sim82/6502_sbc/kicad/hdctl_01/hdctl_01.kicad_pcb

## KiCad design kicad/hdctl_01/hdctl_01.kicad_pcb (2025-10-18)

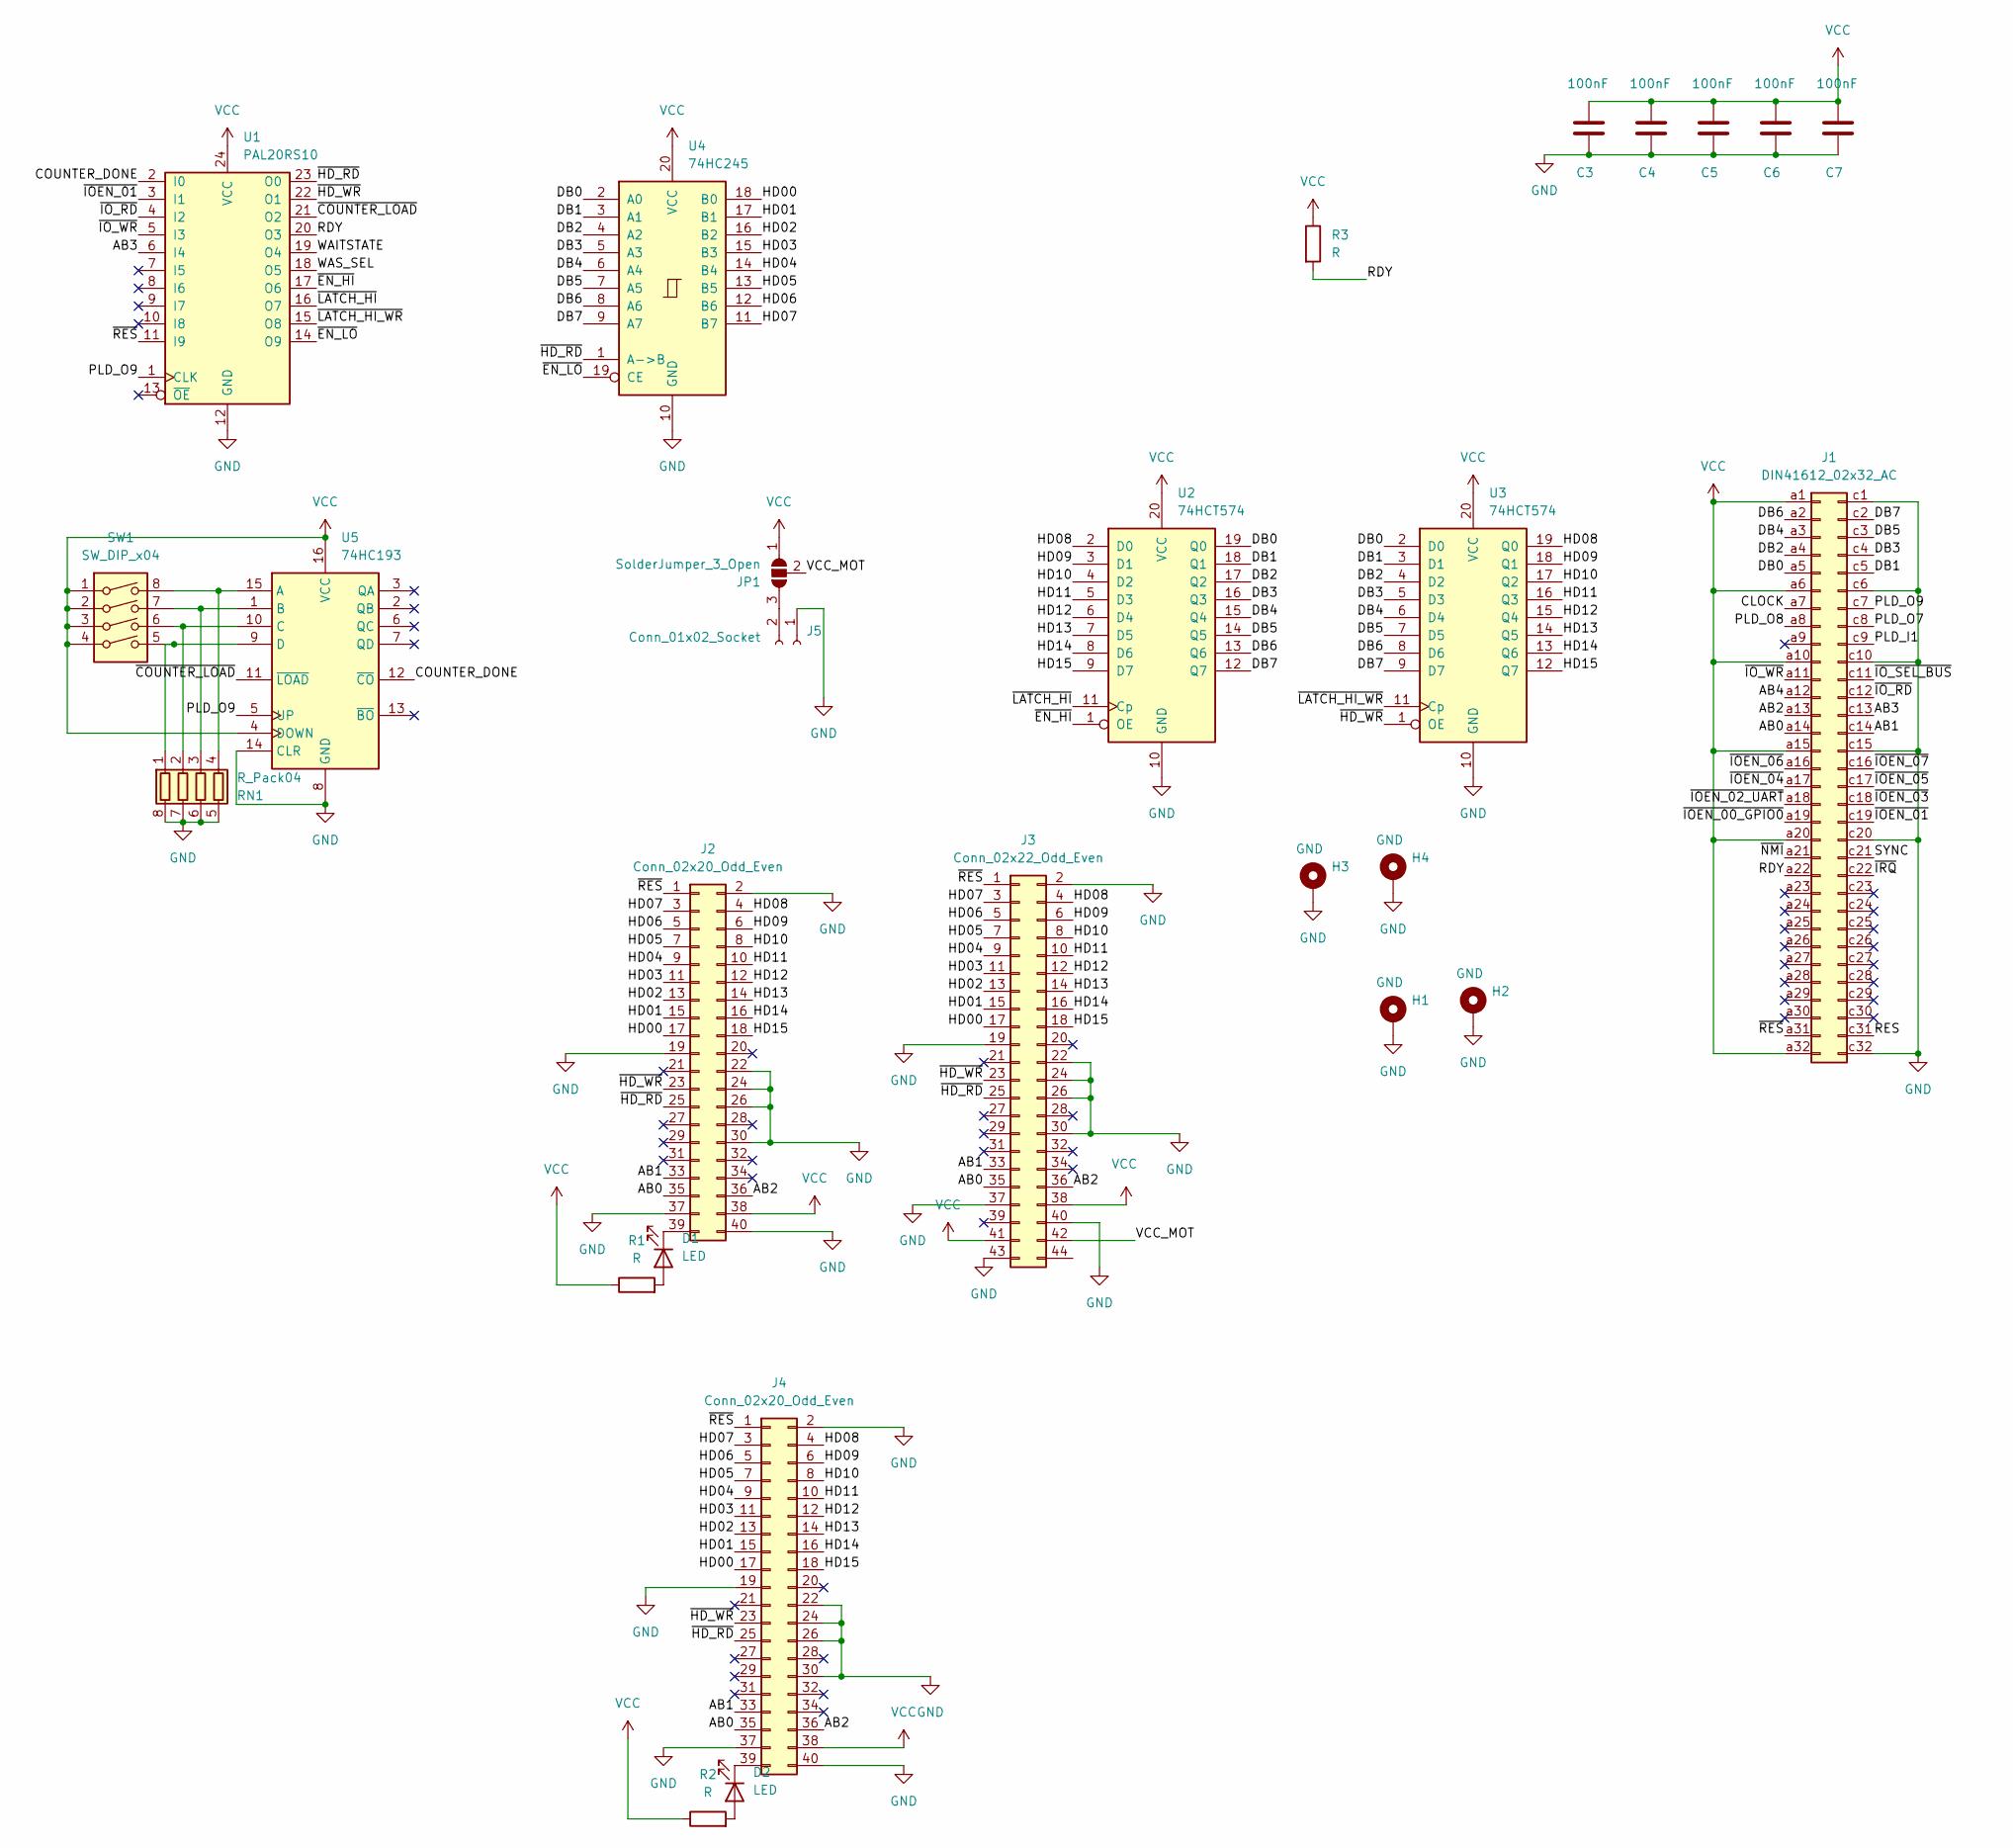
[picture p1: schematic hdctl_01.kicad_sch]

Parts:
C3, C4, C5, C6, C7: 100nF; C_0805_2012Metric_Pad1.18x1.45mm_HandSolder
D1, D2: LED; LED_0805_2012Metric_Pad1.15x1.40mm_HandSolder
H1, H2, H3, H4: GND; MountingHole_3.2mm_M3_DIN965_Pad
J1: DIN41612_02x32_AC; DIN41612_C_2x32_Male_Horizontal_THT
J2, J4: Conn_02x20_Odd_Even; IDC-Header_2x20_P2.54mm_Vertical
J3: Conn_02x22_Odd_Even; PinSocket_2x22_P2.00mm_Horizontal
J5: Conn_01x02_Socket; PinSocket_1x02_P2.54mm_Vertical
JP1: SolderJumper_3_Open; SolderJumper-3_P1.3mm_Open_RoundedPad1.0x1.5mm
R1, R2: R; R_0805_2012Metric_Pad1.20x1.40mm_HandSolder
R3: R; R_Axial_DIN0207_L6.3mm_D2.5mm_P7.62mm_Horizontal
RN1: R_Pack04; R_Array_Convex_4x0612
SW1: SW_DIP_x04; SW_DIP_SPSTx04_Slide_9.78x12.34mm_W8.61mm_P2.54mm
U1: PAL20RS10; DIP-24_W7.62mm_Socket
U2, U3: 74HCT574; SO-20_12.8x7.5mm_P1.27mm
U4: 74HC245; SO-20_12.8x7.5mm_P1.27mm
U5: 74HC193; SO-16_3.9x9.9mm_P1.27mm

Connections:
/AB0: J1.a14, J2.35, J3.35, J4.35
/AB1: J1.c14, J2.33, J3.33, J4.33
/AB2: J1.a13, J2.36, J3.36, J4.36
/AB3: J1.c13, U1.6 (I4)
/AB4: J1.a12
/CLOCK: J1.a7
/COUNTER_DONE: U1.2 (I0), U5.12 (~CO)
/DB0: J1.a5, U2.19 (Q0), U3.2 (D0), U4.2 (A0)
/DB1: J1.c5, U2.18 (Q1), U3.3 (D1), U4.3 (A1)
/DB2: J1.a4, U2.17 (Q2), U3.4 (D2), U4.4 (A2)
/DB3: J1.c4, U2.16 (Q3), U3.5 (D3), U4.5 (A3)
/DB4: J1.a3, U2.15 (Q4), U3.6 (D4), U4.6 (A4)
/DB5: J1.c3, U2.14 (Q5), U3.7 (D5), U4.7 (A5)
/DB6: J1.a2, U2.13 (Q6), U3.8 (D6), U4.8 (A6)
/DB7: J1.c2, U2.12 (Q7), U3.9 (D7), U4.9 (A7)
/HD00: J2.17, J3.17, J4.17, U4.18 (B0)
/HD01: J2.15, J3.15, J4.15, U4.17 (B1)
/HD02: J2.13, J3.13, J4.13, U4.16 (B2)
/HD03: J2.11, J3.11, J4.11, U4.15 (B3)
/HD04: J2.9, J3.9, J4.9, U4.14 (B4)
/HD05: J2.7, J3.7, J4.7, U4.13 (B5)
/HD06: J2.5, J3.5, J4.5, U4.12 (B6)
/HD07: J2.3, J3.3, J4.3, U4.11 (B7)
/HD08: J2.4, J3.4, J4.4, U2.2 (D0), U3.19 (Q0)
/HD09: J2.6, J3.6, J4.6, U2.3 (D1), U3.18 (Q1)
/HD10: J2.8, J3.8, J4.8, U2.4 (D2), U3.17 (Q2)
/HD11: J2.10, J3.10, J4.10, U2.5 (D3), U3.16 (Q3)
/HD12: J2.12, J3.12, J4.12, U2.6 (D4), U3.15 (Q4)
/HD13: J2.14, J3.14, J4.14, U2.7 (D5), U3.14 (Q5)
/HD14: J2.16, J3.16, J4.16, U2.8 (D6), U3.13 (Q6)
/HD15: J2.18, J3.18, J4.18, U2.9 (D7), U3.12 (Q7)
/PLD_I1: J1.c9
/PLD_O7: J1.c8
/PLD_O8: J1.a8
/PLD_O9: J1.c7, U1.1 (CLK), U5.5 (UP)
/RDY: J1.a22, R3.2, U1.20 (O3)
/RES: J1.c31
/SYNC: J1.c21
/VCC_MOT: J3.42, JP1.2 (C)
/WAITSTATE: U1.19 (O4)
/WAS_SEL: U1.18 (O5)
/~COUNTER_LOAD: U1.21 (O2), U5.11 (~LOAD)
/~EN_HI: U1.17 (O6), U2.1 (OE)
/~EN_LO: U1.14 (O9), U4.19 (CE)
/~HD_RD: J2.25, J3.25, J4.25, U1.23 (O0), U4.1 (A->B)
/~HD_WR: J2.23, J3.23, J4.23, U1.22 (O1), U3.1 (OE)
/~IOEN_00_GPIO0: J1.a19
/~IOEN_01: J1.c19, U1.3 (I1)
/~IOEN_02_UART: J1.a18
/~IOEN_03: J1.c18
/~IOEN_04: J1.a17
/~IOEN_05: J1.c17
/~IOEN_06: J1.a16
/~IOEN_07: J1.c16
/~IO_RD: J1.c12, U1.4 (I2)
/~IO_SEL_BUS: J1.c11
/~IO_WR: J1.a11, U1.5 (I3)
/~IRQ: J1.c22
/~LATCH_HI_WR: U1.15 (O8), U3.11 (Cp)
/~LATCH_HI: U1.16 (O7), U2.11 (Cp)
/~NMI: J1.a21
/~RES: J1.a31, J2.1, J3.1, J4.1, U1.11 (I9)
GND: C3.2, C4.2, C5.2, C6.2, C7.2, H1.1, H2.1, H3.1, H4.1, J1.c1, J1.c6, J1.c10, J1.c15, J1.c20, J1.c32, J2.2, J2.19, J2.22, J2.24, J2.26, J2.30, J2.37, J2.40, J3.2, J3.19, J3.22, J3.24, J3.26, J3.30, J3.37, J3.40, J3.43, J4.2, J4.19, J4.22, J4.24, J4.26, J4.30, J4.37, J4.40, J5.1, RN1.5 (R4.2), RN1.6 (R3.2), RN1.7 (R2.2), RN1.8 (R1.2), U1.12 (GND), U2.10 (GND), U3.10 (GND), U4.10 (GND), U5.8 (GND), U5.14 (CLR)
unnamed: D1.2 (A), R1.2
unnamed: D1.1 (K), J2.39
unnamed: D2.2 (A), R2.2
unnamed: D2.1 (K), J4.39
unnamed: J5.2, JP1.3 (B)
unnamed: RN1.1 (R1.1), SW1.5, U5.9 (D)
unnamed: RN1.2 (R2.1), SW1.6, U5.10 (C)
unnamed: RN1.3 (R3.1), SW1.7, U5.1 (B)
unnamed: RN1.4 (R4.1), SW1.8, U5.15 (A)
VCC: C3.1, C4.1, C5.1, C6.1, C7.1, J1.a1, J1.a6, J1.a10, J1.a15, J1.a20, J1.a32, J2.38, J3.38, J3.41, J4.38, JP1.1 (A), R1.1, R2.1, R3.1, SW1.1, SW1.2, SW1.3, SW1.4, U1.24 (VCC), U2.20 (VCC), U3.20 (VCC), U4.20 (VCC), U5.4 (DOWN), U5.16 (VCC)

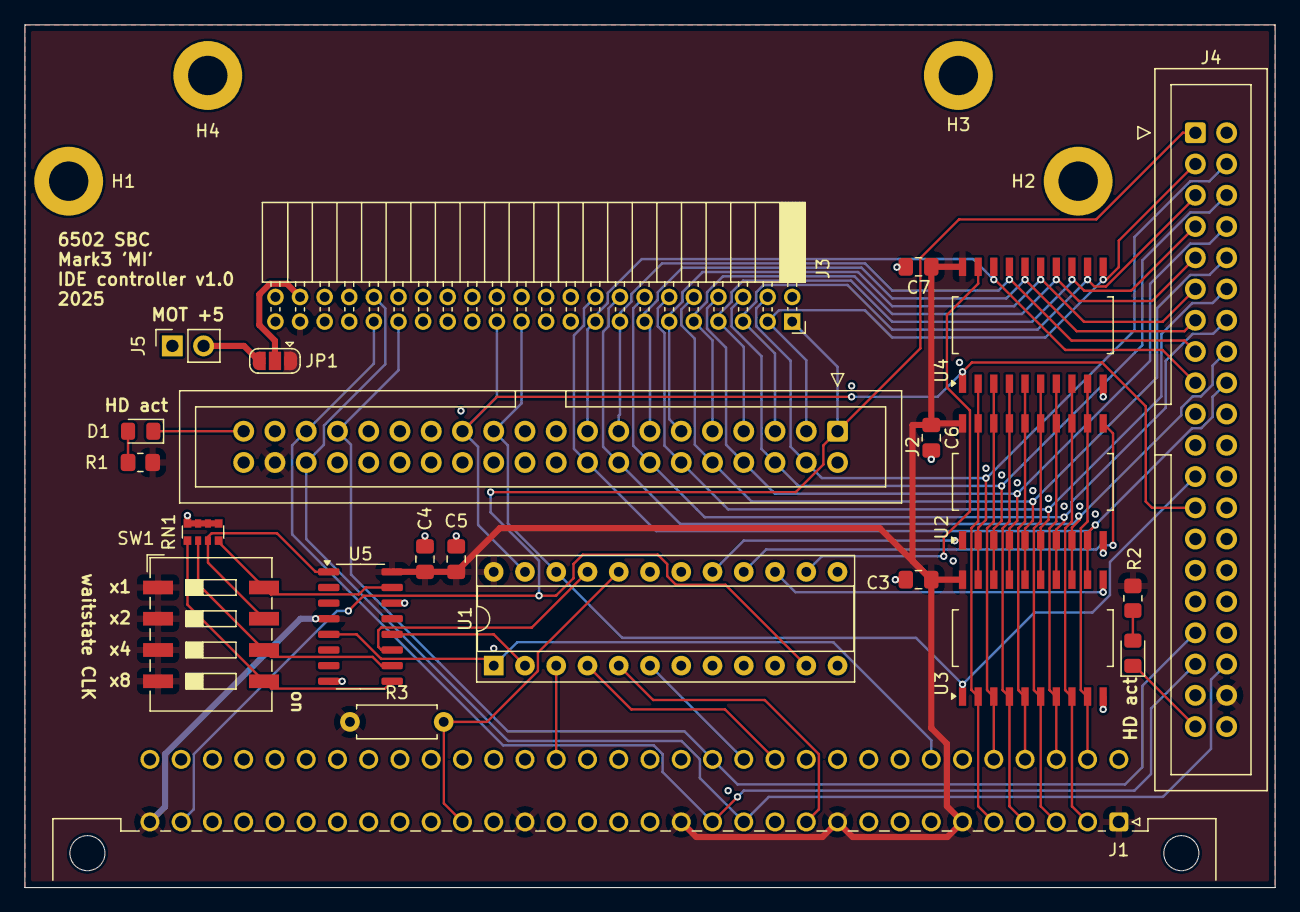
[picture p2: board hdctl_01.kicad_pcb from above]

Board: 4 copper layers, 101.6 x 70.1 mm, 27 parts (0 on the bottom side), 54 nets.
