sim82/6502_sbc/kicad/cpu_board_03_4l/cpu_board_03_4l.kicad_pcb

## KiCad design kicad/cpu_board_03_4l/cpu_board_03_4l.kicad_pcb (2025-10-05)

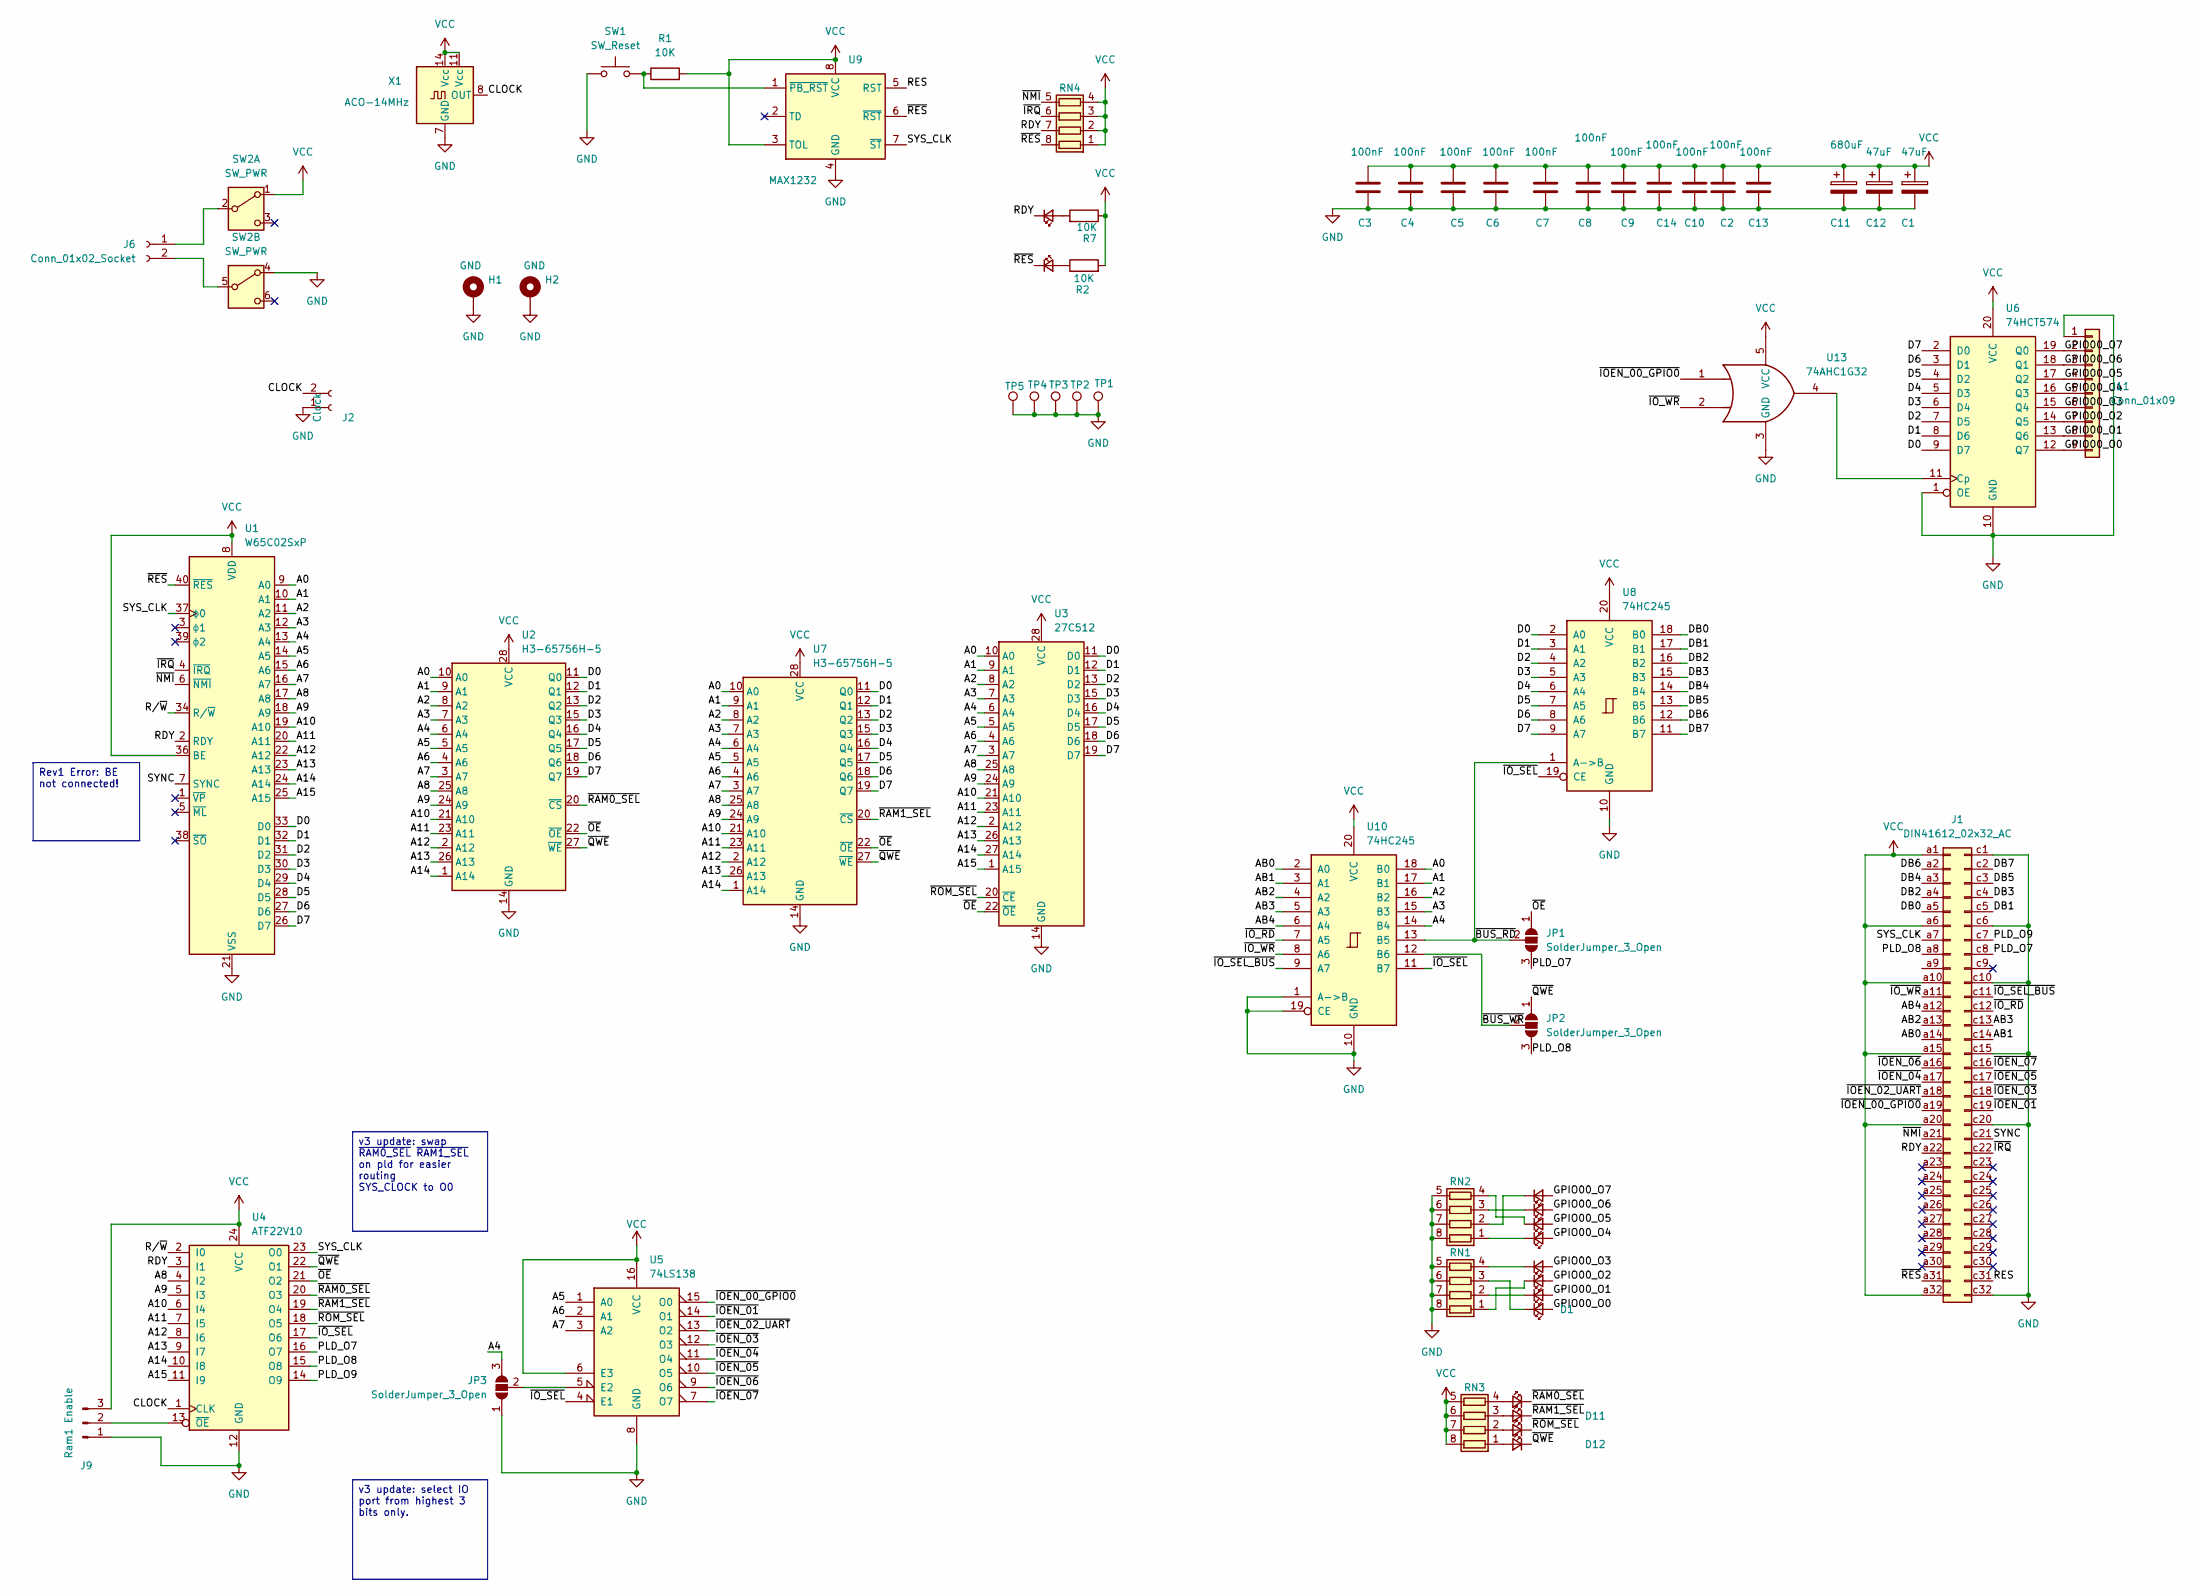
[picture p3: schematic cpu_board_03_4l.kicad_sch]

Parts:
C1, C12: 47uF; CP_Radial_D4.0mm_P2.00mm
C2, C3, C4, C5, C6, C7, C8, C9, C10, C13, C14: 100nF; C_0805_2012Metric_Pad1.18x1.45mm_HandSolder
C11: 680uF; CP_Radial_D8.0mm_P5.00mm
D1, D2, D3, D4, D5, D6, D7, D8, D9, D10, D11, D12, D13, D14: LED_Small; LED_0805_2012Metric_Pad1.15x1.40mm_HandSolder
H1, H2: GND; MountingHole_3.2mm_M3_DIN965_Pad
J1: DIN41612_02x32_AC; DIN41612_C_2x32_Male_Horizontal_THT
J2: Clock; PinSocket_1x02_P2.54mm_Vertical
J6: Conn_01x02_Socket; PinSocket_1x02_P2.54mm_Vertical
J9: Ram1 Enable; PinHeader_1x03_P2.54mm_Vertical
J11: Conn_01x09; PinSocket_1x09_P2.54mm_Vertical
JP1, JP2, JP3: SolderJumper_3_Open; SolderJumper-3_P1.3mm_Open_RoundedPad1.0x1.5mm
R1, R2, R7: 10K; R_0805_2012Metric_Pad1.20x1.40mm_HandSolder
RN1, RN2, RN3, RN4: R_Pack04; R_Array_Convex_4x0612
SW1: SW_Reset; SW_TH_Tactile_Omron_B3F-10xx
SW2: SW_PWR; 7x7DPDT
TP1, TP2, TP3, TP4, TP5: TestPoint; TestPoint_Loop_D1.80mm_Drill1.0mm_Beaded
U1: W65C02SxP; DIP-40_W15.24mm_Socket
U2, U7: H3-65756H-5; DIP-28_W7.62mm_Socket
U3: 27C512; DIP-28_W15.24mm_Socket
U4: ATF22V10; DIP-24_W7.62mm_Socket
U5: 74LS138; SO-16_3.9x9.9mm_P1.27mm
U6: 74HCT574; SO-20_12.8x7.5mm_P1.27mm
U8, U10: 74HC245; SO-20_12.8x7.5mm_P1.27mm
U9: MAX1232; SO-8_3.9x4.9mm_P1.27mm
U13: 74AHC1G32; SOT-23-5_HandSoldering
X1: ACO-14MHz; DIP-14_W7.62mm_Socket

Connections:
/A0: U1.9 (A0), U2.10 (A0), U3.10 (A0), U7.10 (A0), U10.18 (B0)
/A1: U1.10 (A1), U2.9 (A1), U3.9 (A1), U7.9 (A1), U10.17 (B1)
/A2: U1.11 (A2), U2.8 (A2), U3.8 (A2), U7.8 (A2), U10.16 (B2)
/A3: U1.12 (A3), U2.7 (A3), U3.7 (A3), U7.7 (A3), U10.15 (B3)
/A4: JP3.3 (B), U1.13 (A4), U2.6 (A4), U3.6 (A4), U7.6 (A4), U10.14 (B4)
/A5: U1.14 (A5), U2.5 (A5), U3.5 (A5), U5.1 (A0), U7.5 (A5)
/A6: U1.15 (A6), U2.4 (A6), U3.4 (A6), U5.2 (A1), U7.4 (A6)
/A7: U1.16 (A7), U2.3 (A7), U3.3 (A7), U5.3 (A2), U7.3 (A7)
/A8: U1.17 (A8), U2.25 (A8), U3.25 (A8), U4.4 (I2), U7.25 (A8)
/A9: U1.18 (A9), U2.24 (A9), U3.24 (A9), U4.5 (I3), U7.24 (A9)
/A10: U1.19 (A10), U2.21 (A10), U3.21 (A10), U4.6 (I4), U7.21 (A10)
/A11: U1.20 (A11), U2.23 (A11), U3.23 (A11), U4.7 (I5), U7.23 (A11)
/A12: U1.22 (A12), U2.2 (A12), U3.2 (A12), U4.8 (I6), U7.2 (A12)
/A13: U1.23 (A13), U2.26 (A13), U3.26 (A13), U4.9 (I7), U7.26 (A13)
/A14: U1.24 (A14), U2.1 (A14), U3.27 (A14), U4.10 (I8), U7.1 (A14)
/A15: U1.25 (A15), U3.1 (A15), U4.11 (I9)
/AB0: J1.a14, U10.2 (A0)
/AB1: J1.c14, U10.3 (A1)
/AB2: J1.a13, U10.4 (A2)
/AB3: J1.c13, U10.5 (A3)
/AB4: J1.a12, U10.6 (A4)
/CLOCK: J2.2, U4.1 (CLK), X1.8 (OUT)
/D0: U1.33 (D0), U2.11 (Q0), U3.11 (D0), U6.9 (D7), U7.11 (Q0), U8.2 (A0)
/D1: U1.32 (D1), U2.12 (Q1), U3.12 (D1), U6.8 (D6), U7.12 (Q1), U8.3 (A1)
/D2: U1.31 (D2), U2.13 (Q2), U3.13 (D2), U6.7 (D5), U7.13 (Q2), U8.4 (A2)
/D3: U1.30 (D3), U2.15 (Q3), U3.15 (D3), U6.6 (D4), U7.15 (Q3), U8.5 (A3)
/D4: U1.29 (D4), U2.16 (Q4), U3.16 (D4), U6.5 (D3), U7.16 (Q4), U8.6 (A4)
/D5: U1.28 (D5), U2.17 (Q5), U3.17 (D5), U6.4 (D2), U7.17 (Q5), U8.7 (A5)
/D6: U1.27 (D6), U2.18 (Q6), U3.18 (D6), U6.3 (D1), U7.18 (Q6), U8.8 (A6)
/D7: U1.26 (D7), U2.19 (Q7), U3.19 (D7), U6.2 (D0), U7.19 (Q7), U8.9 (A7)
/DB0: J1.a5, U8.18 (B0)
/DB1: J1.c5, U8.17 (B1)
/DB2: J1.a4, U8.16 (B2)
/DB3: J1.c4, U8.15 (B3)
/DB4: J1.a3, U8.14 (B4)
/DB5: J1.c3, U8.13 (B5)
/DB6: J1.a2, U8.12 (B6)
/DB7: J1.c2, U8.11 (B7)
/GPIO00_O0: D1.2 (A), J11.9, U6.12 (Q7)
/GPIO00_O1: D2.2 (A), J11.8, U6.13 (Q6)
/GPIO00_O2: D3.2 (A), J11.7, U6.14 (Q5)
/GPIO00_O3: D4.2 (A), J11.6, U6.15 (Q4)
/GPIO00_O4: D5.2 (A), J11.5, U6.16 (Q3)
/GPIO00_O5: D6.2 (A), J11.4, U6.17 (Q2)
/GPIO00_O6: D7.2 (A), J11.3, U6.18 (Q1)
/GPIO00_O7: D8.2 (A), J11.2, U6.19 (Q0)
/PLD_O7: J1.c8, JP1.3 (B), U4.16 (O7)
/PLD_O8: J1.a8, JP2.3 (B), U4.15 (O8)
/PLD_O9: J1.c7, U4.14 (O9)
/RDY: D14.1 (K), J1.a22, RN4.7 (R2.2), U1.2 (RDY), U4.3 (I1)
/RES: J1.c31, U9.5 (RST)
/R/~W: U1.34 (R/~W), U4.2 (I0)
/SYNC: J1.c21, U1.7 (SYNC)
/SYS_CLK: J1.a7, U1.37 (ϕ0), U4.23 (O0), U9.7 (~ST)
/~BUS_RD: JP1.2 (C), U8.1 (A->B), U10.13 (B5)
/~BUS_WR: JP2.2 (C), U10.12 (B6)
/~IOEN_00_GPIO0: J1.a19, U5.15 (O0), U13.1
/~IOEN_01: J1.c19, U5.14 (O1)
/~IOEN_02_UART: J1.a18, U5.13 (O2)
/~IOEN_03: J1.c18, U5.12 (O3)
/~IOEN_04: J1.a17, U5.11 (O4)
/~IOEN_05: J1.c17, U5.10 (O5)
/~IOEN_06: J1.a16, U5.9 (O6)
/~IOEN_07: J1.c16, U5.7 (O7)
/~IO_RD: J1.c12, U10.7 (A5)
/~IO_SEL_BUS: J1.c11, U10.9 (A7)
/~IO_SEL: U4.17 (O6), U5.4 (E1), U8.19 (CE), U10.11 (B7)
/~IO_WR: J1.a11, U10.8 (A6), U13.2
/~IRQ: J1.c22, RN4.6 (R3.2), U1.4 (~IRQ)
/~NMI: J1.a21, RN4.5 (R4.2), U1.6 (~NMI)
/~OE: JP1.1 (A), U2.22 (~OE), U3.22 (~OE), U4.21 (O2), U7.22 (~OE)
/~QWE: D12.1 (K), JP2.1 (A), U2.27 (~WE), U4.22 (O1), U7.27 (~WE)
/~RAM0_SEL: D10.1 (K), U2.20 (~CS), U4.20 (O3)
/~RAM1_SEL: D11.1 (K), U4.19 (O4), U7.20 (~CS)
/~RES: D13.1 (K), J1.a31, RN4.8 (R1.2), U1.40 (~RES), U9.6 (~RST)
/~ROM_SEL: D9.1 (K), U3.20 (~CE), U4.18 (O5)
GND: C1.2, C2.2, C3.2, C4.2, C5.2, C6.2, C7.2, C8.2, C9.2, C10.2, C11.2, C12.2, C13.2, C14.2, H1.1, H2.1, J1.c1, J1.c6, J1.c10, J1.c15, J1.c20, J1.c32, J2.1, J9.1, J11.1, JP3.1 (A), RN1.5 (R4.2), RN1.6 (R3.2), RN1.7 (R2.2), RN1.8 (R1.2), RN2.5 (R4.2), RN2.6 (R3.2), RN2.7 (R2.2), RN2.8 (R1.2), SW1.2, SW2.4 (A), TP1.1, TP2.1, TP3.1, TP4.1, TP5.1, U1.21 (VSS), U2.14 (GND), U3.14 (GND), U4.12 (GND), U5.8 (GND), U6.1 (OE), U6.10 (GND), U7.14 (GND), U8.10 (GND), U9.4 (GND), U10.1 (A->B), U10.10 (GND), U10.19 (CE), U13.3 (GND), X1.7 (GND)
unnamed: D1.1 (K), RN1.3 (R3.1)
unnamed: D2.1 (K), RN1.2 (R2.1)
unnamed: D3.1 (K), RN1.1 (R1.1)
unnamed: D4.1 (K), RN1.4 (R4.1)
unnamed: D5.1 (K), RN2.1 (R1.1)
unnamed: D6.1 (K), RN2.4 (R4.1)
unnamed: D7.1 (K), RN2.3 (R3.1)
unnamed: D8.1 (K), RN2.2 (R2.1)
unnamed: D9.2 (A), RN3.2 (R2.1)
unnamed: D10.2 (A), RN3.4 (R4.1)
unnamed: D11.2 (A), RN3.3 (R3.1)
unnamed: D12.2 (A), RN3.1 (R1.1)
unnamed: D13.2 (A), R2.1
unnamed: D14.2 (A), R7.2
unnamed: J6.1, SW2.2 (B)
unnamed: J6.2, SW2.5 (B)
unnamed: J9.2, U4.13 (~OE)
unnamed: JP3.2 (C), U5.5 (E2)
unnamed: U6.11 (Cp), U13.4
unnamed: R1.1, SW1.1, U9.1 (~PB_RST)
VCC: C1.1, C2.1, C3.1, C4.1, C5.1, C6.1, C7.1, C8.1, C9.1, C10.1, C11.1, C12.1, C13.1, C14.1, J1.a1, J1.a6, J1.a10, J1.a15, J1.a20, J1.a32, J9.3, R1.2, R2.2, R7.1, RN3.5 (R4.2), RN3.6 (R3.2), RN3.7 (R2.2), RN3.8 (R1.2), RN4.1 (R1.1), RN4.2 (R2.1), RN4.3 (R3.1), RN4.4 (R4.1), SW2.1 (A), U1.8 (VDD), U1.36 (BE), U2.28 (VCC), U3.28 (VCC), U4.24 (VCC), U5.6 (E3), U5.16 (VCC), U6.20 (VCC), U7.28 (VCC), U8.20 (VCC), U9.3 (TOL), U9.8 (VCC), U10.20 (VCC), U13.5 (VCC), X1.11 (Vcc), X1.14 (Vcc)

Notes on the sheet:
Rev1 Error: BE not connected!
v3 update: select IO port from highest 3 bits only.
v3 update: swap ~{RAM0_SEL} ~{RAM1_SEL} on pld for easier routing SYS_CLOCK to O0

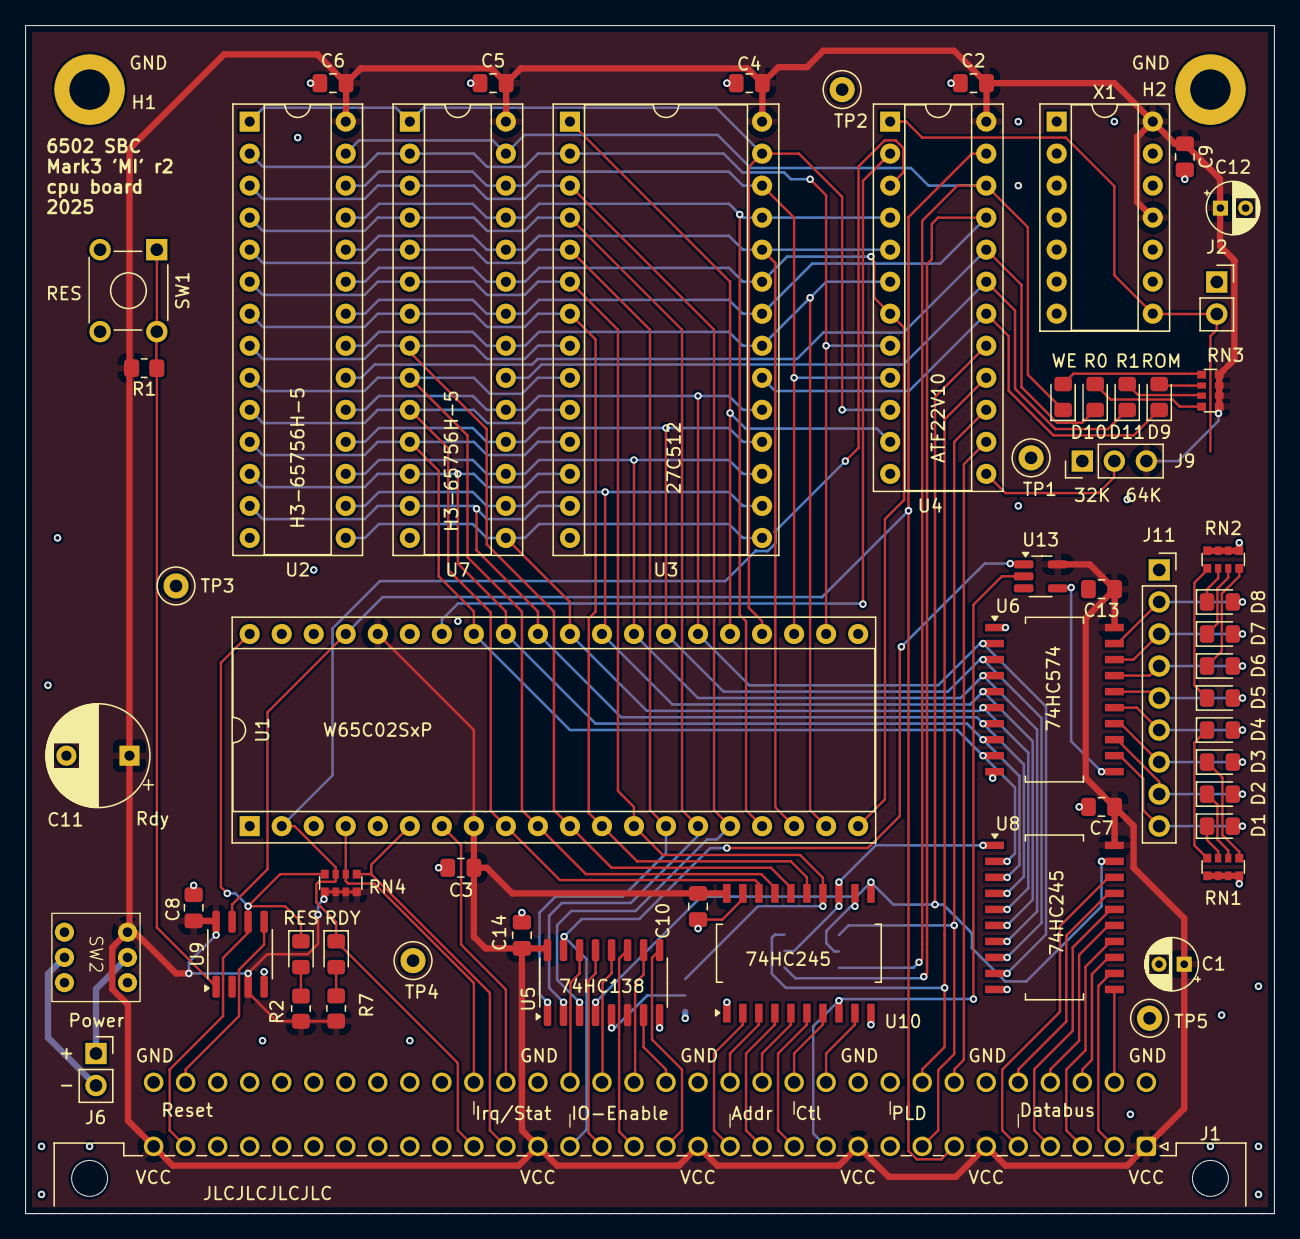
[picture p4: board cpu_board_03_4l.kicad_pcb from above]

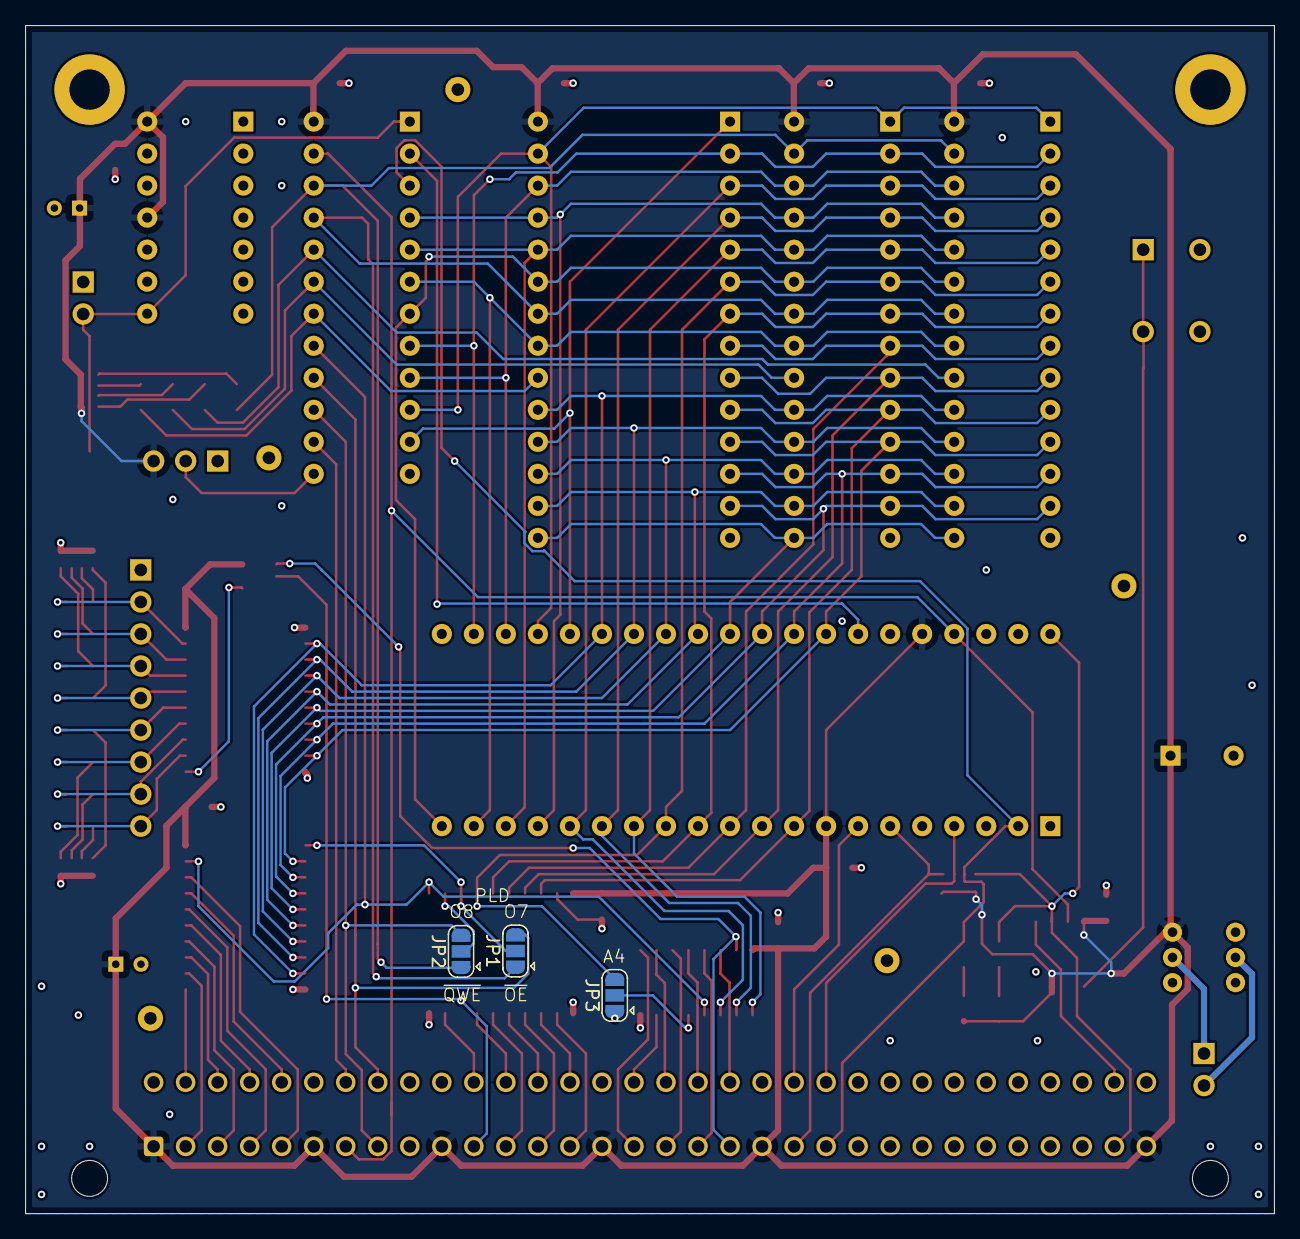
[picture p5: board cpu_board_03_4l.kicad_pcb from below]

Board: 4 copper layers, 99.1 x 94.2 mm, 64 parts (3 on the bottom side), 98 nets.
