sim82/6502_sbc/kicad/vga_mem_output_01_4l/vga_mem_output_01_4l.kicad_pcb

## KiCad design kicad/vga_mem_output_01_4l/vga_mem_output_01_4l.kicad_pcb (2025-09-13)

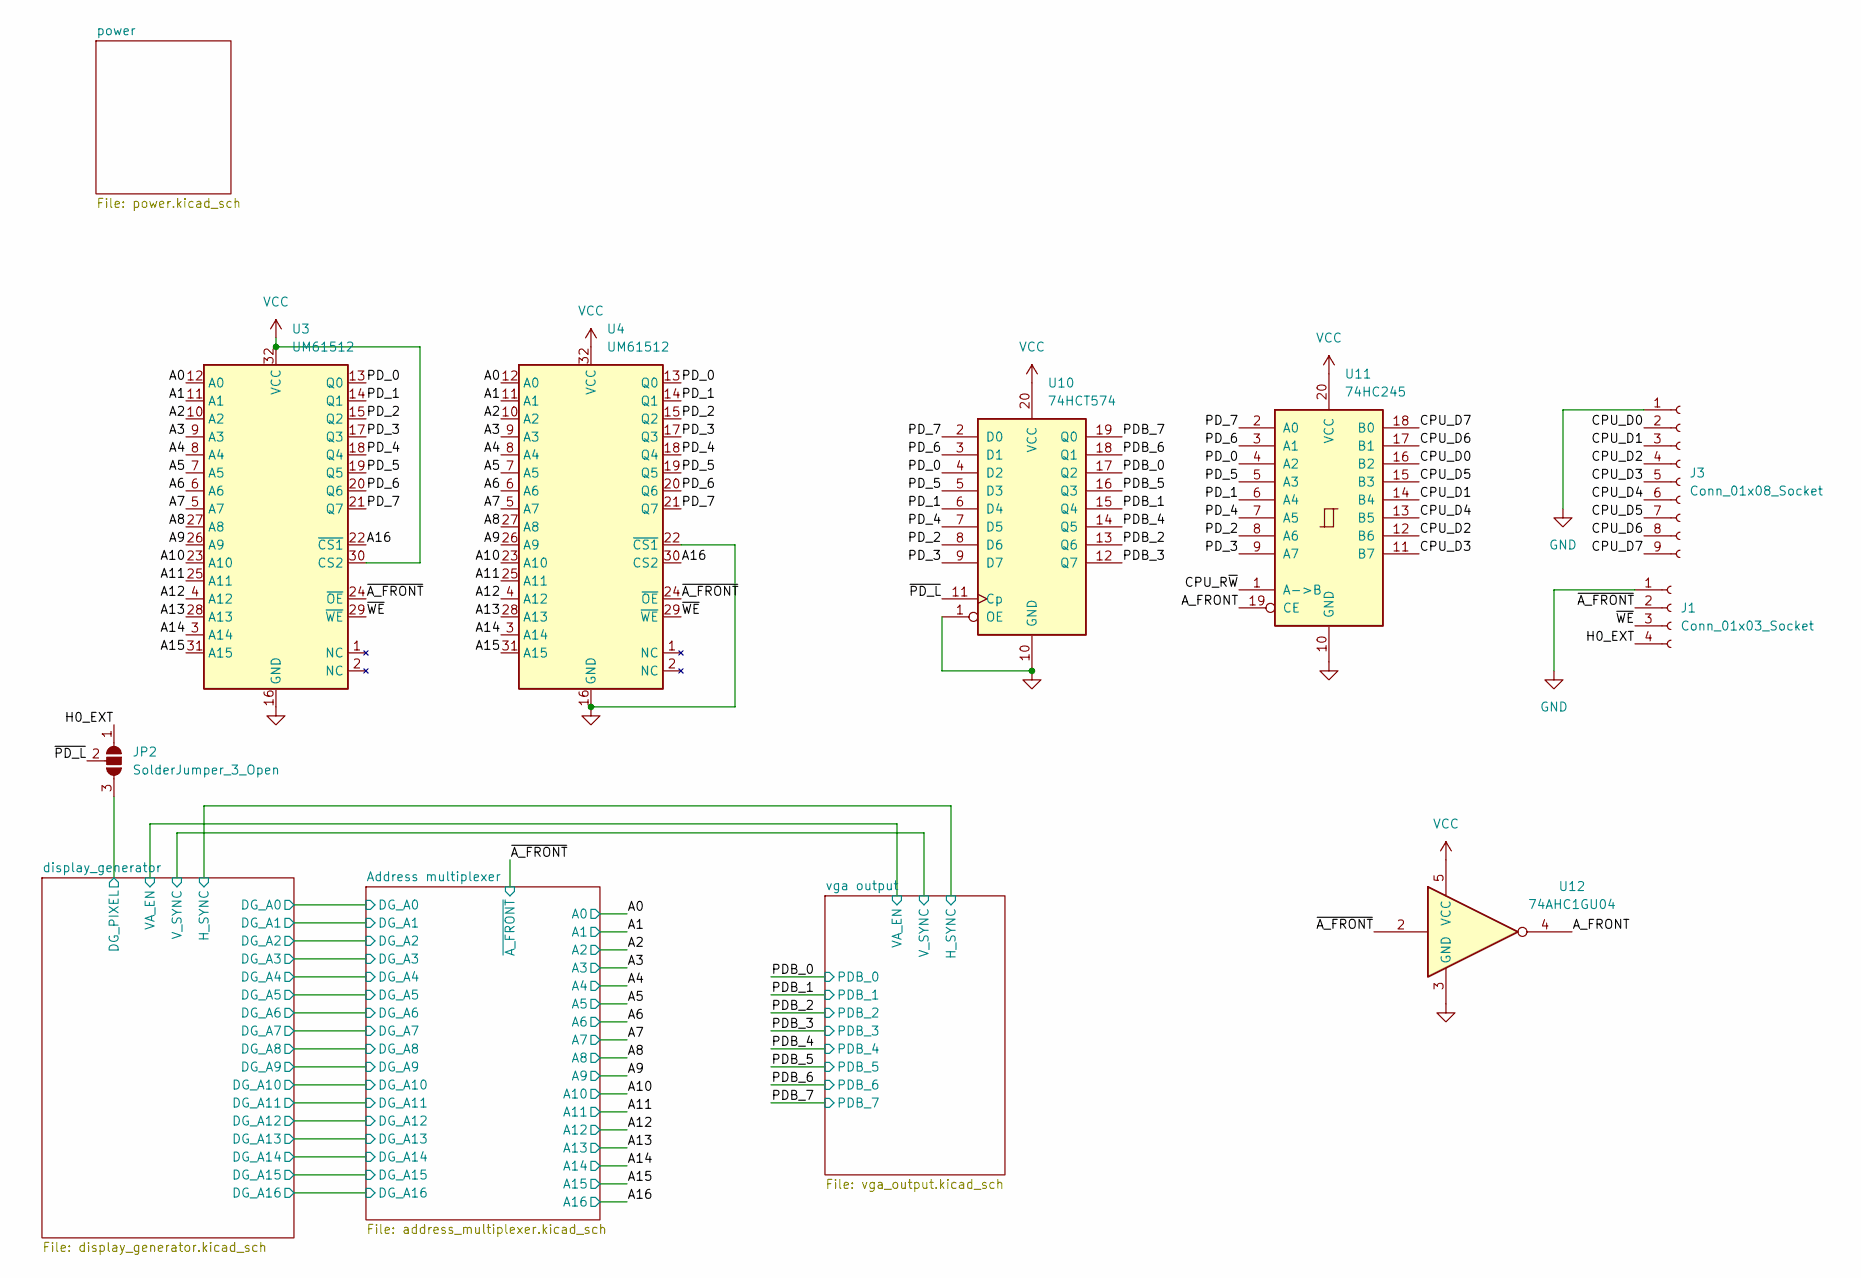
[picture p6: schematic vga_mem_output_01_4l.kicad_sch]

Parts:
J1: Conn_01x03_Socket; PinSocket_1x04_P2.54mm_Vertical
J3: Conn_01x08_Socket; PinSocket_1x09_P2.54mm_Vertical
JP2: SolderJumper_3_Open; SolderJumper-3_P1.3mm_Open_RoundedPad1.0x1.5mm
U3, U4: UM61512; DIP-32_W7.62mm
U10: 74HCT574; SO-20_12.8x7.5mm_P1.27mm
U11: 74HC245; SO-20_12.8x7.5mm_P1.27mm
U12: 74AHC1GU04; SOT-23-5_HandSoldering

Connections:
/A0: U3.12 (A0), U4.12 (A0); also elsewhere on the board
/A1: U3.11 (A1), U4.11 (A1); also elsewhere on the board
/A2: U3.10 (A2), U4.10 (A2); also elsewhere on the board
/A3: U3.9 (A3), U4.9 (A3); also elsewhere on the board
/A4: U3.8 (A4), U4.8 (A4); also elsewhere on the board
/A5: U3.7 (A5), U4.7 (A5); also elsewhere on the board
/A6: U3.6 (A6), U4.6 (A6); also elsewhere on the board
/A7: U3.5 (A7), U4.5 (A7); also elsewhere on the board
/A8: U3.27 (A8), U4.27 (A8); also elsewhere on the board
/A9: U3.26 (A9), U4.26 (A9); also elsewhere on the board
/A10: U3.23 (A10), U4.23 (A10); also elsewhere on the board
/A11: U3.25 (A11), U4.25 (A11); also elsewhere on the board
/A12: U3.4 (A12), U4.4 (A12); also elsewhere on the board
/A13: U3.28 (A13), U4.28 (A13); also elsewhere on the board
/A14: U3.3 (A14), U4.3 (A14); also elsewhere on the board
/A15: U3.31 (A15), U4.31 (A15); also elsewhere on the board
/A16: U3.22 (~CS1), U4.30 (CS2); also elsewhere on the board
/A_FRONT: U11.19 (CE), U12.4
/CPU_D0: J3.2, U11.16 (B2)
/CPU_D1: J3.3, U11.14 (B4)
/CPU_D2: J3.4, U11.12 (B6)
/CPU_D3: J3.5, U11.11 (B7)
/CPU_D4: J3.6, U11.13 (B5)
/CPU_D5: J3.7, U11.15 (B3)
/CPU_D6: J3.8, U11.17 (B1)
/CPU_D7: J3.9, U11.18 (B0)
/CPU_R~W: U11.1 (A->B)
/H0_EXT: J1.4, JP2.1 (A)
/PDB_0: U10.17 (Q2); also elsewhere on the board
/PDB_1: U10.15 (Q4); also elsewhere on the board
/PDB_2: U10.13 (Q6); also elsewhere on the board
/PDB_3: U10.12 (Q7); also elsewhere on the board
/PDB_4: U10.14 (Q5); also elsewhere on the board
/PDB_5: U10.16 (Q3); also elsewhere on the board
/PDB_6: U10.18 (Q1); also elsewhere on the board
/PDB_7: U10.19 (Q0); also elsewhere on the board
/PD_0: U3.13 (Q0), U4.13 (Q0), U10.4 (D2), U11.4 (A2)
/PD_1: U3.14 (Q1), U4.14 (Q1), U10.6 (D4), U11.6 (A4)
/PD_2: U3.15 (Q2), U4.15 (Q2), U10.8 (D6), U11.8 (A6)
/PD_3: U3.17 (Q3), U4.17 (Q3), U10.9 (D7), U11.9 (A7)
/PD_4: U3.18 (Q4), U4.18 (Q4), U10.7 (D5), U11.7 (A5)
/PD_5: U3.19 (Q5), U4.19 (Q5), U10.5 (D3), U11.5 (A3)
/PD_6: U3.20 (Q6), U4.20 (Q6), U10.3 (D1), U11.3 (A1)
/PD_7: U3.21 (Q7), U4.21 (Q7), U10.2 (D0), U11.2 (A0)
/display_generator/H0: JP2.3 (B); also elsewhere on the board
/~A_FRONT: J1.2, U3.24 (~OE), U4.24 (~OE), U12.2; also elsewhere on the board
/~PD_L: JP2.2 (C), U10.11 (Cp)
/~WE: J1.3, U3.29 (~WE), U4.29 (~WE)
GND: J1.1, J3.1, U3.16 (GND), U4.16 (GND), U4.22 (~CS1), U10.1 (OE), U10.10 (GND), U11.10 (GND), U12.3 (GND); also elsewhere on the board
VCC: U3.30 (CS2), U3.32 (VCC), U4.32 (VCC), U10.20 (VCC), U11.20 (VCC), U12.5 (VCC); also elsewhere on the board
