sim82/6502_sbc/kicad/vga_mem_output_01_4l/vga_mem_output_01_4l.kicad_pcb

## KiCad design kicad/vga_mem_output_01_4l/vga_mem_output_01_4l.kicad_pcb (continued)

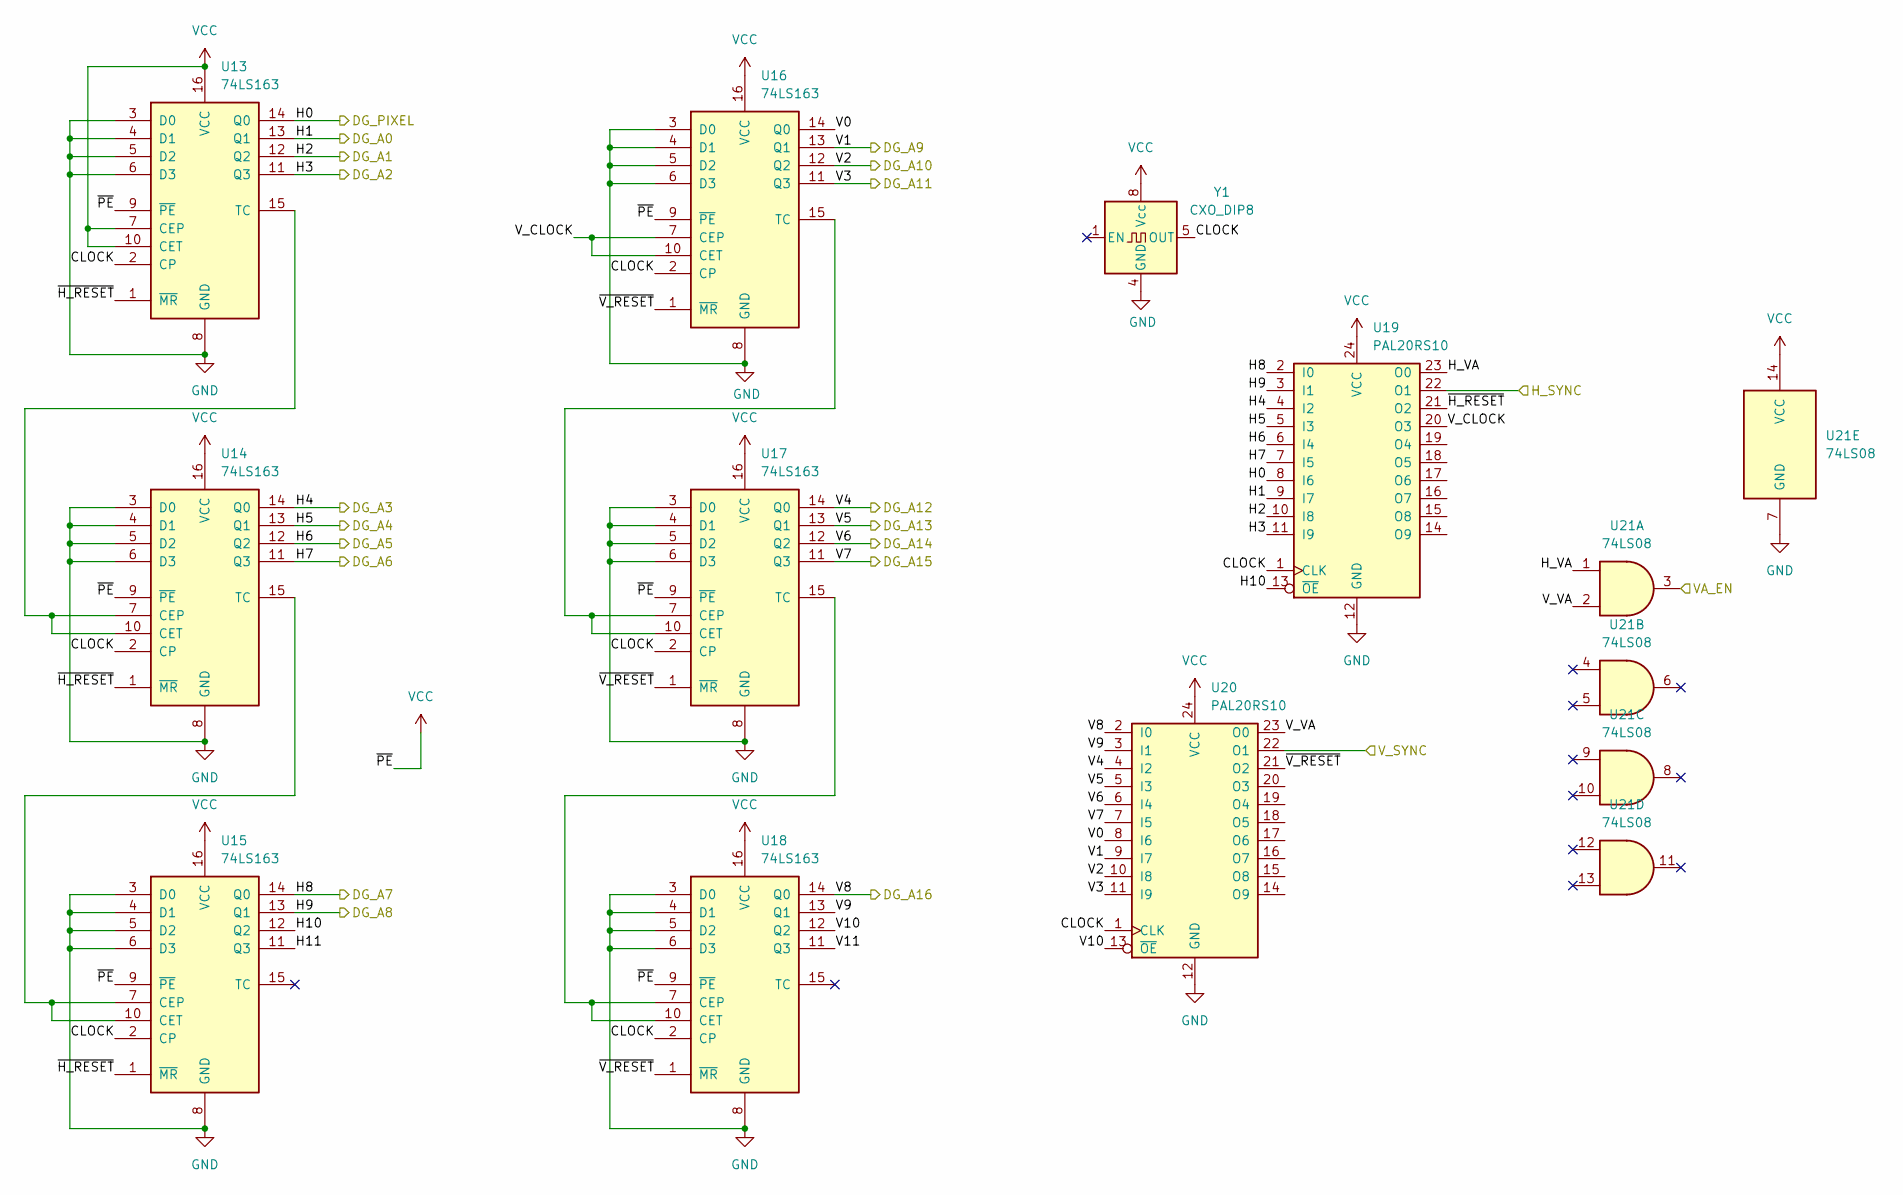
[picture p7: schematic display_generator.kicad_sch]

Parts:
U13, U14, U15, U16, U17, U18: 74LS163; SO-16_3.9x9.9mm_P1.27mm
U19, U20: PAL20RS10; DIP-24_W7.62mm_Socket
U21: 74LS08; SO-14_3.9x8.65mm_P1.27mm
Y1: CXO_DIP8; Oscillator_DIP-8

Connections:
/display_generator/CLOCK: U13.2 (CP), U14.2 (CP), U15.2 (CP), U16.2 (CP), U17.2 (CP), U18.2 (CP), U19.1 (CLK), U20.1 (CLK), Y1.5 (OUT)
/display_generator/H0: U13.14 (Q0), U19.8 (I6); also elsewhere on the board
/display_generator/H1: U13.13 (Q1), U19.9 (I7); also elsewhere on the board
/display_generator/H2: U13.12 (Q2), U19.10 (I8); also elsewhere on the board
/display_generator/H3: U13.11 (Q3), U19.11 (I9); also elsewhere on the board
/display_generator/H4: U14.14 (Q0), U19.4 (I2); also elsewhere on the board
/display_generator/H5: U14.13 (Q1), U19.5 (I3); also elsewhere on the board
/display_generator/H6: U14.12 (Q2), U19.6 (I4); also elsewhere on the board
/display_generator/H7: U14.11 (Q3), U19.7 (I5); also elsewhere on the board
/display_generator/H8: U15.14 (Q0), U19.2 (I0); also elsewhere on the board
/display_generator/H9: U15.13 (Q1), U19.3 (I1); also elsewhere on the board
/display_generator/H10: U15.12 (Q2), U19.13 (~OE)
/display_generator/H11: U15.11 (Q3)
/display_generator/H_SYNC: U19.22 (O1); also elsewhere on the board
/display_generator/H_VA: U19.23 (O0), U21.1
/display_generator/V0: U16.14 (Q0), U20.8 (I6)
/display_generator/V1: U16.13 (Q1), U20.9 (I7); also elsewhere on the board
/display_generator/V2: U16.12 (Q2), U20.10 (I8); also elsewhere on the board
/display_generator/V3: U16.11 (Q3), U20.11 (I9); also elsewhere on the board
/display_generator/V4: U17.14 (Q0), U20.4 (I2); also elsewhere on the board
/display_generator/V5: U17.13 (Q1), U20.5 (I3); also elsewhere on the board
/display_generator/V6: U17.12 (Q2), U20.6 (I4); also elsewhere on the board
/display_generator/V7: U17.11 (Q3), U20.7 (I5); also elsewhere on the board
/display_generator/V8: U18.14 (Q0), U20.2 (I0); also elsewhere on the board
/display_generator/V9: U18.13 (Q1), U20.3 (I1)
/display_generator/V10: U18.12 (Q2), U20.13 (~OE)
/display_generator/V11: U18.11 (Q3)
/display_generator/VA_EN: U21.3; also elsewhere on the board
/display_generator/V_CLOCK: U16.7 (CEP), U16.10 (CET), U19.20 (O3)
/display_generator/V_SYNC: U20.22 (O1); also elsewhere on the board
/display_generator/V_VA: U20.23 (O0), U21.2
/display_generator/~H_RESET: U13.1 (~MR), U14.1 (~MR), U15.1 (~MR), U19.21 (O2)
/display_generator/~V_RESET: U16.1 (~MR), U17.1 (~MR), U18.1 (~MR), U20.21 (O2)
GND: U13.3 (D0), U13.4 (D1), U13.5 (D2), U13.6 (D3), U13.8 (GND), U14.3 (D0), U14.4 (D1), U14.5 (D2), U14.6 (D3), U14.8 (GND), U15.3 (D0), U15.4 (D1), U15.5 (D2), U15.6 (D3), U15.8 (GND), U16.3 (D0), U16.4 (D1), U16.5 (D2), U16.6 (D3), U16.8 (GND), U17.3 (D0), U17.4 (D1), U17.5 (D2), U17.6 (D3), U17.8 (GND), U18.3 (D0), U18.4 (D1), U18.5 (D2), U18.6 (D3), U18.8 (GND), U19.12 (GND), U20.12 (GND), U21.7 (GND), Y1.4 (GND); also elsewhere on the board
unnamed: U13.15 (TC), U14.7 (CEP), U14.10 (CET)
unnamed: U14.15 (TC), U15.7 (CEP), U15.10 (CET)
unnamed: U16.15 (TC), U17.7 (CEP), U17.10 (CET)
unnamed: U17.15 (TC), U18.7 (CEP), U18.10 (CET)
VCC: U13.7 (CEP), U13.9 (~PE), U13.10 (CET), U13.16 (VCC), U14.9 (~PE), U14.16 (VCC), U15.9 (~PE), U15.16 (VCC), U16.9 (~PE), U16.16 (VCC), U17.9 (~PE), U17.16 (VCC), U18.9 (~PE), U18.16 (VCC), U19.24 (VCC), U20.24 (VCC), U21.14 (VCC), Y1.8 (Vcc); also elsewhere on the board

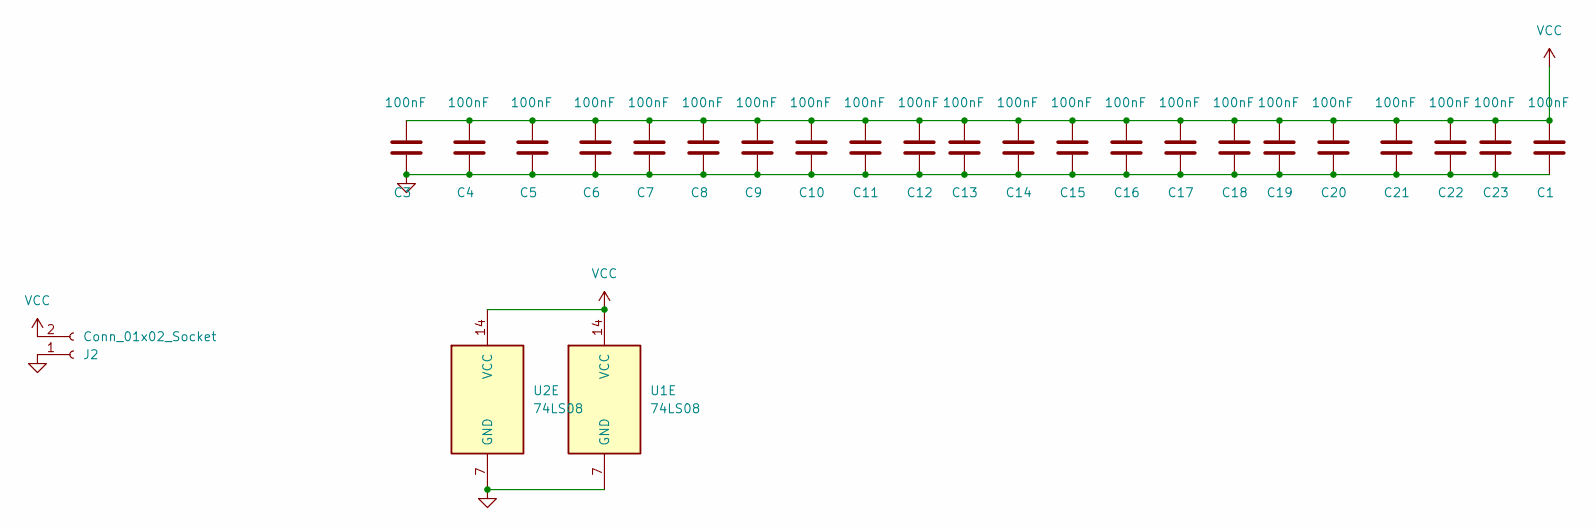
[picture p8: schematic power.kicad_sch]

Parts:
C1, C3, C4, C5, C6, C7, C8, C9, C10, C11, C12, C13, C14, C15, C16, C17, C18, C19, C20, C21, C22, C23: 100nF; C_0805_2012Metric_Pad1.18x1.45mm_HandSolder
J2: Conn_01x02_Socket; PinSocket_1x02_P2.54mm_Vertical
U1, U2: 74LS08; SO-14_3.9x8.65mm_P1.27mm

Connections:
GND: C1.2, C3.2, C4.2, C5.2, C6.2, C7.2, C8.2, C9.2, C10.2, C11.2, C12.2, C13.2, C14.2, C15.2, C16.2, C17.2, C18.2, C19.2, C20.2, C21.2, C22.2, C23.2, J2.1, U1.7 (GND), U2.7 (GND); also elsewhere on the board
VCC: C1.1, C3.1, C4.1, C5.1, C6.1, C7.1, C8.1, C9.1, C10.1, C11.1, C12.1, C13.1, C14.1, C15.1, C16.1, C17.1, C18.1, C19.1, C20.1, C21.1, C22.1, C23.1, J2.2, U1.14 (VCC), U2.14 (VCC); also elsewhere on the board

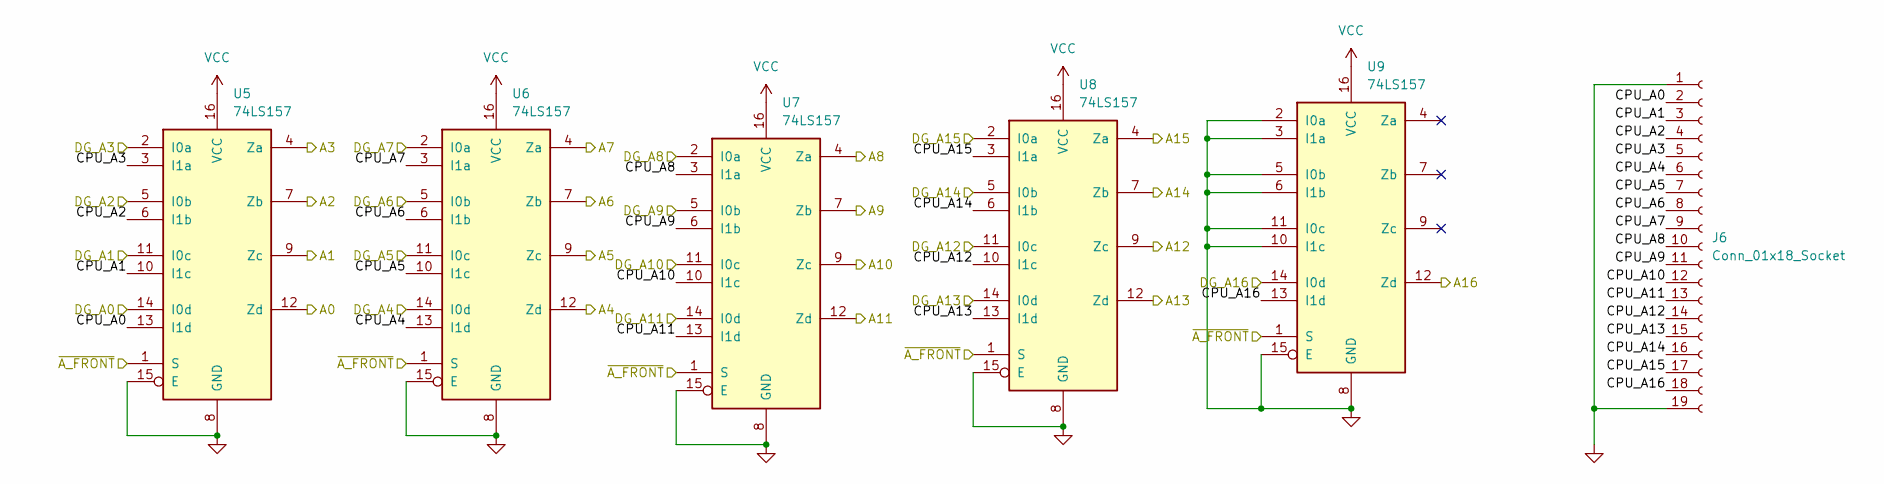
[picture p9: schematic address_multiplexer.kicad_sch]

Parts:
J6: Conn_01x18_Socket; PinHeader_1x19_P2.54mm_Vertical
U5, U6, U7, U8, U9: 74LS157; SO-16_3.9x9.9mm_P1.27mm

Connections:
/A0: U5.12 (Zd); also elsewhere on the board
/A1: U5.9 (Zc); also elsewhere on the board
/A2: U5.7 (Zb); also elsewhere on the board
/A3: U5.4 (Za); also elsewhere on the board
/A4: U6.12 (Zd); also elsewhere on the board
/A5: U6.9 (Zc); also elsewhere on the board
/A6: U6.7 (Zb); also elsewhere on the board
/A7: U6.4 (Za); also elsewhere on the board
/A8: U7.4 (Za); also elsewhere on the board
/A9: U7.7 (Zb); also elsewhere on the board
/A10: U7.9 (Zc); also elsewhere on the board
/A11: U7.12 (Zd); also elsewhere on the board
/A12: U8.9 (Zc); also elsewhere on the board
/A13: U8.12 (Zd); also elsewhere on the board
/A14: U8.7 (Zb); also elsewhere on the board
/A15: U8.4 (Za); also elsewhere on the board
/A16: U9.12 (Zd); also elsewhere on the board
/Address multiplexer/CPU_A0: J6.2, U5.13 (I1d)
/Address multiplexer/CPU_A1: J6.3, U5.10 (I1c)
/Address multiplexer/CPU_A2: J6.4, U5.6 (I1b)
/Address multiplexer/CPU_A3: J6.5, U5.3 (I1a)
/Address multiplexer/CPU_A4: J6.6, U6.13 (I1d)
/Address multiplexer/CPU_A5: J6.7, U6.10 (I1c)
/Address multiplexer/CPU_A6: J6.8, U6.6 (I1b)
/Address multiplexer/CPU_A7: J6.9, U6.3 (I1a)
/Address multiplexer/CPU_A8: J6.10, U7.3 (I1a)
/Address multiplexer/CPU_A9: J6.11, U7.6 (I1b)
/Address multiplexer/CPU_A10: J6.12, U7.10 (I1c)
/Address multiplexer/CPU_A11: J6.13, U7.13 (I1d)
/Address multiplexer/CPU_A12: J6.14, U8.10 (I1c)
/Address multiplexer/CPU_A13: J6.15, U8.13 (I1d)
/Address multiplexer/CPU_A14: J6.16, U8.6 (I1b)
/Address multiplexer/CPU_A15: J6.17, U8.3 (I1a)
/Address multiplexer/CPU_A16: J6.18, U9.13 (I1d)
/display_generator/H1: U5.14 (I0d); also elsewhere on the board
/display_generator/H2: U5.11 (I0c); also elsewhere on the board
/display_generator/H3: U5.5 (I0b); also elsewhere on the board
/display_generator/H4: U5.2 (I0a); also elsewhere on the board
/display_generator/H5: U6.14 (I0d); also elsewhere on the board
/display_generator/H6: U6.11 (I0c); also elsewhere on the board
/display_generator/H7: U6.5 (I0b); also elsewhere on the board
/display_generator/H8: U6.2 (I0a); also elsewhere on the board
/display_generator/H9: U7.2 (I0a); also elsewhere on the board
/display_generator/V1: U7.5 (I0b); also elsewhere on the board
/display_generator/V2: U7.11 (I0c); also elsewhere on the board
/display_generator/V3: U7.14 (I0d); also elsewhere on the board
/display_generator/V4: U8.11 (I0c); also elsewhere on the board
/display_generator/V5: U8.14 (I0d); also elsewhere on the board
/display_generator/V6: U8.5 (I0b); also elsewhere on the board
/display_generator/V7: U8.2 (I0a); also elsewhere on the board
/display_generator/V8: U9.14 (I0d); also elsewhere on the board
/~A_FRONT: U5.1 (S), U6.1 (S), U7.1 (S), U8.1 (S), U9.1 (S); also elsewhere on the board
GND: J6.1, J6.19, U5.8 (GND), U5.15 (E), U6.8 (GND), U6.15 (E), U7.8 (GND), U7.15 (E), U8.8 (GND), U8.15 (E), U9.2 (I0a), U9.3 (I1a), U9.5 (I0b), U9.6 (I1b), U9.8 (GND), U9.10 (I1c), U9.11 (I0c), U9.15 (E); also elsewhere on the board
VCC: U5.16 (VCC), U6.16 (VCC), U7.16 (VCC), U8.16 (VCC), U9.16 (VCC); also elsewhere on the board

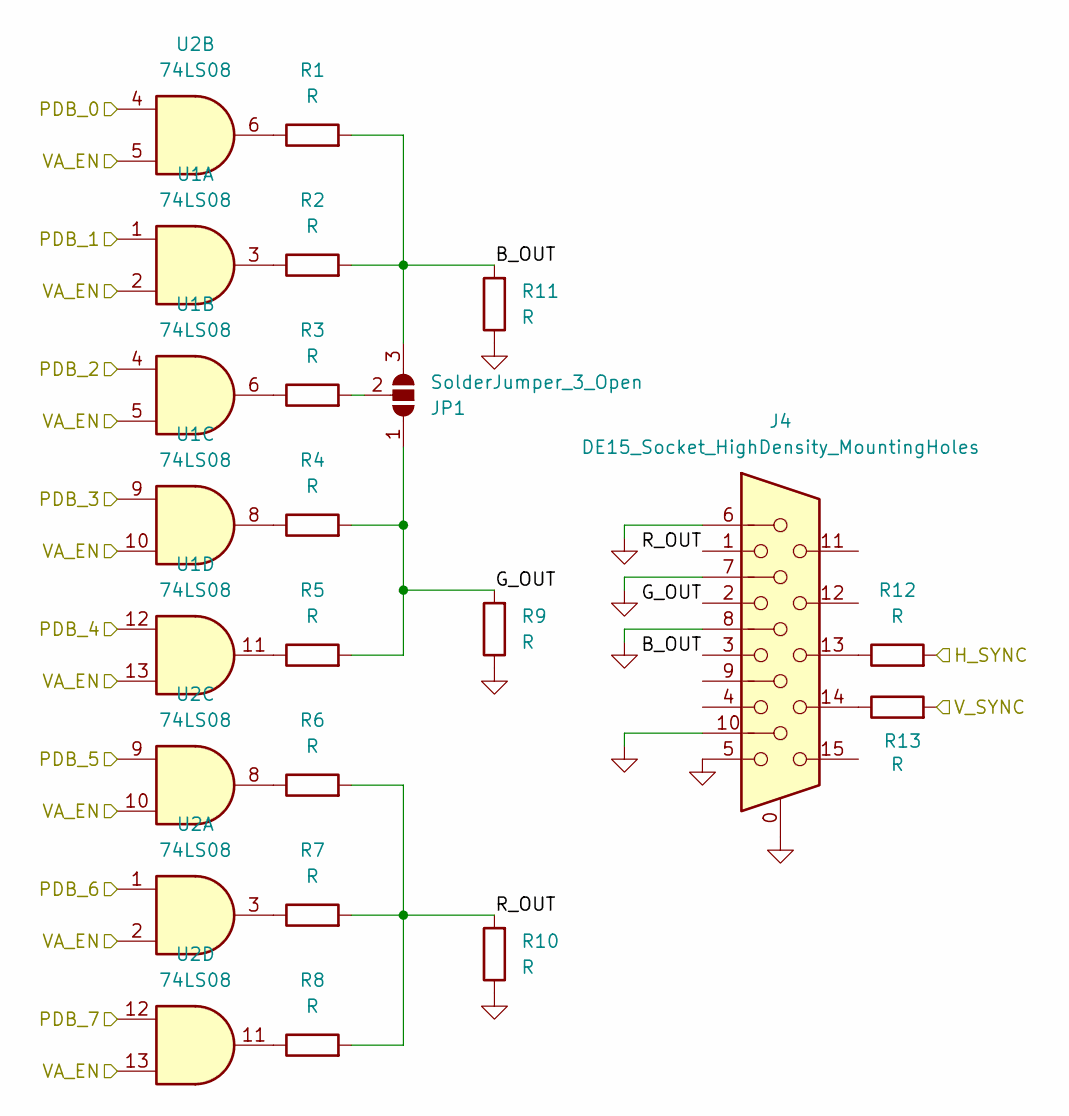
[picture p10: schematic vga_output.kicad_sch]

Parts:
J4: DE15_Socket_HighDensity_MountingHoles; DSUB-15-HD_Socket_Horizontal_P2.29x2.54mm_EdgePinOffset8.35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
JP1: SolderJumper_3_Open; SolderJumper-3_P1.3mm_Open_RoundedPad1.0x1.5mm
R1, R2, R3, R4, R5, R6, R7, R8, R9, R10, R11, R12, R13: R; R_Axial_DIN0204_L3.6mm_D1.6mm_P7.62mm_Horizontal
U1, U2: 74LS08; SO-14_3.9x8.65mm_P1.27mm

Connections:
/PDB_0: U2.4; also elsewhere on the board
/PDB_1: U1.1; also elsewhere on the board
/PDB_2: U1.4; also elsewhere on the board
/PDB_3: U1.9; also elsewhere on the board
/PDB_4: U1.12; also elsewhere on the board
/PDB_5: U2.9; also elsewhere on the board
/PDB_6: U2.1; also elsewhere on the board
/PDB_7: U2.12; also elsewhere on the board
/display_generator/H_SYNC: R12.2; also elsewhere on the board
/display_generator/VA_EN: U1.2, U1.5, U1.10, U1.13, U2.2, U2.5, U2.10, U2.13; also elsewhere on the board
/display_generator/V_SYNC: R13.2; also elsewhere on the board
/vga output/B_OUT: J4.3, JP1.3 (B), R1.2, R2.2, R11.2
/vga output/G_OUT: J4.2, JP1.1 (A), R4.2, R5.2, R9.2
/vga output/R_OUT: J4.1, R6.2, R7.2, R8.2, R10.2
GND: J4.0, J4.5, J4.6, J4.7, J4.8, J4.10, R9.1, R10.1, R11.1; also elsewhere on the board
unnamed: J4.13, R12.1
unnamed: J4.14, R13.1
unnamed: JP1.2 (C), R3.2
unnamed: R1.1, U2.6
unnamed: R2.1, U1.3
unnamed: R3.1, U1.6
unnamed: R4.1, U1.8
unnamed: R5.1, U1.11
unnamed: R6.1, U2.8
unnamed: R7.1, U2.3
unnamed: R8.1, U2.11

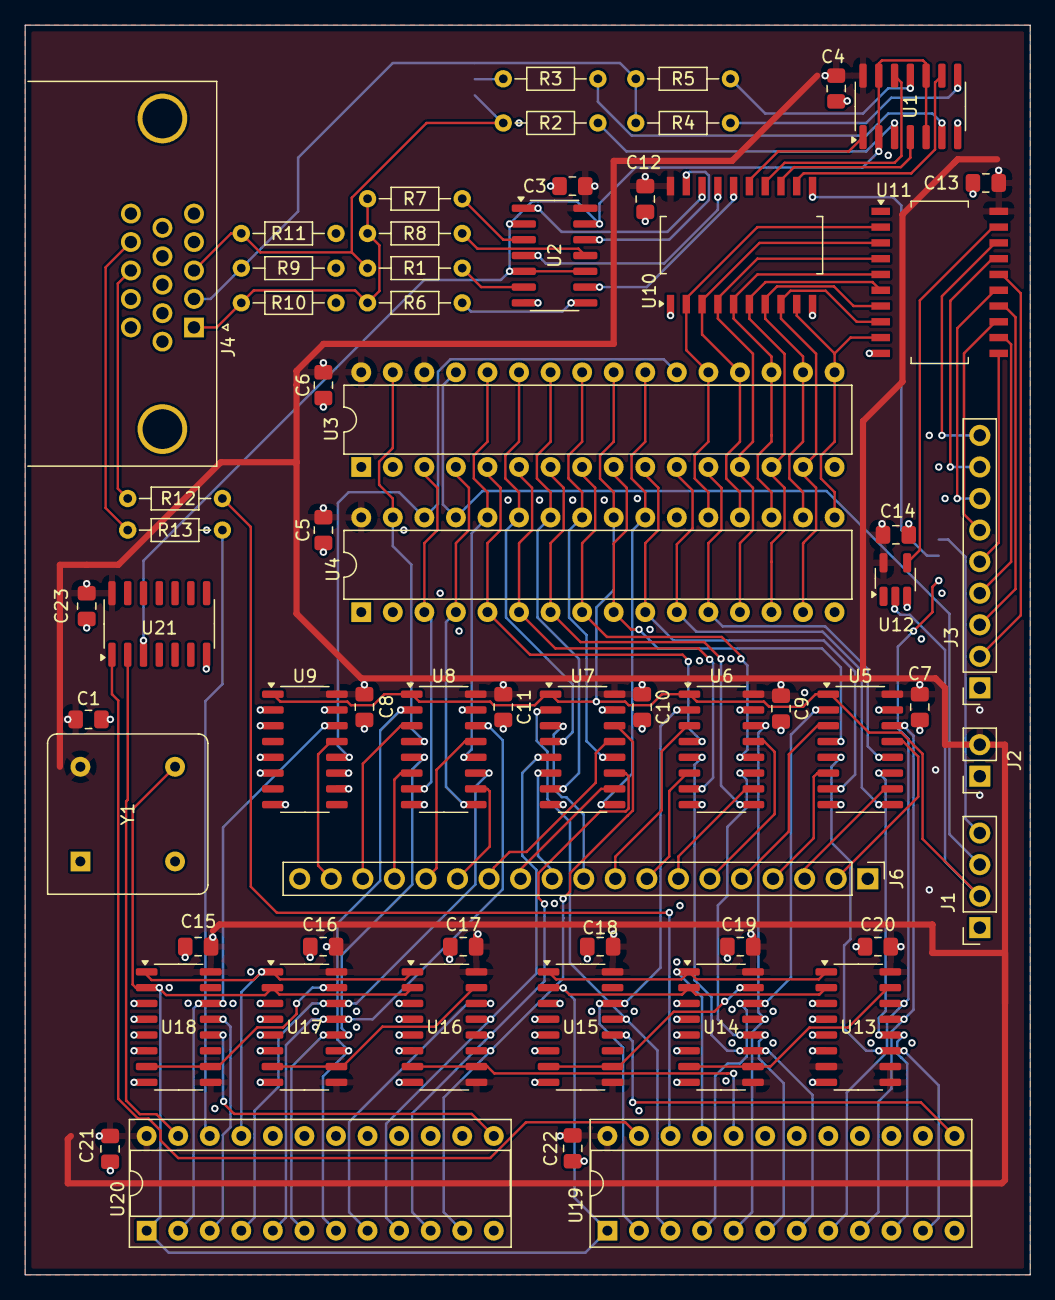
[picture p11: board vga_mem_output_01_4l.kicad_pcb from above]

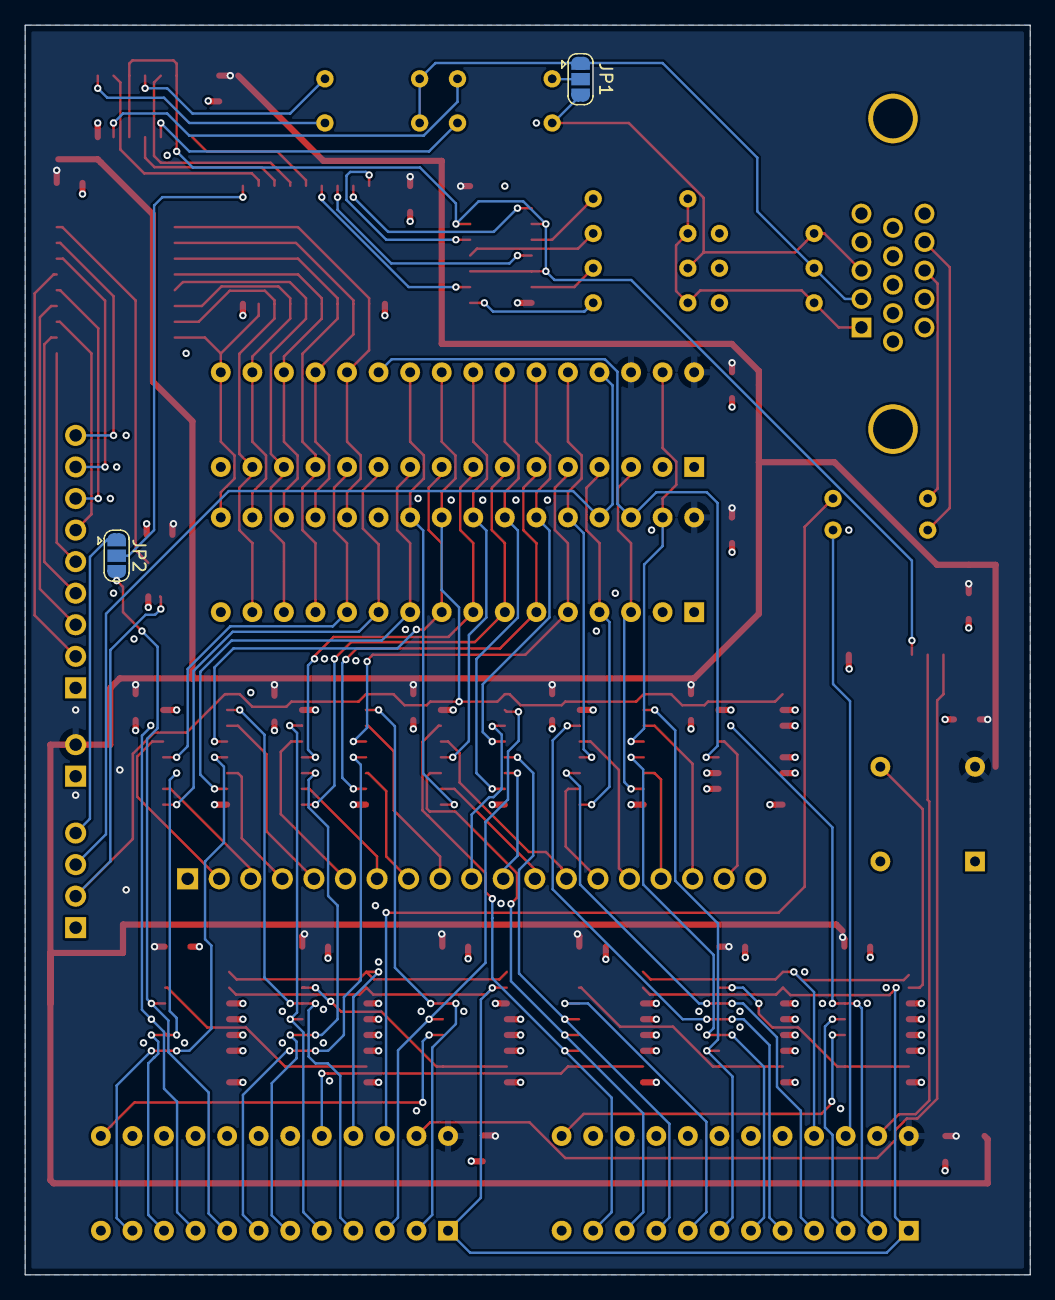
[picture p12: board vga_mem_output_01_4l.kicad_pcb from below]

Board: 4 copper layers, 80.9 x 100.6 mm, 64 parts (2 on the bottom side), 114 nets.
