sim82/6502_sbc/kicad/vga_mem_output_01/vga_mem_output_01.kicad_pcb

## KiCad design kicad/vga_mem_output_01/vga_mem_output_01.kicad_pcb (2025-09-02)

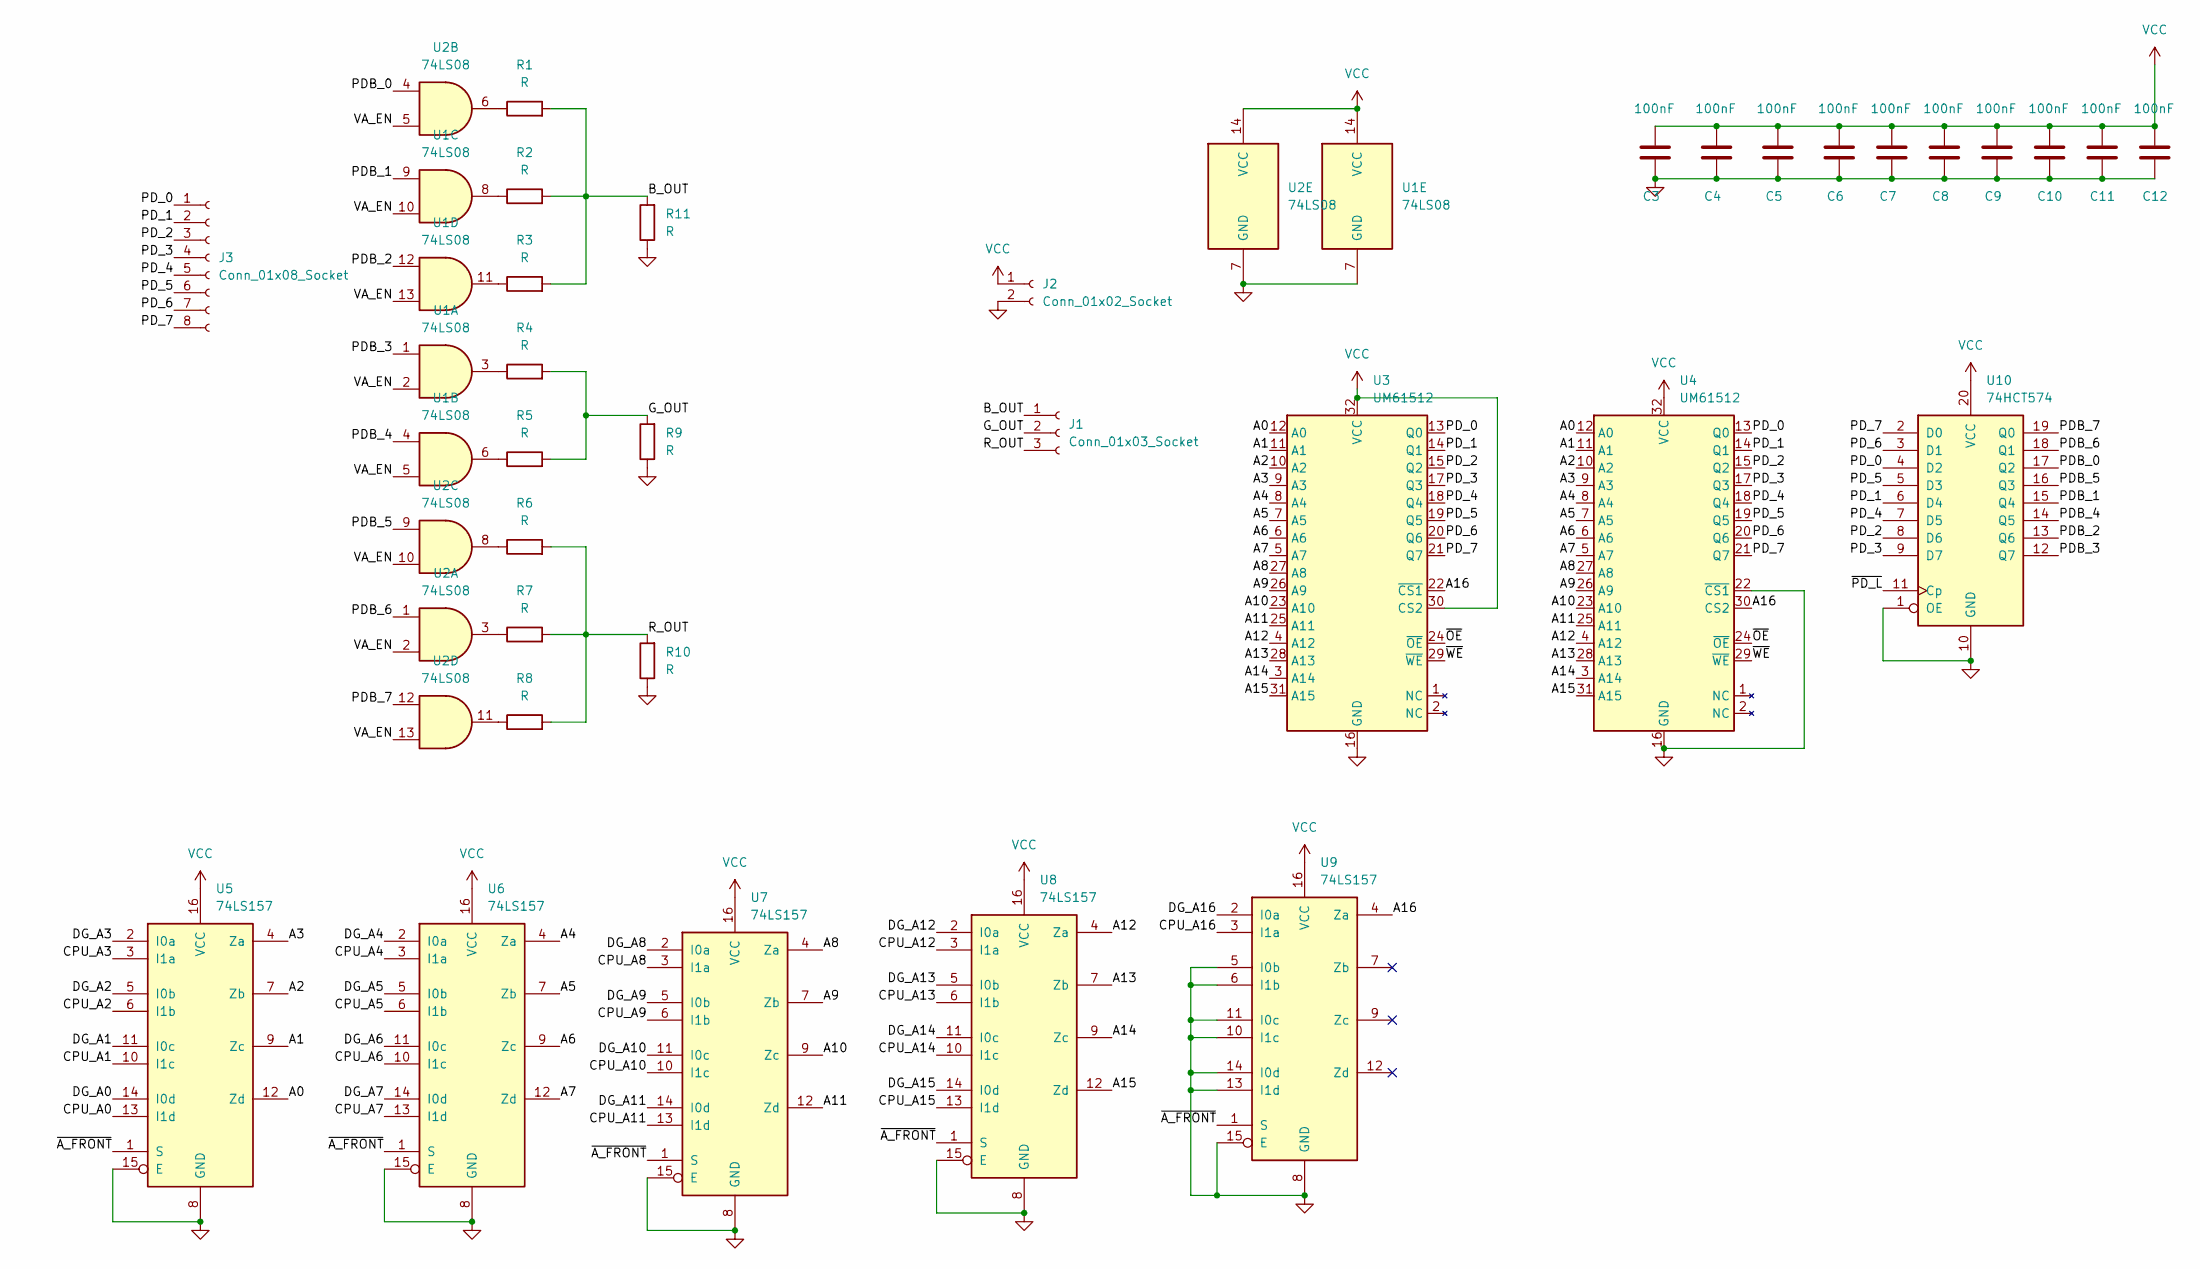
[picture p13: schematic vga_mem_output_01.kicad_sch]

Parts:
C3, C4, C5, C6, C7, C8, C9, C10, C11, C12: 100nF; C_0805_2012Metric_Pad1.18x1.45mm_HandSolder
J1: Conn_01x03_Socket; PinSocket_1x03_P2.54mm_Vertical
J2: Conn_01x02_Socket; PinSocket_1x02_P2.54mm_Vertical
J3: Conn_01x08_Socket; PinSocket_1x08_P2.54mm_Vertical
R1, R2, R3, R4, R5, R6, R7, R8, R9, R10, R11: R; R_Axial_DIN0204_L3.6mm_D1.6mm_P7.62mm_Horizontal
U1, U2: 74LS08; SO-14_3.9x8.65mm_P1.27mm
U3, U4: UM61512; DIP-32_W7.62mm
U5, U6, U7, U8, U9: 74LS157; SO-16_3.9x9.9mm_P1.27mm
U10: 74HCT574; SO-20_5.3x12.6mm_P1.27mm

Connections:
/A0: U3.12 (A0), U4.12 (A0), U5.12 (Zd)
/A1: U3.11 (A1), U4.11 (A1), U5.9 (Zc)
/A2: U3.10 (A2), U4.10 (A2), U5.7 (Zb)
/A3: U3.9 (A3), U4.9 (A3), U5.4 (Za)
/A4: U3.8 (A4), U4.8 (A4), U6.4 (Za)
/A5: U3.7 (A5), U4.7 (A5), U6.7 (Zb)
/A6: U3.6 (A6), U4.6 (A6), U6.9 (Zc)
/A7: U3.5 (A7), U4.5 (A7), U6.12 (Zd)
/A8: U3.27 (A8), U4.27 (A8), U7.4 (Za)
/A9: U3.26 (A9), U4.26 (A9), U7.7 (Zb)
/A10: U3.23 (A10), U4.23 (A10), U7.9 (Zc)
/A11: U3.25 (A11), U4.25 (A11), U7.12 (Zd)
/A12: U3.4 (A12), U4.4 (A12), U8.4 (Za)
/A13: U3.28 (A13), U4.28 (A13), U8.7 (Zb)
/A14: U3.3 (A14), U4.3 (A14), U8.9 (Zc)
/A15: U3.31 (A15), U4.31 (A15), U8.12 (Zd)
/A16: U3.22 (~CS1), U4.30 (CS2), U9.4 (Za)
/B_OUT: J1.1, R1.2, R2.2, R3.2, R11.2
/CPU_A0: U5.13 (I1d)
/CPU_A1: U5.10 (I1c)
/CPU_A2: U5.6 (I1b)
/CPU_A3: U5.3 (I1a)
/CPU_A4: U6.3 (I1a)
/CPU_A5: U6.6 (I1b)
/CPU_A6: U6.10 (I1c)
/CPU_A7: U6.13 (I1d)
/CPU_A8: U7.3 (I1a)
/CPU_A9: U7.6 (I1b)
/CPU_A10: U7.10 (I1c)
/CPU_A11: U7.13 (I1d)
/CPU_A12: U8.3 (I1a)
/CPU_A13: U8.6 (I1b)
/CPU_A14: U8.10 (I1c)
/CPU_A15: U8.13 (I1d)
/CPU_A16: U9.3 (I1a)
/DG_A0: U5.14 (I0d)
/DG_A1: U5.11 (I0c)
/DG_A2: U5.5 (I0b)
/DG_A3: U5.2 (I0a)
/DG_A4: U6.2 (I0a)
/DG_A5: U6.5 (I0b)
/DG_A6: U6.11 (I0c)
/DG_A7: U6.14 (I0d)
/DG_A8: U7.2 (I0a)
/DG_A9: U7.5 (I0b)
/DG_A10: U7.11 (I0c)
/DG_A11: U7.14 (I0d)
/DG_A12: U8.2 (I0a)
/DG_A13: U8.5 (I0b)
/DG_A14: U8.11 (I0c)
/DG_A15: U8.14 (I0d)
/DG_A16: U9.2 (I0a)
/G_OUT: J1.2, R4.2, R5.2, R9.2
/PDB_0: U2.4, U10.17 (Q2)
/PDB_1: U1.9, U10.15 (Q4)
/PDB_2: U1.12, U10.13 (Q6)
/PDB_3: U1.1, U10.12 (Q7)
/PDB_4: U1.4, U10.14 (Q5)
/PDB_5: U2.9, U10.16 (Q3)
/PDB_6: U2.1, U10.18 (Q1)
/PDB_7: U2.12, U10.19 (Q0)
/PD_0: J3.1, U3.13 (Q0), U4.13 (Q0), U10.4 (D2)
/PD_1: J3.2, U3.14 (Q1), U4.14 (Q1), U10.6 (D4)
/PD_2: J3.3, U3.15 (Q2), U4.15 (Q2), U10.8 (D6)
/PD_3: J3.4, U3.17 (Q3), U4.17 (Q3), U10.9 (D7)
/PD_4: J3.5, U3.18 (Q4), U4.18 (Q4), U10.7 (D5)
/PD_5: J3.6, U3.19 (Q5), U4.19 (Q5), U10.5 (D3)
/PD_6: J3.7, U3.20 (Q6), U4.20 (Q6), U10.3 (D1)
/PD_7: J3.8, U3.21 (Q7), U4.21 (Q7), U10.2 (D0)
/R_OUT: J1.3, R6.2, R7.2, R8.2, R10.2
/VA_EN: U1.2, U1.5, U1.10, U1.13, U2.2, U2.5, U2.10, U2.13
/~A_FRONT: U5.1 (S), U6.1 (S), U7.1 (S), U8.1 (S), U9.1 (S)
/~OE: U3.24 (~OE), U4.24 (~OE)
/~PD_L: U10.11 (Cp)
/~WE: U3.29 (~WE), U4.29 (~WE)
GND: C3.2, C4.2, C5.2, C6.2, C7.2, C8.2, C9.2, C10.2, C11.2, C12.2, J2.2, R9.1, R10.1, R11.1, U1.7 (GND), U2.7 (GND), U3.16 (GND), U4.16 (GND), U4.22 (~CS1), U5.8 (GND), U5.15 (E), U6.8 (GND), U6.15 (E), U7.8 (GND), U7.15 (E), U8.8 (GND), U8.15 (E), U9.5 (I0b), U9.6 (I1b), U9.8 (GND), U9.10 (I1c), U9.11 (I0c), U9.13 (I1d), U9.14 (I0d), U9.15 (E), U10.1 (OE), U10.10 (GND)
unnamed: R1.1, U2.6
unnamed: R2.1, U1.8
unnamed: R3.1, U1.11
unnamed: R4.1, U1.3
unnamed: R5.1, U1.6
unnamed: R6.1, U2.8
unnamed: R7.1, U2.3
unnamed: R8.1, U2.11
VCC: C3.1, C4.1, C5.1, C6.1, C7.1, C8.1, C9.1, C10.1, C11.1, C12.1, J2.1, U1.14 (VCC), U2.14 (VCC), U3.30 (CS2), U3.32 (VCC), U4.32 (VCC), U5.16 (VCC), U6.16 (VCC), U7.16 (VCC), U8.16 (VCC), U9.16 (VCC), U10.20 (VCC)

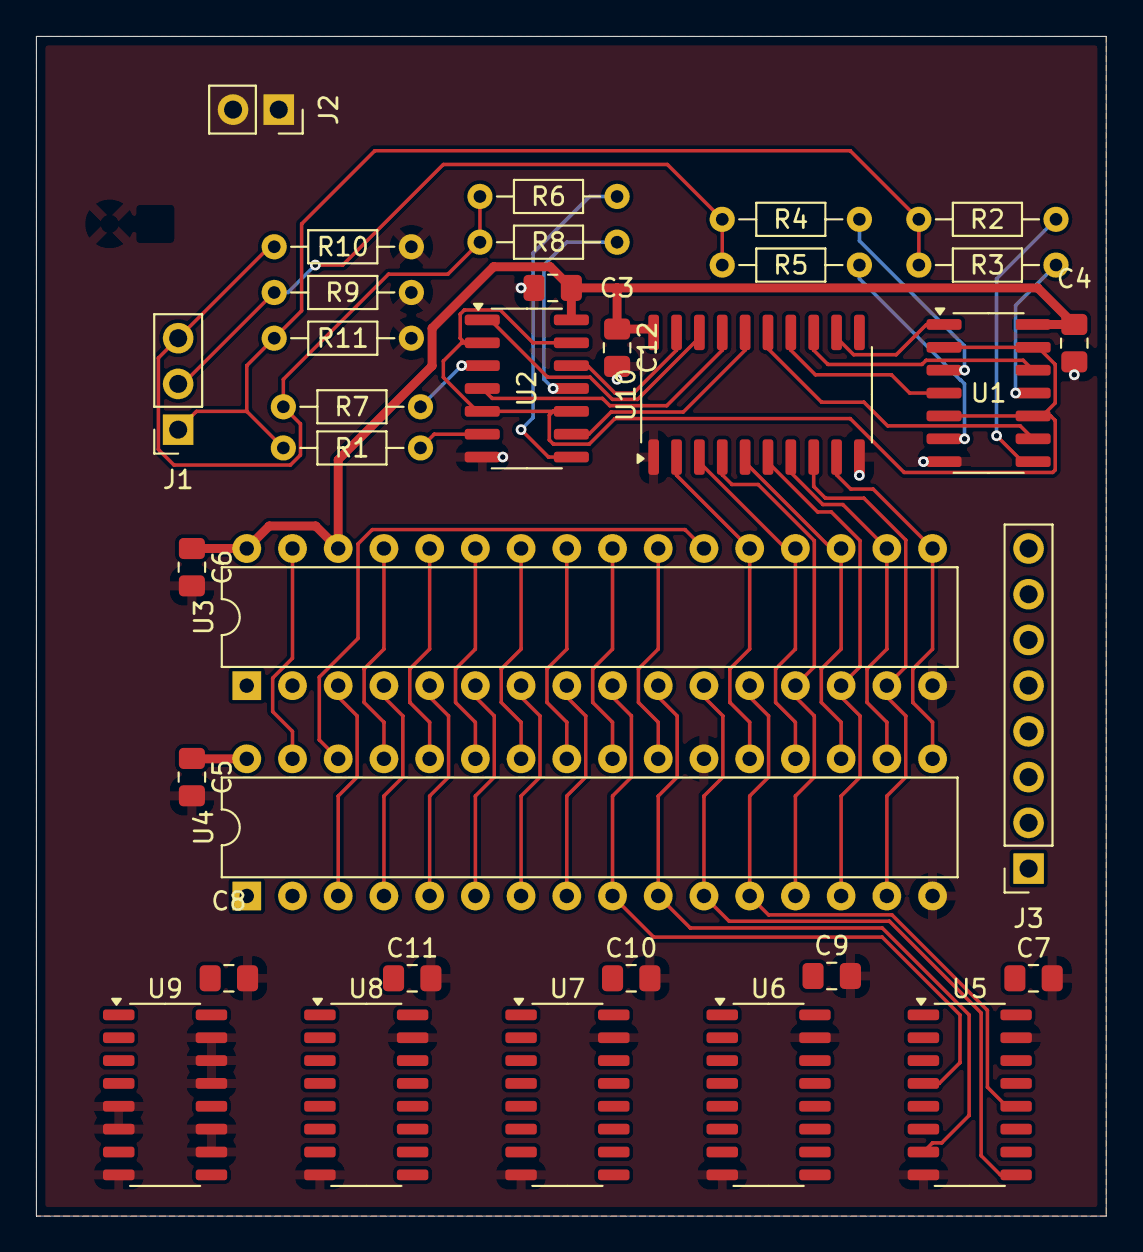
[picture p14: board vga_mem_output_01.kicad_pcb from above]

Board: 2 copper layers, 59.4 x 65.5 mm, 34 parts (0 on the bottom side), 50 nets.
