sim82/6502_sbc/kicad/vga_timing_01/vga_timing_01.kicad_pcb

## KiCad design kicad/vga_timing_01/vga_timing_01.kicad_pcb (2025-08-31)

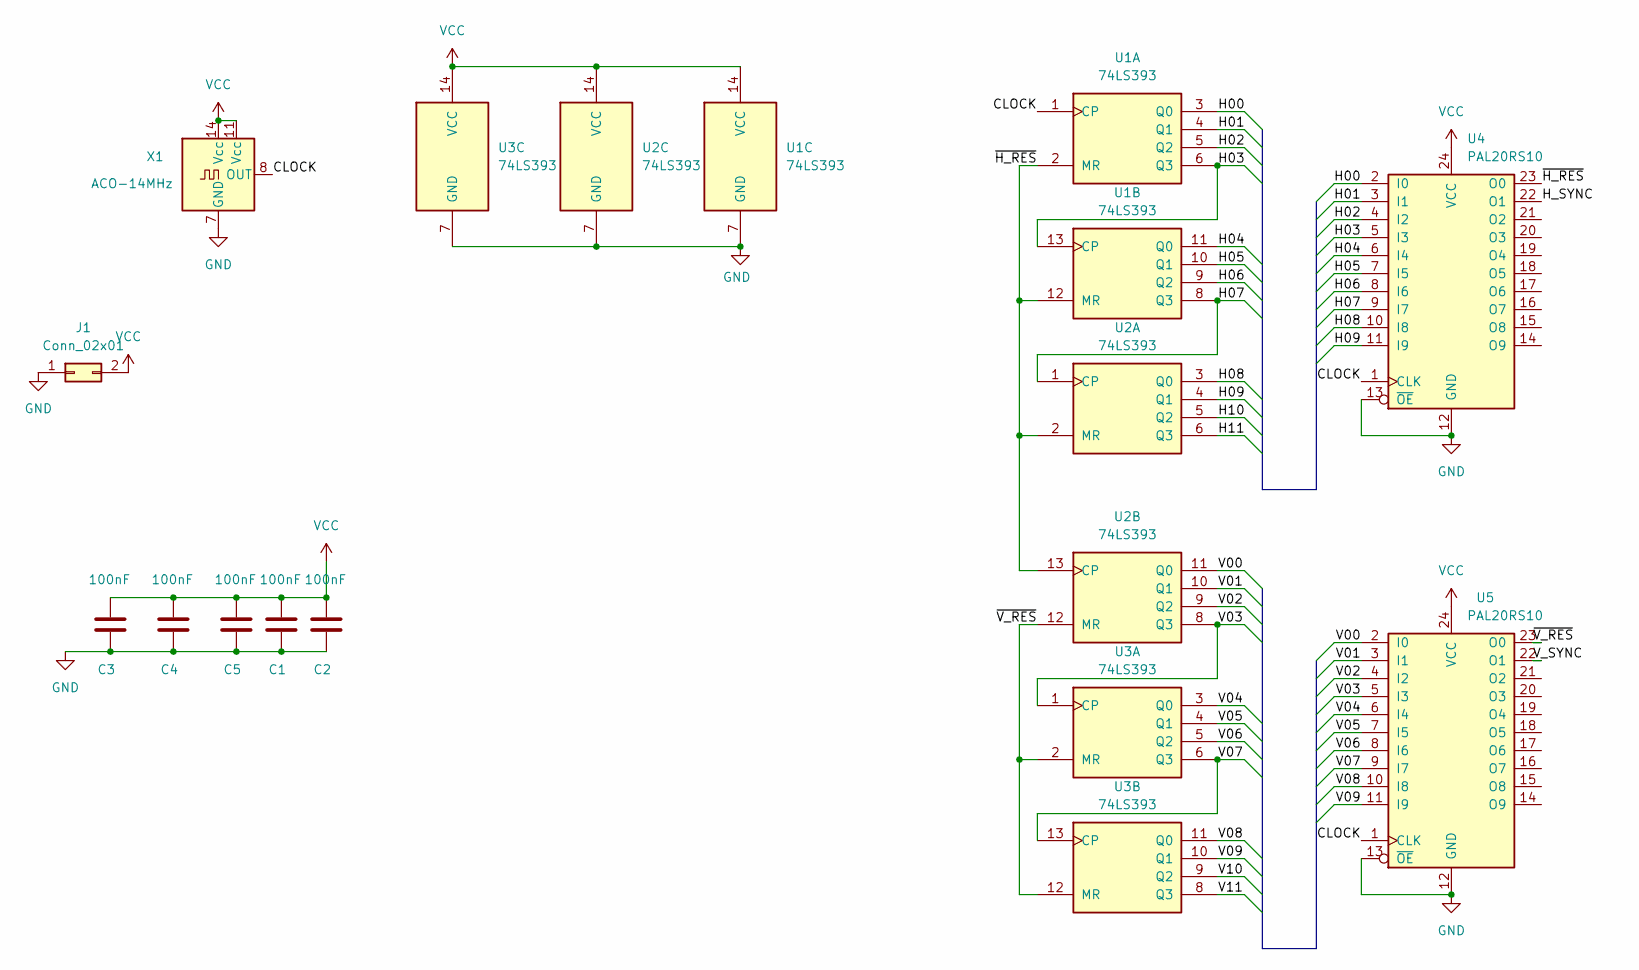
[picture p15: schematic vga_timing_01.kicad_sch]

Parts:
C1, C2, C3, C4, C5: 100nF; C_0805_2012Metric_Pad1.18x1.45mm_HandSolder
J1: Conn_02x01; PinSocket_2x01_P1.27mm_Vertical
U1, U2, U3: 74LS393; SO-14_3.9x8.65mm_P1.27mm
U4, U5: PAL20RS10; DIP-24_W7.62mm_Socket
X1: ACO-14MHz; DIP-14_W7.62mm_Socket

Connections:
/CLOCK: U1.1 (CP), U4.1 (CLK), U5.1 (CLK), X1.8 (OUT)
/H00: U1.3 (Q0), U4.2 (I0)
/H01: U1.4 (Q1), U4.3 (I1)
/H02: U1.5 (Q2), U4.4 (I2)
/H03: U1.6 (Q3), U1.13 (CP), U4.5 (I3)
/H04: U1.11 (Q0), U4.6 (I4)
/H05: U1.10 (Q1), U4.7 (I5)
/H06: U1.9 (Q2), U4.8 (I6)
/H07: U1.8 (Q3), U2.1 (CP), U4.9 (I7)
/H08: U2.3 (Q0), U4.10 (I8)
/H09: U2.4 (Q1), U4.11 (I9)
/H10: U2.5 (Q2)
/H11: U2.6 (Q3)
/H_SYNC: U4.22 (O1)
/V00: U2.11 (Q0), U5.2 (I0)
/V01: U2.10 (Q1), U5.3 (I1)
/V02: U2.9 (Q2), U5.4 (I2)
/V03: U2.8 (Q3), U3.1 (CP), U5.5 (I3)
/V04: U3.3 (Q0), U5.6 (I4)
/V05: U3.4 (Q1), U5.7 (I5)
/V06: U3.5 (Q2), U5.8 (I6)
/V07: U3.6 (Q3), U3.13 (CP), U5.9 (I7)
/V08: U3.11 (Q0), U5.10 (I8)
/V09: U3.10 (Q1), U5.11 (I9)
/V10: U3.9 (Q2)
/V11: U3.8 (Q3)
/V_SYNC: U5.22 (O1)
/~H_RES: U1.2 (MR), U1.12 (MR), U2.2 (MR), U2.13 (CP), U4.23 (O0)
/~V_RES: U2.12 (MR), U3.2 (MR), U3.12 (MR), U5.23 (O0)
GND: C1.2, C2.2, C3.2, C4.2, C5.2, J1.1, U1.7 (GND), U2.7 (GND), U3.7 (GND), U4.12 (GND), U4.13 (~OE), U5.12 (GND), U5.13 (~OE), X1.7 (GND)
VCC: C1.1, C2.1, C3.1, C4.1, C5.1, J1.2, U1.14 (VCC), U2.14 (VCC), U3.14 (VCC), U4.24 (VCC), U5.24 (VCC), X1.11 (Vcc), X1.14 (Vcc)
