sim82/6502_sbc/kicad/vga_timing_01/vga_timing_01.kicad_pcb

## KiCad design kicad/vga_timing_01/vga_timing_01.kicad_pcb (continued)

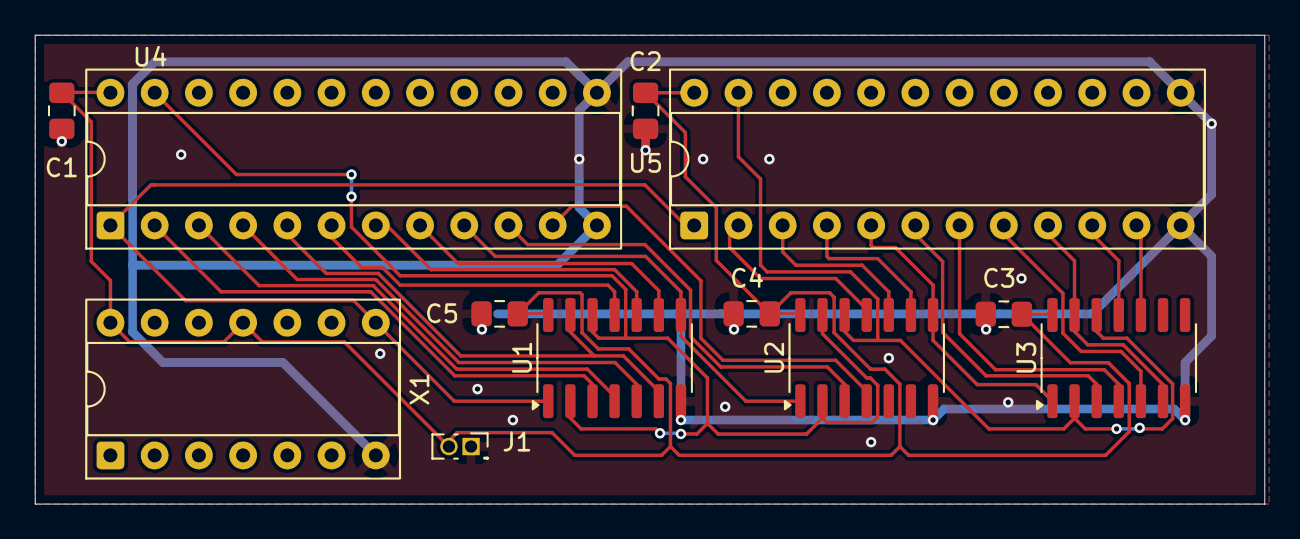
[picture p16: board vga_timing_01.kicad_pcb from above]

Board: 2 copper layers, 70.6 x 26.9 mm, 12 parts (0 on the bottom side), 25 nets.
