sim82/6502_sbc/kicad/min_uart_board_01/min_uart_board_01.kicad_pcb

## KiCad design kicad/min_uart_board_01/min_uart_board_01.kicad_pcb (2025-08-29)

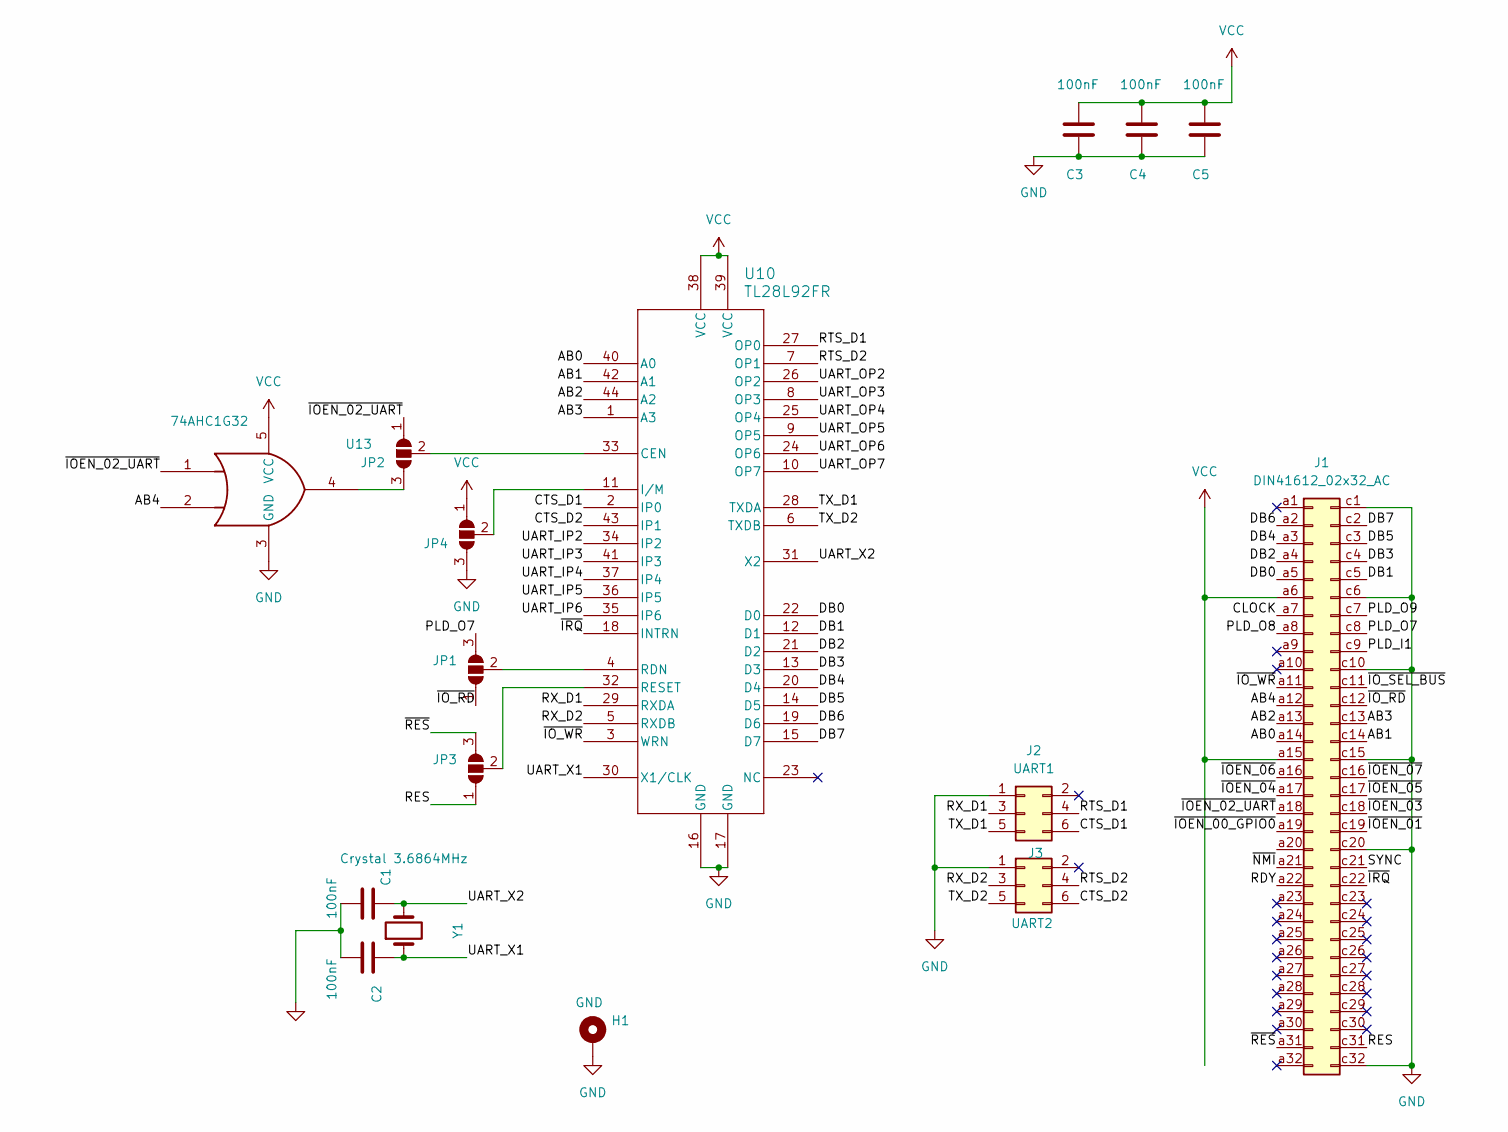
[picture p17: schematic min_uart_board_01.kicad_sch]

Parts:
C1, C2: 100nF; C_Disc_D4.7mm_W2.5mm_P5.00mm
C3, C4, C5: 100nF; C_0805_2012Metric_Pad1.18x1.45mm_HandSolder
H1: GND; MountingHole_3.2mm_M3_DIN965_Pad
J1: DIN41612_02x32_AC; DIN41612_C_2x32_Male_Horizontal_THT
J2: UART1; PinHeader_2x03_P2.54mm_Horizontal
J3: UART2; PinHeader_2x03_P2.54mm_Horizontal
JP1, JP2, JP3, JP4: SolderJumper_3_Open; SolderJumper-3_P1.3mm_Open_RoundedPad1.0x1.5mm
U10: TL28L92FR; MQFP-44_10x10mm_P0.8mm
U13: 74AHC1G32; SOT-23-5_HandSoldering
Y1: Crystal 3.6864MHz; Crystal_HC49-4H_Vertical

Connections:
/AB0: J1.a14, U10.40 (A0)
/AB1: J1.c14, U10.42 (A1)
/AB2: J1.a13, U10.44 (A2)
/AB3: J1.c13, U10.1 (A3)
/AB4: J1.a12, U13.2
/CLOCK: J1.a7
/CTS_D1: J2.6, U10.2 (IP0)
/CTS_D2: J3.6, U10.43 (IP1)
/DB0: J1.a5, U10.22 (D0)
/DB1: J1.c5, U10.12 (D1)
/DB2: J1.a4, U10.21 (D2)
/DB3: J1.c4, U10.13 (D3)
/DB4: J1.a3, U10.20 (D4)
/DB5: J1.c3, U10.14 (D5)
/DB6: J1.a2, U10.19 (D6)
/DB7: J1.c2, U10.15 (D7)
/PLD_I1: J1.c9
/PLD_O7: J1.c8, JP1.3 (B)
/PLD_O8: J1.a8
/PLD_O9: J1.c7
/RDY: J1.a22
/RES: J1.c31, JP3.1 (A)
/RTS_D1: J2.4, U10.27 (OP0)
/RTS_D2: J3.4, U10.7 (OP1)
/RX_D1: J2.3, U10.29 (RXDA)
/RX_D2: J3.3, U10.5 (RXDB)
/SYNC: J1.c21
/TX_D1: J2.5, U10.28 (TXDA)
/TX_D2: J3.5, U10.6 (TXDB)
/UART_IP2: U10.34 (IP2)
/UART_IP3: U10.41 (IP3)
/UART_IP4: U10.37 (IP4)
/UART_IP5: U10.36 (IP5)
/UART_IP6: U10.35 (IP6)
/UART_OP2: U10.26 (OP2)
/UART_OP3: U10.8 (OP3)
/UART_OP4: U10.25 (OP4)
/UART_OP5: U10.9 (OP5)
/UART_OP6: U10.24 (OP6)
/UART_OP7: U10.10 (OP7)
/UART_X1: C2.1, U10.30 (X1/CLK), Y1.1
/UART_X2: C1.1, U10.31 (X2), Y1.2
/~IOEN_00_GPIO0: J1.a19
/~IOEN_01: J1.c19
/~IOEN_02_UART: J1.a18, JP2.1 (A), U13.1
/~IOEN_03: J1.c18
/~IOEN_04: J1.a17
/~IOEN_05: J1.c17
/~IOEN_06: J1.a16
/~IOEN_07: J1.c16
/~IO_RD: J1.c12, JP1.1 (A)
/~IO_SEL_BUS: J1.c11
/~IO_WR: J1.a11, U10.3 (WRN)
/~IRQ: J1.c22, U10.18 (INTRN)
/~NMI: J1.a21
/~RES: J1.a31, JP3.3 (B)
GND: C1.2, C2.2, C3.2, C4.2, C5.2, H1.1, J1.c1, J1.c6, J1.c10, J1.c15, J1.c20, J1.c32, J2.1, J3.1, JP4.3 (B), U10.16 (GND), U10.17 (GND), U13.3 (GND)
unnamed: JP1.2 (C), U10.4 (RDN)
unnamed: JP2.3 (B), U13.4
unnamed: JP2.2 (C), U10.33 (CEN)
unnamed: JP3.2 (C), U10.32 (RESET)
unnamed: JP4.2 (C), U10.11 (I/M)
VCC: C3.1, C4.1, C5.1, J1.a6, J1.a15, JP4.1 (A), U10.38 (VCC), U10.39 (VCC), U13.5 (VCC)

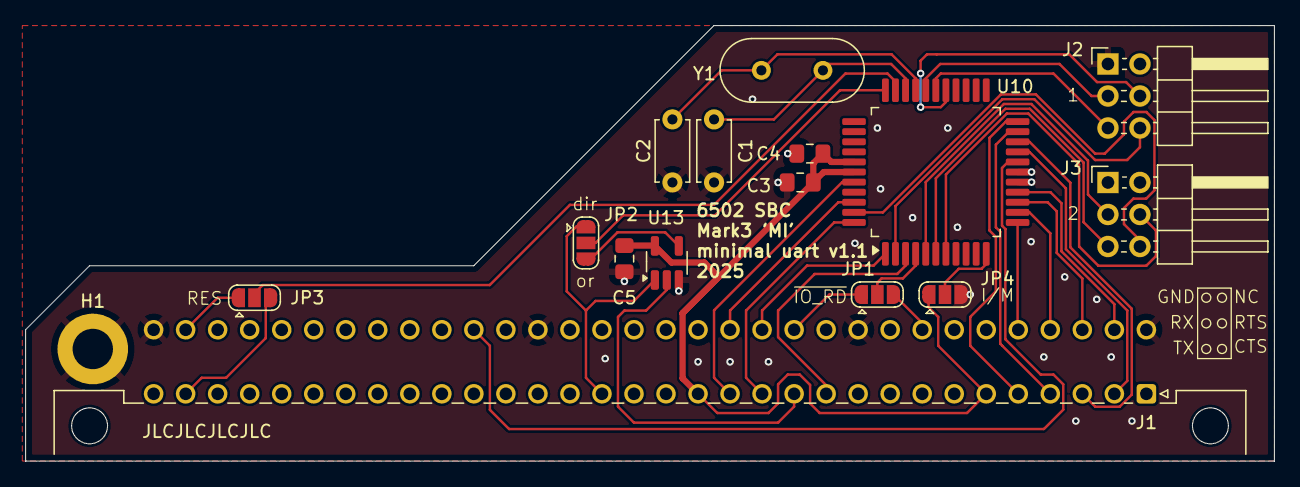
[picture p18: board min_uart_board_01.kicad_pcb from above]

Board: 2 copper layers, 99.1 x 34.5 mm, 16 parts (0 on the bottom side), 37 nets.
