sim82/6502_sbc/kicad/com_board_01/com_board_01.kicad_pcb

## KiCad design kicad/com_board_01/com_board_01.kicad_pcb (2025-08-28)

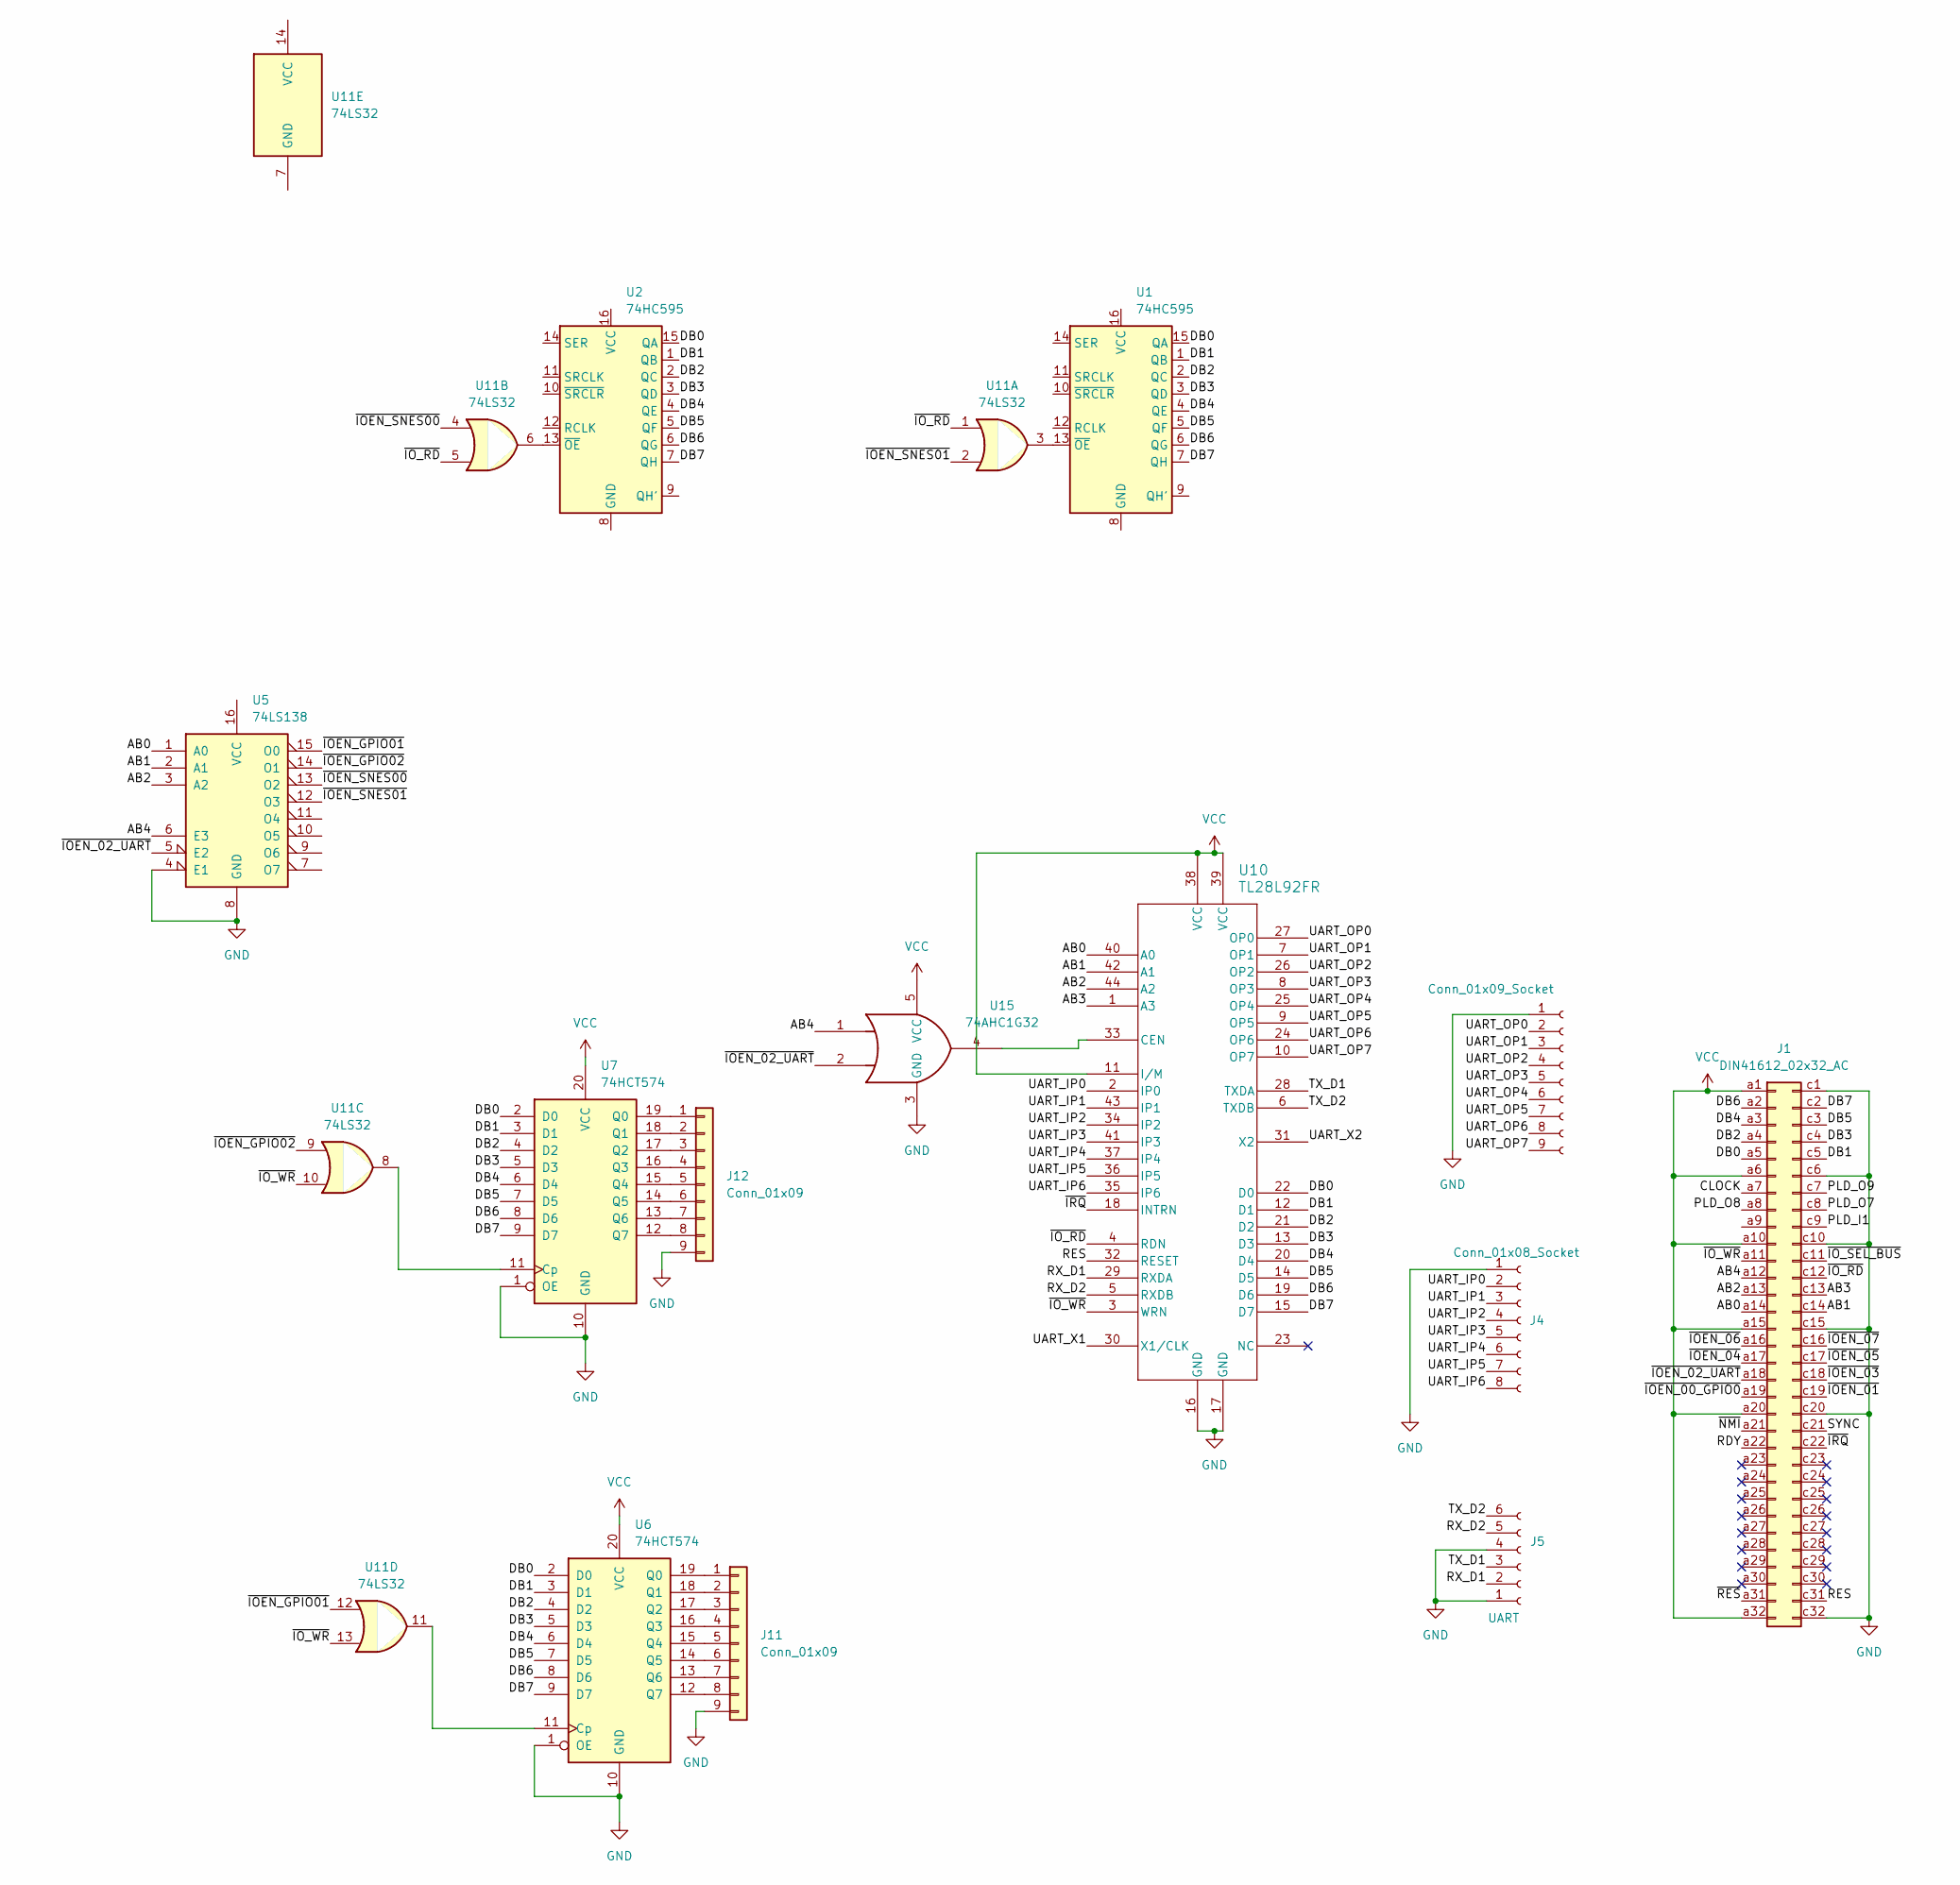
[picture p19: schematic com_board_01.kicad_sch]

Parts:
J1: DIN41612_02x32_AC; DIN41612_C_2x32_Male_Horizontal_THT
J3: Conn_01x09_Socket; PinSocket_1x09_P2.54mm_Vertical
J4: Conn_01x08_Socket; PinSocket_1x08_P2.54mm_Vertical
J5: UART; PinSocket_1x06_P2.54mm_Vertical
J11, J12: Conn_01x09; PinSocket_1x09_P2.54mm_Vertical
U1, U2: 74HC595; SOIC-16_3.9x9.9mm_P1.27mm
U5: 74LS138; SO-16_3.9x9.9mm_P1.27mm
U6, U7: 74HCT574; SO-20_12.8x7.5mm_P1.27mm
U10: TL28L92FR; MQFP-44_10x10mm_P0.8mm
U11: 74LS32; SO-14_3.9x8.65mm_P1.27mm
U15: 74AHC1G32; SOT-23-5_HandSoldering

Connections:
/AB0: J1.a14, U5.1 (A0), U10.40 (A0)
/AB1: J1.c14, U5.2 (A1), U10.42 (A1)
/AB2: J1.a13, U5.3 (A2), U10.44 (A2)
/AB3: J1.c13, U10.1 (A3)
/AB4: J1.a12, U5.6 (E3), U15.1
/CLOCK: J1.a7
/DB0: J1.a5, U1.15 (QA), U2.15 (QA), U6.2 (D0), U7.2 (D0), U10.22 (D0)
/DB1: J1.c5, U1.1 (QB), U2.1 (QB), U6.3 (D1), U7.3 (D1), U10.12 (D1)
/DB2: J1.a4, U1.2 (QC), U2.2 (QC), U6.4 (D2), U7.4 (D2), U10.21 (D2)
/DB3: J1.c4, U1.3 (QD), U2.3 (QD), U6.5 (D3), U7.5 (D3), U10.13 (D3)
/DB4: J1.a3, U1.4 (QE), U2.4 (QE), U6.6 (D4), U7.6 (D4), U10.20 (D4)
/DB5: J1.c3, U1.5 (QF), U2.5 (QF), U6.7 (D5), U7.7 (D5), U10.14 (D5)
/DB6: J1.a2, U1.6 (QG), U2.6 (QG), U6.8 (D6), U7.8 (D6), U10.19 (D6)
/DB7: J1.c2, U1.7 (QH), U2.7 (QH), U6.9 (D7), U7.9 (D7), U10.15 (D7)
/PLD_I1: J1.c9
/PLD_O7: J1.c8
/PLD_O8: J1.a8
/PLD_O9: J1.c7
/RDY: J1.a22
/RES: J1.c31, U10.32 (RESET)
/RX_D1: J5.2, U10.29 (RXDA)
/RX_D2: J5.5, U10.5 (RXDB)
/SYNC: J1.c21
/TX_D1: J5.3, U10.28 (TXDA)
/TX_D2: J5.6, U10.6 (TXDB)
/UART_IP0: J4.2, U10.2 (IP0)
/UART_IP1: J4.3, U10.43 (IP1)
/UART_IP2: J4.4, U10.34 (IP2)
/UART_IP3: J4.5, U10.41 (IP3)
/UART_IP4: J4.6, U10.37 (IP4)
/UART_IP5: J4.7, U10.36 (IP5)
/UART_IP6: J4.8, U10.35 (IP6)
/UART_OP0: J3.2, U10.27 (OP0)
/UART_OP1: J3.3, U10.7 (OP1)
/UART_OP2: J3.4, U10.26 (OP2)
/UART_OP3: J3.5, U10.8 (OP3)
/UART_OP4: J3.6, U10.25 (OP4)
/UART_OP5: J3.7, U10.9 (OP5)
/UART_OP6: J3.8, U10.24 (OP6)
/UART_OP7: J3.9, U10.10 (OP7)
/UART_X1: U10.30 (X1/CLK)
/UART_X2: U10.31 (X2)
/~IOEN_00_GPIO0: J1.a19
/~IOEN_01: J1.c19
/~IOEN_02_UART: J1.a18, U5.5 (E2), U15.2
/~IOEN_03: J1.c18
/~IOEN_04: J1.a17
/~IOEN_05: J1.c17
/~IOEN_06: J1.a16
/~IOEN_07: J1.c16
/~IOEN_GPIO01: U5.15 (O0), U11.12
/~IOEN_GPIO02: U5.14 (O1), U11.9
/~IOEN_SNES00: U5.13 (O2), U11.4
/~IOEN_SNES01: U5.12 (O3), U11.2
/~IO_RD: J1.c12, U10.4 (RDN), U11.1, U11.5
/~IO_SEL_BUS: J1.c11
/~IO_WR: J1.a11, U10.3 (WRN), U11.10, U11.13
/~IRQ: J1.c22, U10.18 (INTRN)
/~NMI: J1.a21
/~RES: J1.a31
GND: J1.c1, J1.c6, J1.c10, J1.c15, J1.c20, J1.c32, J3.1, J4.1, J5.1, J5.4, J11.9, J12.9, U5.4 (E1), U5.8 (GND), U6.1 (OE), U6.10 (GND), U7.1 (OE), U7.10 (GND), U10.16 (GND), U10.17 (GND), U15.3 (GND)
unnamed: J11.1, U6.19 (Q0)
unnamed: J11.2, U6.18 (Q1)
unnamed: J11.3, U6.17 (Q2)
unnamed: J11.4, U6.16 (Q3)
unnamed: J11.5, U6.15 (Q4)
unnamed: J11.6, U6.14 (Q5)
unnamed: J11.7, U6.13 (Q6)
unnamed: J11.8, U6.12 (Q7)
unnamed: J12.1, U7.19 (Q0)
unnamed: J12.2, U7.18 (Q1)
unnamed: J12.3, U7.17 (Q2)
unnamed: J12.4, U7.16 (Q3)
unnamed: J12.5, U7.15 (Q4)
unnamed: J12.6, U7.14 (Q5)
unnamed: J12.7, U7.13 (Q6)
unnamed: J12.8, U7.12 (Q7)
unnamed: U1.13 (~OE), U11.3
unnamed: U2.13 (~OE), U11.6
unnamed: U6.11 (Cp), U11.11
unnamed: U7.11 (Cp), U11.8
unnamed: U10.33 (CEN), U15.4
VCC: J1.a1, J1.a6, J1.a10, J1.a15, J1.a20, J1.a32, U6.20 (VCC), U7.20 (VCC), U10.11 (I/M), U10.38 (VCC), U10.39 (VCC), U15.5 (VCC)

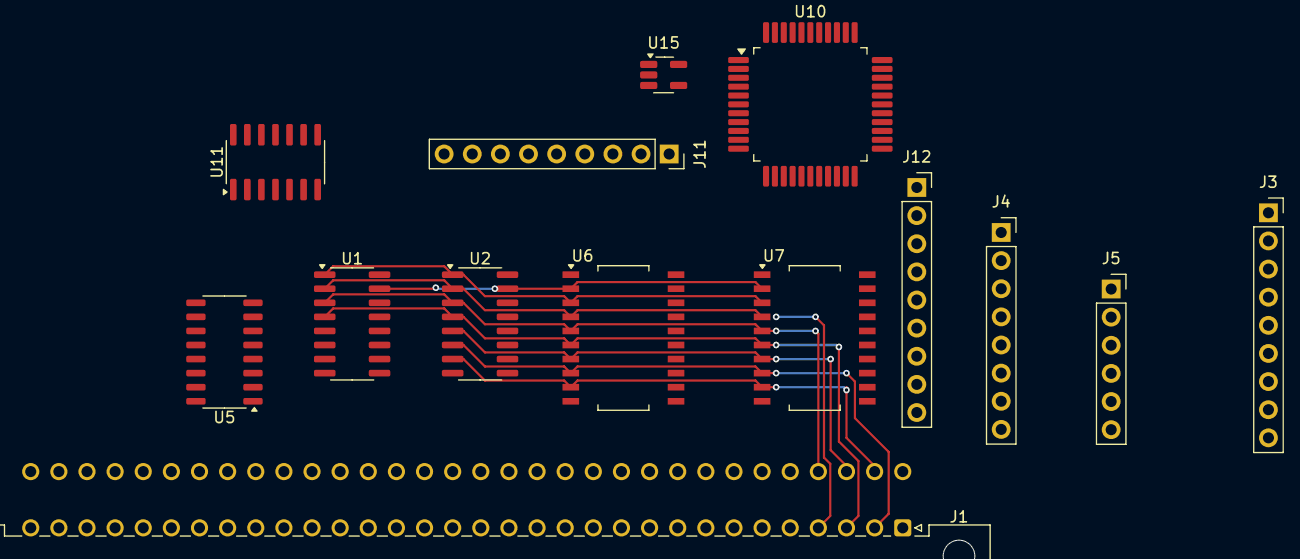
[picture p20: board com_board_01.kicad_pcb from above]

Board: 2 copper layers, 14 parts (0 on the bottom side), 64 nets.
