sim82/6502_sbc/kicad/backplane/backplane.kicad_pcb

## KiCad design kicad/backplane/backplane.kicad_pcb (2025-08-02)

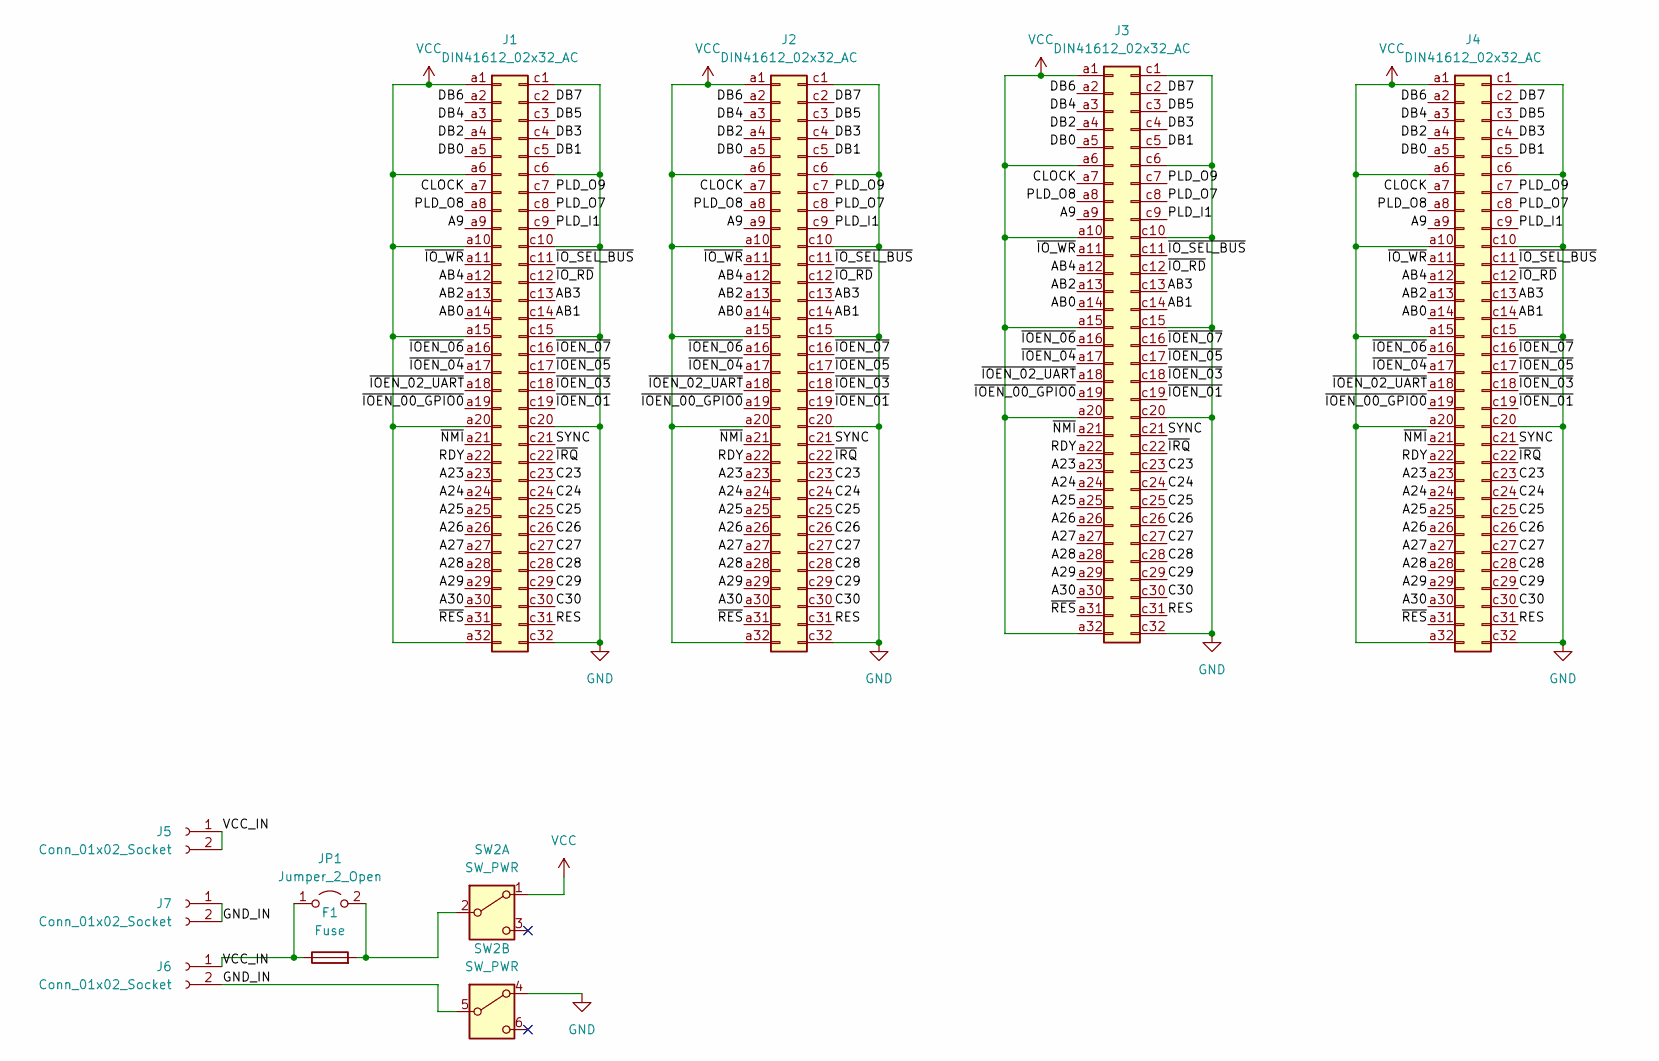
[picture p21: schematic backplane.kicad_sch]

Parts:
F1: Fuse; Fuseholder_Cylinder-5x20mm_Stelvio-Kontek_PTF78_Horizontal_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
J1, J2, J3, J4: DIN41612_02x32_AC; DIN41612_C_2x32_Female_Vertical_THT
J5, J6, J7: Conn_01x02_Socket; PinSocket_1x02_P2.54mm_Vertical
JP1: Jumper_2_Open; TestPoint_2Pads_Pitch2.54mm_Drill0.8mm
SW2: SW_PWR; 7x7DPDT

Connections:
/A9: J1.a9, J2.a9, J3.a9, J4.a9
/A23: J1.a23, J2.a23, J3.a23, J4.a23
/A24: J1.a24, J2.a24, J3.a24, J4.a24
/A25: J1.a25, J2.a25, J3.a25, J4.a25
/A26: J1.a26, J2.a26, J3.a26, J4.a26
/A27: J1.a27, J2.a27, J3.a27, J4.a27
/A28: J1.a28, J2.a28, J3.a28, J4.a28
/A29: J1.a29, J2.a29, J3.a29, J4.a29
/A30: J1.a30, J2.a30, J3.a30, J4.a30
/AB0: J1.a14, J2.a14, J3.a14, J4.a14
/AB1: J1.c14, J2.c14, J3.c14, J4.c14
/AB2: J1.a13, J2.a13, J3.a13, J4.a13
/AB3: J1.c13, J2.c13, J3.c13, J4.c13
/AB4: J1.a12, J2.a12, J3.a12, J4.a12
/C23: J1.c23, J2.c23, J3.c23, J4.c23
/C24: J1.c24, J2.c24, J3.c24, J4.c24
/C25: J1.c25, J2.c25, J3.c25, J4.c25
/C26: J1.c26, J2.c26, J3.c26, J4.c26
/C27: J1.c27, J2.c27, J3.c27, J4.c27
/C28: J1.c28, J2.c28, J3.c28, J4.c28
/C29: J1.c29, J2.c29, J3.c29, J4.c29
/C30: J1.c30, J2.c30, J3.c30, J4.c30
/CLOCK: J1.a7, J2.a7, J3.a7, J4.a7
/DB0: J1.a5, J2.a5, J3.a5, J4.a5
/DB1: J1.c5, J2.c5, J3.c5, J4.c5
/DB2: J1.a4, J2.a4, J3.a4, J4.a4
/DB3: J1.c4, J2.c4, J3.c4, J4.c4
/DB4: J1.a3, J2.a3, J3.a3, J4.a3
/DB5: J1.c3, J2.c3, J3.c3, J4.c3
/DB6: J1.a2, J2.a2, J3.a2, J4.a2
/DB7: J1.c2, J2.c2, J3.c2, J4.c2
/GND_IN: J6.2, J7.1, J7.2, SW2.5 (B)
/PLD_I1: J1.c9, J2.c9, J3.c9, J4.c9
/PLD_O7: J1.c8, J2.c8, J3.c8, J4.c8
/PLD_O8: J1.a8, J2.a8, J3.a8, J4.a8
/PLD_O9: J1.c7, J2.c7, J3.c7, J4.c7
/RDY: J1.a22, J2.a22, J3.a22, J4.a22
/RES: J1.c31, J2.c31, J3.c31, J4.c31
/SYNC: J1.c21, J2.c21, J3.c21, J4.c21
/VCC_IN: F1.1, J5.1, J5.2, J6.1, JP1.1 (A)
/~IOEN_00_GPIO0: J1.a19, J2.a19, J3.a19, J4.a19
/~IOEN_01: J1.c19, J2.c19, J3.c19, J4.c19
/~IOEN_02_UART: J1.a18, J2.a18, J3.a18, J4.a18
/~IOEN_03: J1.c18, J2.c18, J3.c18, J4.c18
/~IOEN_04: J1.a17, J2.a17, J3.a17, J4.a17
/~IOEN_05: J1.c17, J2.c17, J3.c17, J4.c17
/~IOEN_06: J1.a16, J2.a16, J3.a16, J4.a16
/~IOEN_07: J1.c16, J2.c16, J3.c16, J4.c16
/~IO_RD: J1.c12, J2.c12, J3.c12, J4.c12
/~IO_SEL_BUS: J1.c11, J2.c11, J3.c11, J4.c11
/~IO_WR: J1.a11, J2.a11, J3.a11, J4.a11
/~IRQ: J1.c22, J2.c22, J3.c22, J4.c22
/~NMI: J1.a21, J2.a21, J3.a21, J4.a21
/~RES: J1.a31, J2.a31, J3.a31, J4.a31
GND: J1.c1, J1.c6, J1.c10, J1.c15, J1.c20, J1.c32, J2.c1, J2.c6, J2.c10, J2.c15, J2.c20, J2.c32, J3.c1, J3.c6, J3.c10, J3.c15, J3.c20, J3.c32, J4.c1, J4.c6, J4.c10, J4.c15, J4.c20, J4.c32, SW2.4 (A)
unnamed: F1.2, JP1.2 (B), SW2.2 (B)
VCC: J1.a1, J1.a6, J1.a10, J1.a15, J1.a20, J1.a32, J2.a1, J2.a6, J2.a10, J2.a15, J2.a20, J2.a32, J3.a1, J3.a6, J3.a10, J3.a15, J3.a20, J3.a32, J4.a1, J4.a6, J4.a10, J4.a15, J4.a20, J4.a32, SW2.1 (A)

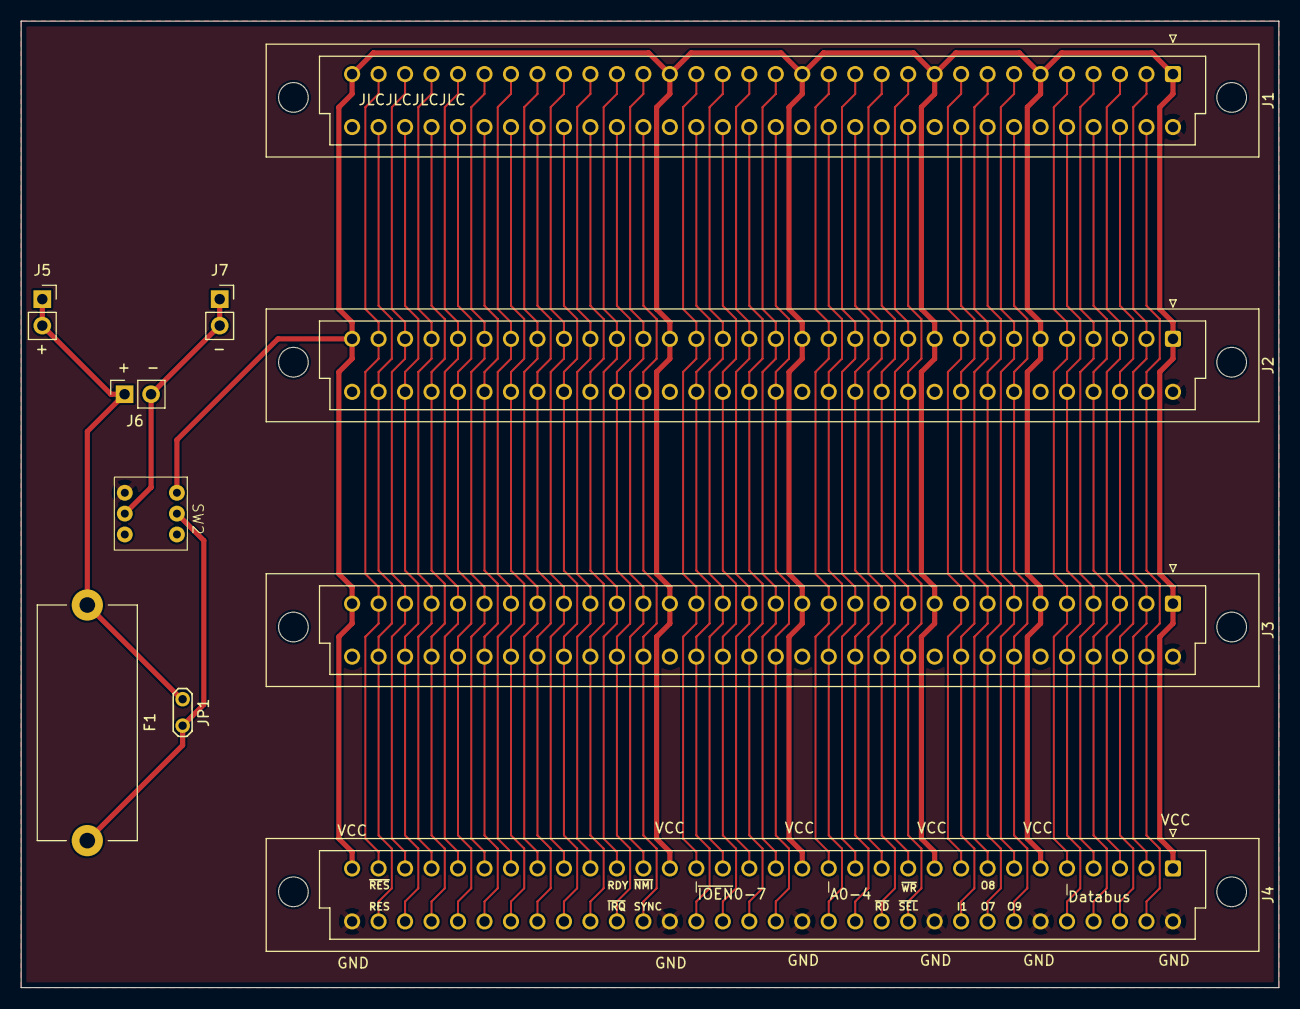
[picture p22: board backplane.kicad_pcb from above]

Board: 2 copper layers, 120.6 x 92.7 mm, 10 parts (0 on the bottom side), 57 nets.
