sim82/6502_sbc/kicad/cpu_board_02/cpu_board_02.kicad_pcb

## KiCad design kicad/cpu_board_02/cpu_board_02.kicad_pcb (2025-05-01)

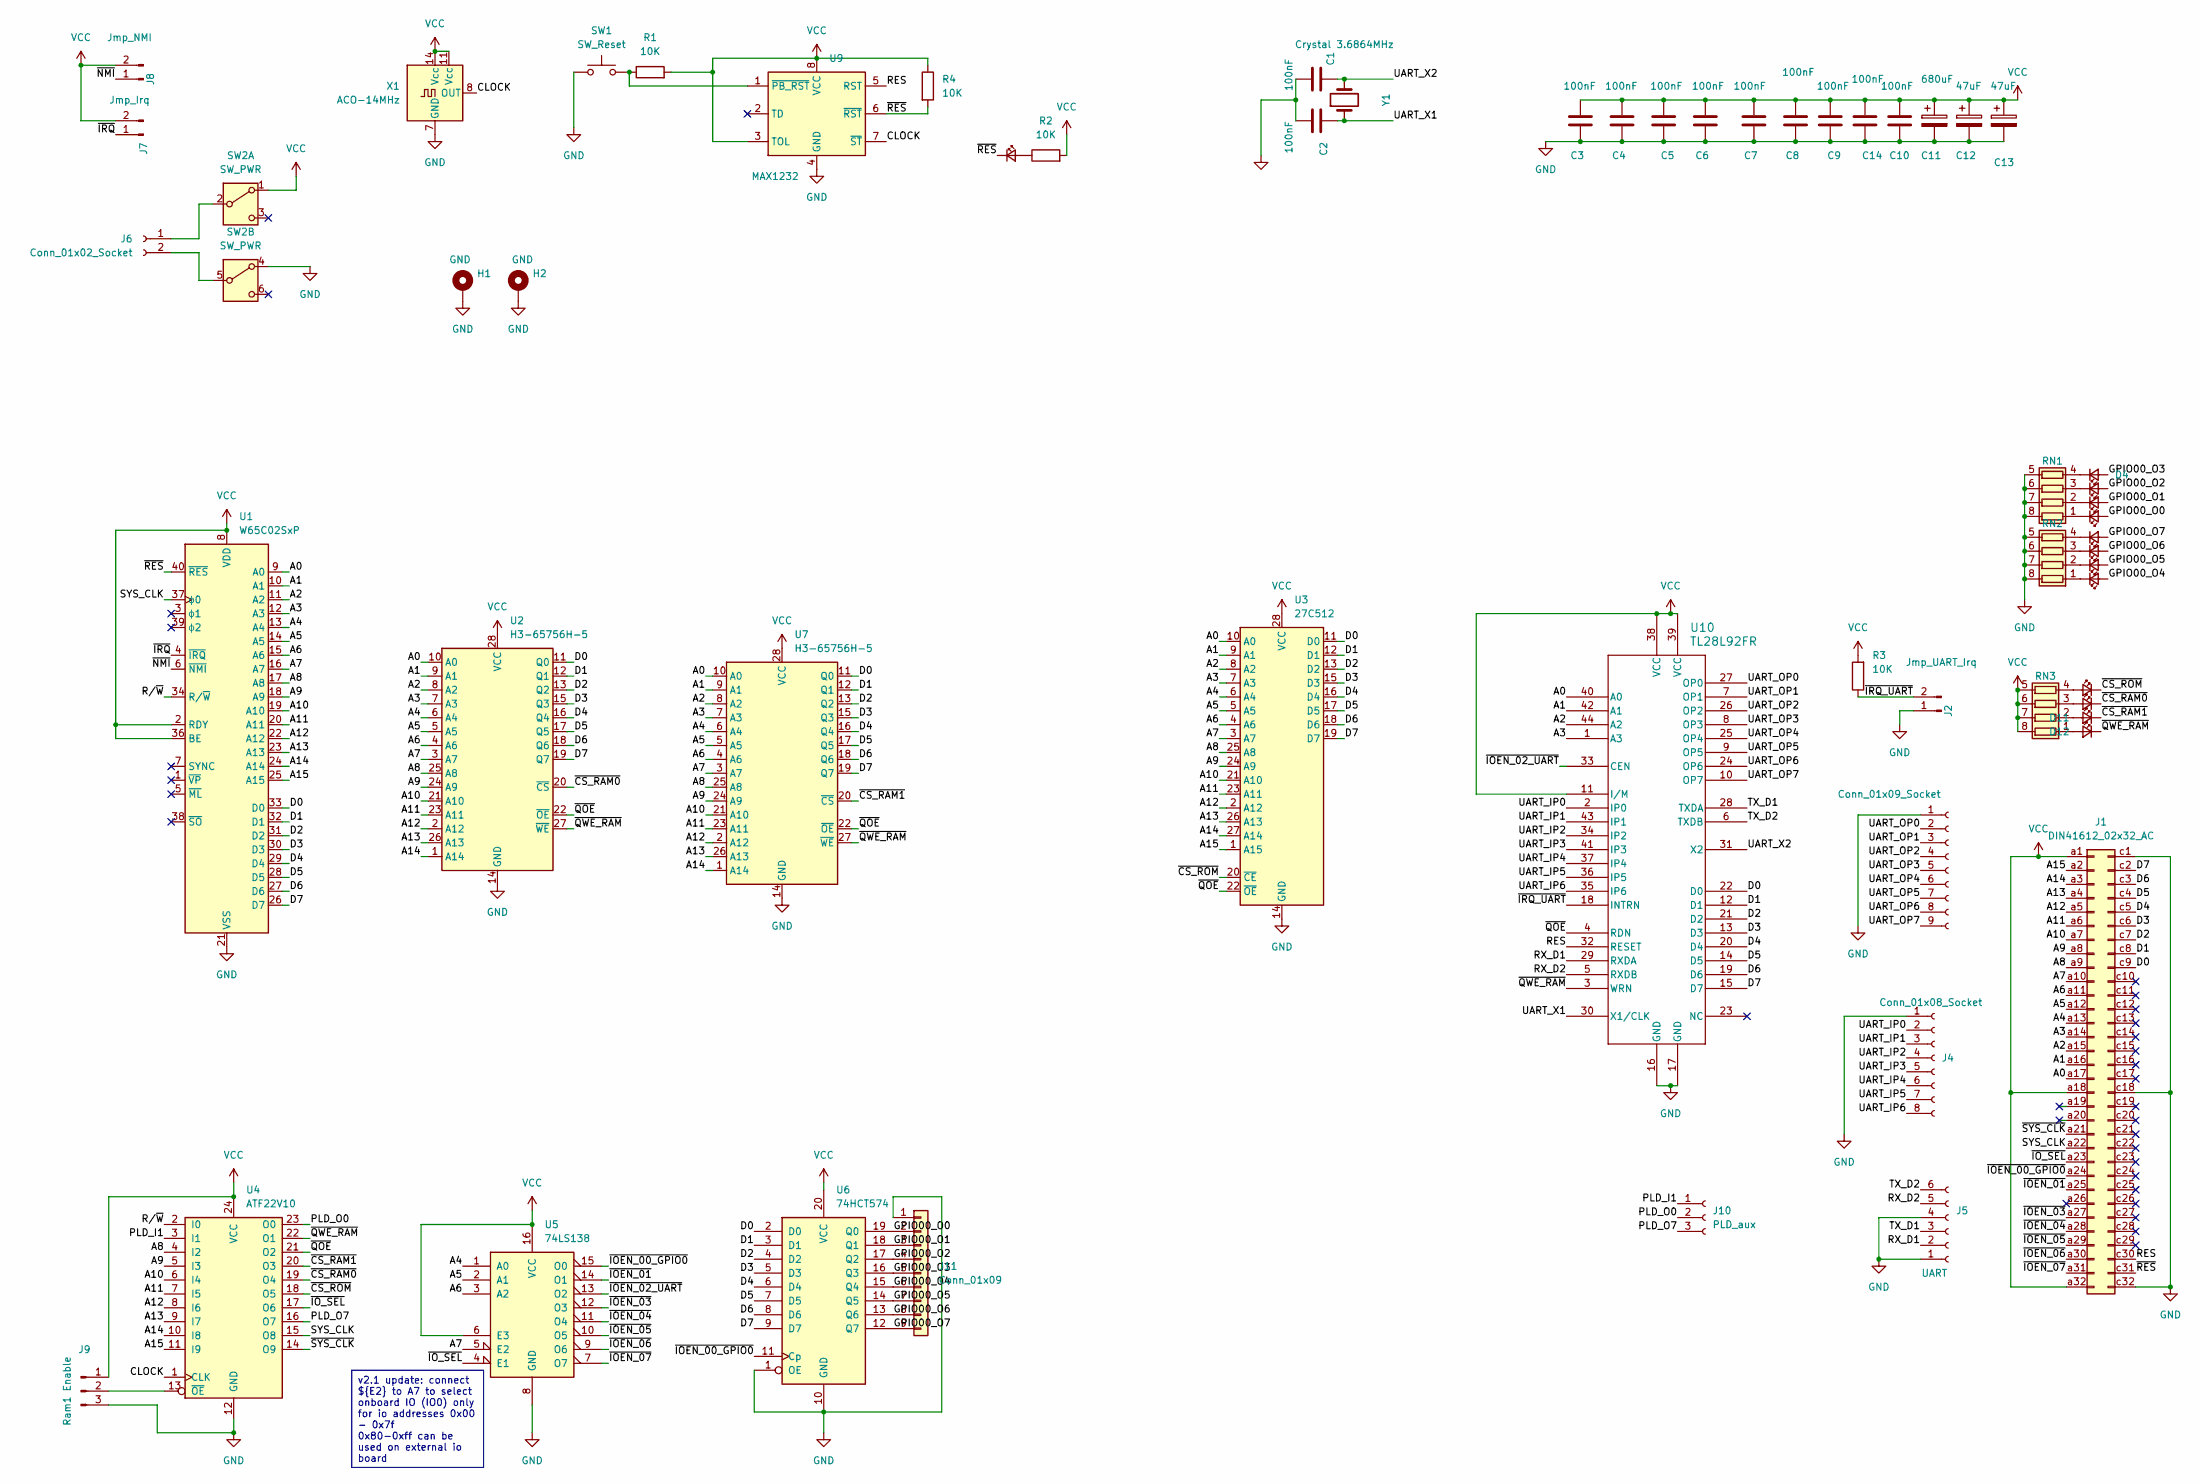
[picture p23: schematic cpu_board_02.kicad_sch]

Parts:
C1, C2: 100nF; C_Disc_D4.7mm_W2.5mm_P5.00mm
C3, C4, C5, C6, C7, C8, C9, C10, C14: 100nF; C_0805_2012Metric_Pad1.18x1.45mm_HandSolder
C11: 680uF; CP_Radial_D8.0mm_P5.00mm
C12, C13: 47uF; CP_Radial_D4.0mm_P2.00mm
D1, D2, D3, D4, D5, D6, D7, D8, D9, D10, D11, D12, D13: LED_Small; LED_0805_2012Metric_Pad1.15x1.40mm_HandSolder
H1, H2: GND; MountingHole_3.2mm_M3_DIN965_Pad
J1: DIN41612_02x32_AC; DIN41612_C_2x32_Male_Horizontal_THT
J2: Jmp_UART_Irq; PinSocket_1x02_P2.54mm_Vertical
J3: Conn_01x09_Socket; PinSocket_1x09_P2.54mm_Vertical
J4: Conn_01x08_Socket; PinSocket_1x08_P2.54mm_Vertical
J5: UART; PinSocket_1x06_P2.54mm_Vertical
J6: Conn_01x02_Socket; PinSocket_1x02_P2.54mm_Vertical
J7: Jmp_Irq; PinHeader_1x02_P2.54mm_Vertical
J8: Jmp_NMI; PinHeader_1x02_P2.54mm_Vertical
J9: Ram1 Enable; PinHeader_1x03_P2.54mm_Vertical
J10: PLD_aux; PinSocket_1x03_P2.54mm_Vertical
J11: Conn_01x09; PinSocket_1x09_P2.54mm_Vertical
R1, R2, R3, R4: 10K; R_0805_2012Metric_Pad1.20x1.40mm_HandSolder
RN1, RN2, RN3: R_Pack04; R_Array_Convex_4x0612
SW1: SW_Reset; SW_TH_Tactile_Omron_B3F-10xx
SW2: SW_PWR; 7x7DPDT
U1: W65C02SxP; DIP-40_W15.24mm_Socket
U2, U7: H3-65756H-5; DIP-28_W7.62mm_Socket
U3: 27C512; DIP-28_W15.24mm_Socket
U4: ATF22V10; DIP-24_W7.62mm_Socket
U5: 74LS138; DIP-16_W7.62mm_Socket
U6: 74HCT574; DIP-20_W7.62mm_Socket
U9: MAX1232; SO-8_3.9x4.9mm_P1.27mm
U10: TL28L92FR; MQFP-44_10x10mm_P0.8mm
X1: ACO-14MHz; DIP-14_W7.62mm
Y1: Crystal 3.6864MHz; Crystal_HC49-4H_Vertical

Connections:
/A0: J1.a17, U1.9 (A0), U2.10 (A0), U3.10 (A0), U7.10 (A0), U10.40 (A0)
/A1: J1.a16, U1.10 (A1), U2.9 (A1), U3.9 (A1), U7.9 (A1), U10.42 (A1)
/A2: J1.a15, U1.11 (A2), U2.8 (A2), U3.8 (A2), U7.8 (A2), U10.44 (A2)
/A3: J1.a14, U1.12 (A3), U2.7 (A3), U3.7 (A3), U7.7 (A3), U10.1 (A3)
/A4: J1.a13, U1.13 (A4), U2.6 (A4), U3.6 (A4), U5.1 (A0), U7.6 (A4)
/A5: J1.a12, U1.14 (A5), U2.5 (A5), U3.5 (A5), U5.2 (A1), U7.5 (A5)
/A6: J1.a11, U1.15 (A6), U2.4 (A6), U3.4 (A6), U5.3 (A2), U7.4 (A6)
/A7: J1.a10, U1.16 (A7), U2.3 (A7), U3.3 (A7), U5.5 (E2), U7.3 (A7)
/A8: J1.a9, U1.17 (A8), U2.25 (A8), U3.25 (A8), U4.4 (I2), U7.25 (A8)
/A9: J1.a8, U1.18 (A9), U2.24 (A9), U3.24 (A9), U4.5 (I3), U7.24 (A9)
/A10: J1.a7, U1.19 (A10), U2.21 (A10), U3.21 (A10), U4.6 (I4), U7.21 (A10)
/A11: J1.a6, U1.20 (A11), U2.23 (A11), U3.23 (A11), U4.7 (I5), U7.23 (A11)
/A12: J1.a5, U1.22 (A12), U2.2 (A12), U3.2 (A12), U4.8 (I6), U7.2 (A12)
/A13: J1.a4, U1.23 (A13), U2.26 (A13), U3.26 (A13), U4.9 (I7), U7.26 (A13)
/A14: J1.a3, U1.24 (A14), U2.1 (A14), U3.27 (A14), U4.10 (I8), U7.1 (A14)
/A15: J1.a2, U1.25 (A15), U3.1 (A15), U4.11 (I9)
/CLOCK: U4.1 (CLK), U9.7 (~ST), X1.8 (OUT)
/D0: J1.c9, U1.33 (D0), U2.11 (Q0), U3.11 (D0), U6.2 (D0), U7.11 (Q0), U10.22 (D0)
/D1: J1.c8, U1.32 (D1), U2.12 (Q1), U3.12 (D1), U6.3 (D1), U7.12 (Q1), U10.12 (D1)
/D2: J1.c7, U1.31 (D2), U2.13 (Q2), U3.13 (D2), U6.4 (D2), U7.13 (Q2), U10.21 (D2)
/D3: J1.c6, U1.30 (D3), U2.15 (Q3), U3.15 (D3), U6.5 (D3), U7.15 (Q3), U10.13 (D3)
/D4: J1.c5, U1.29 (D4), U2.16 (Q4), U3.16 (D4), U6.6 (D4), U7.16 (Q4), U10.20 (D4)
/D5: J1.c4, U1.28 (D5), U2.17 (Q5), U3.17 (D5), U6.7 (D5), U7.17 (Q5), U10.14 (D5)
/D6: J1.c3, U1.27 (D6), U2.18 (Q6), U3.18 (D6), U6.8 (D6), U7.18 (Q6), U10.19 (D6)
/D7: J1.c2, U1.26 (D7), U2.19 (Q7), U3.19 (D7), U6.9 (D7), U7.19 (Q7), U10.15 (D7)
/GPIO00_O0: D1.2 (A), J11.2, U6.19 (Q0)
/GPIO00_O1: D2.2 (A), J11.3, U6.18 (Q1)
/GPIO00_O2: D3.2 (A), J11.4, U6.17 (Q2)
/GPIO00_O3: D4.2 (A), J11.5, U6.16 (Q3)
/GPIO00_O4: D5.2 (A), J11.6, U6.15 (Q4)
/GPIO00_O5: D6.2 (A), J11.7, U6.14 (Q5)
/GPIO00_O6: D7.2 (A), J11.8, U6.13 (Q6)
/GPIO00_O7: D8.2 (A), J11.9, U6.12 (Q7)
/PLD_I1: J10.1, U4.3 (I1)
/PLD_O0: J10.2, U4.23 (O0)
/PLD_O7: J10.3, U4.16 (O7)
/RES: J1.c30, U9.5 (RST), U10.32 (RESET)
/RX_D1: J5.2, U10.29 (RXDA)
/RX_D2: J5.5, U10.5 (RXDB)
/R/~W: U1.34 (R/~W), U4.2 (I0)
/SYS_CLK: J1.a22, U1.37 (ϕ0), U4.15 (O8)
/TX_D1: J5.3, U10.28 (TXDA)
/TX_D2: J5.6, U10.6 (TXDB)
/UART_IP0: J4.2, U10.2 (IP0)
/UART_IP1: J4.3, U10.43 (IP1)
/UART_IP2: J4.4, U10.34 (IP2)
/UART_IP3: J4.5, U10.41 (IP3)
/UART_IP4: J4.6, U10.37 (IP4)
/UART_IP5: J4.7, U10.36 (IP5)
/UART_IP6: J4.8, U10.35 (IP6)
/UART_OP0: J3.2, U10.27 (OP0)
/UART_OP1: J3.3, U10.7 (OP1)
/UART_OP2: J3.4, U10.26 (OP2)
/UART_OP3: J3.5, U10.8 (OP3)
/UART_OP4: J3.6, U10.25 (OP4)
/UART_OP5: J3.7, U10.9 (OP5)
/UART_OP6: J3.8, U10.24 (OP6)
/UART_OP7: J3.9, U10.10 (OP7)
/UART_X1: C2.1, U10.30 (X1/CLK), Y1.1
/UART_X2: C1.1, U10.31 (X2), Y1.2
/~CS_RAM0: D10.1 (K), U2.20 (~CS), U4.19 (O4)
/~CS_RAM1: D11.1 (K), U4.20 (O3), U7.20 (~CS)
/~CS_ROM: D9.1 (K), U3.20 (~CE), U4.18 (O5)
/~IOEN_00_GPIO0: J1.a24, U5.15 (O0), U6.11 (Cp)
/~IOEN_01: J1.a25, U5.14 (O1)
/~IOEN_02_UART: U5.13 (O2), U10.33 (CEN)
/~IOEN_03: J1.a27, U5.12 (O3)
/~IOEN_04: J1.a28, U5.11 (O4)
/~IOEN_05: J1.a29, U5.10 (O5)
/~IOEN_06: J1.a30, U5.9 (O6)
/~IOEN_07: J1.a31, U5.7 (O7)
/~IO_SEL: J1.a23, U4.17 (O6), U5.4 (E1)
/~IRQ_UART: J2.2, R3.1, U10.18 (INTRN)
/~IRQ: J7.1, U1.4 (~IRQ)
/~NMI: J8.1, U1.6 (~NMI)
/~QOE: U2.22 (~OE), U3.22 (~OE), U4.21 (O2), U7.22 (~OE), U10.4 (RDN)
/~QWE_RAM: D12.1 (K), U2.27 (~WE), U4.22 (O1), U7.27 (~WE), U10.3 (WRN)
/~RES: D13.1 (K), J1.c31, R4.2, U1.40 (~RES), U9.6 (~RST)
/~SYS_CLK: J1.a21, U4.14 (O9)
GND: C1.2, C2.2, C3.2, C4.2, C5.2, C6.2, C7.2, C8.2, C9.2, C10.2, C11.2, C12.2, C13.2, C14.2, H1.1, H2.1, J1.c1, J1.c18, J1.c32, J2.1, J3.1, J4.1, J5.1, J5.4, J9.3, J11.1, RN1.5 (R4.2), RN1.6 (R3.2), RN1.7 (R2.2), RN1.8 (R1.2), RN2.5 (R4.2), RN2.6 (R3.2), RN2.7 (R2.2), RN2.8 (R1.2), SW1.2, SW2.4 (A), U1.21 (VSS), U2.14 (GND), U3.14 (GND), U4.12 (GND), U5.8 (GND), U6.1 (OE), U6.10 (GND), U7.14 (GND), U9.4 (GND), U10.16 (GND), U10.17 (GND), X1.7 (GND)
unnamed: D1.1 (K), RN1.1 (R1.1)
unnamed: D2.1 (K), RN1.2 (R2.1)
unnamed: D3.1 (K), RN1.3 (R3.1)
unnamed: D4.1 (K), RN1.4 (R4.1)
unnamed: D5.1 (K), RN2.1 (R1.1)
unnamed: D6.1 (K), RN2.2 (R2.1)
unnamed: D7.1 (K), RN2.3 (R3.1)
unnamed: D8.1 (K), RN2.4 (R4.1)
unnamed: D9.2 (A), RN3.4 (R4.1)
unnamed: D10.2 (A), RN3.3 (R3.1)
unnamed: D11.2 (A), RN3.2 (R2.1)
unnamed: D12.2 (A), RN3.1 (R1.1)
unnamed: D13.2 (A), R2.1
unnamed: J6.1, SW2.2 (B)
unnamed: J6.2, SW2.5 (B)
unnamed: J9.2, U4.13 (~OE)
unnamed: R1.1, SW1.1, U9.1 (~PB_RST)
VCC: C3.1, C4.1, C5.1, C6.1, C7.1, C8.1, C9.1, C10.1, C11.1, C12.1, C13.1, C14.1, J1.a1, J1.a18, J1.a32, J7.2, J8.2, J9.1, R1.2, R2.2, R3.2, R4.1, RN3.5 (R4.2), RN3.6 (R3.2), RN3.7 (R2.2), RN3.8 (R1.2), SW2.1 (A), U1.2 (RDY), U1.8 (VDD), U1.36 (BE), U2.28 (VCC), U3.28 (VCC), U4.24 (VCC), U5.6 (E3), U5.16 (VCC), U6.20 (VCC), U7.28 (VCC), U9.3 (TOL), U9.8 (VCC), U10.11 (I/M), U10.38 (VCC), U10.39 (VCC), X1.11 (Vcc), X1.14 (Vcc)

Notes on the sheet:
v2.1 update: connect ${E2} to A7 to select onboard IO (IO0) only for io addresses 0x00 - 0x7f 0x80-0xff can be used on external io board

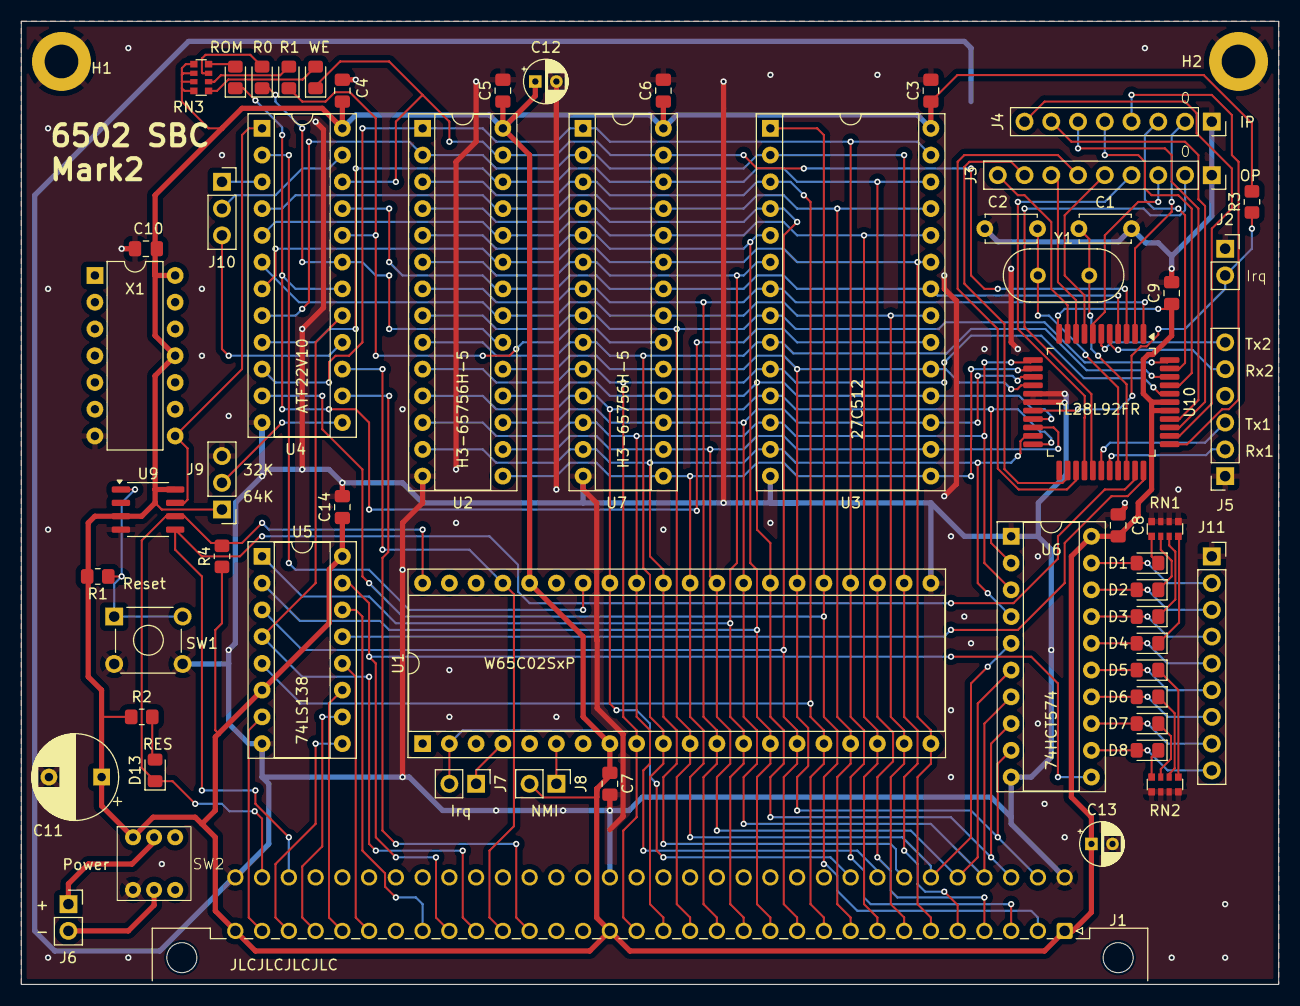
[picture p24: board cpu_board_02.kicad_pcb from above]

Board: 2 copper layers, 119.4 x 91.4 mm, 60 parts (0 on the bottom side), 98 nets.
