sim82/6502_sbc/17_dos.asm

.IMPORT put_newline, uart_init, putc, getc, fputc, fgetc, fgetc_nonblocking, fpurge, print_hex16, print_hex8
.import fgetc_buf, open_file_nonpaged
.import file_open_raw
.import reset_tokenize, read_token, retire_token, terminate_token
.import read_file_paged
.import print_message, decode_nibble, decode_nibble_high
.import load_relocatable_binary
.import init_pagetable, alloc_page, alloc_page_span, free_page_span, free_user_pages
.import cmd_help_str, cmd_help, cmd_alloc_str, cmd_alloc, cmd_j_str, cmd_j, cmd_r_str, cmd_r, cmd_ra_str, cmd_ra, cmd_m_str, cmd_m, cmd_fg_str, cmd_fg, cmd_test, cmd_test_str
.import print_dec
.export get_argn, get_arg, load_binary, jsr_receive_pos, welcome_message, back_to_dos_message, rand_8, set_direct_timer
.include "17_dos.inc"
.include "os.inc"

RESIDENT_STATE_NONE = $00
RESIDENT_STATE_INITIAL = $01
RESIDENT_STATE_RUN = $02
RESIDENT_STATE_SLEEP = $03



UART_CLK = 3686400 ; 3.6864 MHz

.macro uart_start_timer timer_hz
	lda #%01110000
	sta IO_UART2_ACR

	; setup timer divider low / high bytes
	lda #((UART_CLK / (timer_hz * 16)) .MOD 256)
	sta IO_UART2_CTPL
	lda #((UART_CLK / (timer_hz * 16)) / 256)
	sta IO_UART2_CTPU

	; start timer
	lda IO_UART2_CSTA
.endmacro

.macro uart_start_timer_high timer_hz
	lda #%01100000
	sta IO_UART2_ACR
	; setup timer divider low / high bytes
	lda #((UART_CLK / (timer_hz)) .MOD 256)
	sta IO_UART2_CTPL
	lda #((UART_CLK / (timer_hz)) / 256)
	sta IO_UART2_CTPU

	; start timer
	lda IO_UART2_CSTA
.endmacro

.SEGMENT "VECTORS"
START_VECTOR:
	.word coldboot_entrypoint
IRQ_VECTOR:
	.word irq
	; .word $0000

.CODE
coldboot_entrypoint:
	ldx #$ff
	txs 

	sei
	
	jsr uart_init
	lda #%00001010
	sta IO_UART2_IMR

	uart_start_timer 10

	; lda IO_UART2_CSTO
	
	; lda #<irq
	; sta $fdfe
	
	; lda #>irq
	; sta $fdfe+1

	; jmp @skip_init
	jsr init_pagetable
	
;;;;;;;;;;;;;;;;;;;;;;;;;;;;;;;;;
;  	lda #%11001100
; @loop:
; 	sta IO_GPIO0
; 	jmp @loop
;;;;;;;;;;;;;;;;;;;;;;;;;;;;;;;;;
	jmp skip_warmboot_message

warmboot_entrypoint:
	jsr put_newline
	print_message_from_ptr warmboot_message

skip_warmboot_message:
	; init local vars
	lda #$00
	sta oss_input_line_ptr
	sta oss_user_process
	sta oss_input_char
	sta oss_irq_timer
	sta zp_dt_count_l
	sta zp_dt_count_h
	sta direct_timer_h
; @skip_init:
	jsr clear_resident

; @loop:
; 	jsr getc
; 	bcc @loop
; 	jsr print_hex8
; 	jmp @loop
; @loop:
; 	jsr getc
; 	bcc @loop
; 	jsr putc
; 	jmp @loop

	jsr put_newline
	print_message_from_ptr welcome_message

	lda #'>'
	jsr putc

@wait_loop:
	; check if there is a resident process
	lda oss_resident_state
	beq @no_resident_run

	; RESIDENT_STATE_INITIAL-> send OS_EVENT_INIT 
	cmp #RESIDENT_STATE_INITIAL
	bne @not_init
	lda #OS_EVENT_INIT
	sta oss_resident_event
	jsr run_resident

	; if resident state == 0 after run_resident -> process exited. go right to sleep

	lda oss_resident_state
	beq @sleep
	
	; otherwise promote it to a resident process
	lda #RESIDENT_STATE_RUN
	sta oss_resident_state
	jmp @sleep

@not_init:
	cmp #RESIDENT_STATE_RUN
	bne @no_resident_run
	
	; check timer
	
	lda oss_irq_timer
	beq @no_timer
	lda #OS_EVENT_TIMER
	sta oss_resident_event
	jsr run_resident
	lda #$00
	sta oss_irq_timer
@no_timer:
	lda oss_input_char
	; go right back to sleep if there is no input char (wakeup was due to timer)
	; TODO: check / log if there are 'spurious' wakeups...
	beq @sleep
	; check ctrl-z	
	cmp #$1a
	bne @no_to_background
	lda #RESIDENT_STATE_SLEEP
	sta oss_resident_state 
	jsr put_newline
	jsr print_prompt
	jmp @sleep
	
@no_to_background:
	; check ctrl-c
	cmp #$03
	bne @no_cancel

	jsr check_unclean_exit
@no_direct_timer:
	; cleanup process
	; meeeep! redundant!
	lda oss_receive_pos + 1
	jsr free_page_span
	jsr free_user_pages
	jsr clear_resident
	jsr put_newline
	jsr print_prompt
	jmp @sleep

@no_cancel:
	; send input char as OS_EVENT_KEY
	sta oss_resident_eventdata
	lda #OS_EVENT_KEY
	sta oss_resident_event
	jsr run_resident
	; clear input char after one key event was sent
	lda #$00
	sta oss_input_char
	jmp @sleep

@no_resident_run:
	; chicken rivet: disable irq during os internal commands
	; not sure if an irq is enough to mess up the bulk file read loop...
	; sei
	; if no resident program is running, process input with command processor
	lda oss_input_char
	beq @sleep
	jsr process_input
	lda #$00
	sta oss_input_char
	lda oss_resident_state
	cmp #RESIDENT_STATE_INITIAL
	beq @skip_sleep ; @wait_loop is too far away for an indirect jump...

@sleep:
	cli
	wai ; look at me, I sleep all day like the big CPUs...
@skip_sleep:
	jmp @wait_loop

check_unclean_exit:
	; if process had direct timer running recover via coldboot
	lda direct_timer_h
	beq @no_direct_timer
	print_message_from_ptr failed_exit_message
	jmp coldboot_entrypoint
@no_direct_timer:
	rts

run_resident:
	lda #$00
	sta oss_resident_return
	lda #$ff
	sta oss_user_process
	jsr jsr_receive_pos
	lda #$00
	sta oss_user_process
	lda oss_resident_return
	; non-zero return code -> keep resident
	bne @keep_resident
	jsr check_unclean_exit
	jsr clear_resident
	lda oss_receive_pos + 1
	jsr free_page_span
	jsr free_user_pages
	jsr clear_resident
	jmp @exit ; skip printing '*'
	
@keep_resident:
	; lda #'*'
	; jsr putc
	rts
	
@exit:
	print_message_from_ptr back_to_dos_message

	jsr print_prompt
	rts

jsr_resident:
	jmp (oss_resident_entrypoint)
	jmp jsr_resident

clear_resident:
	lda #$00
	sta oss_resident_state
	; sta oss_resident_entrypoint
	; sta oss_resident_entrypoint + 1
	rts

irq:
	; lda #$ff
	; sta IO_GPIO0
	; lda #$ff
	; sta IO_GPIO0
	; NOTE: no pha, since A is already pushed in 1st level irq handler in rom (bootloader)!
	lda IO_UART2_ISR
	sta IRQ_TMP_A
	; check if timer interrupt
	and #%00001000
	; no? -> skip all timer code
	beq @no_timer
	; 1st thing: reset the uart timer (it is quite slow and resetting it too late can cause double interrupts)
	lda IO_UART2_CSTO

	; check if direct timer is enabled
	lda direct_timer_h
	; no direct timer -> just trigger os timer
	beq @trigger_os_timer

	; call direct timer vector
	jsr direct_timer_vector

	; check if os timer should also be triggered
	; lda zp_dt_count_l
	; sec
	; sbc #1
	; sta zp_dt_count_l
	; lda zp_dt_count_h
	; sbc #0
	; sta zp_dt_count_h
	; ora zp_dt_count_l
	; uhm, is a 16bit count-down really that simple?
	dec zp_dt_count_l
	bne @no_timer
	dec zp_dt_count_h
	bmi @do_timer ; think about this again...

@do_timer:
	; reset os timer counters from divisor	

	lda #0
	sta zp_dt_count_h
	lda oss_dt_div16
	sta zp_dt_count_l
	asl zp_dt_count_l
	rol zp_dt_count_h
	asl zp_dt_count_l
	rol zp_dt_count_h
	asl zp_dt_count_l
	rol zp_dt_count_h
	asl zp_dt_count_l
	rol zp_dt_count_h
	
@trigger_os_timer:
	lda #1
	sta oss_irq_timer
@no_timer:
	
	lda IRQ_TMP_A
	and #%00000010
	beq @no_char
	jsr getc
	bcs @use_char

	lda #$00
@use_char:
	cmp #$18
	beq @handle_ctrlx
	sta oss_input_char
	; sta IO_GPIO0

@no_char:
	; lda #$00
	; sta IO_GPIO0
	pla
	rti

@handle_ctrlx:
	lda oss_user_process
	beq @cold_boot
	ldx #$ff
	txs
	cld
	sei
	jmp warmboot_entrypoint
@cold_boot:
	jmp coldboot_entrypoint

print_prompt:
	lda oss_resident_state
	beq @no_resident
	lda #'*'
	jsr putc
@no_resident:
	lda #'>'
	jsr putc
	rts


	
; read_input:
; 	jsr getc
; 	bcc read_input 		; busy wait for character
	; pha
	; jsr print_hex8
	; jsr put_newline
	; pla
process_input:
	cmp #$0a 		; ignore LF / \n
	beq @ignore_input
	cmp #$03		; ignore ctrl-c
	beq @ignore_input
	cmp #$1a 		; ignore ctrl-z
	beq @ignore_input
	cmp #$18
	beq @ignore_input       ; ignore ctrl-x
	
	cmp #$0d 		; enter key is CR / \r 
	bne @no_enter_key
	jsr put_newline		; handle enter: - put newline
	jsr exec_input_line     ;               - execute input line
	jsr print_prompt
	rts
	
@no_enter_key:
	cmp #$08		; handle backspace
	bne @normal_char
	ldy oss_input_line_ptr	; check if input line is empty -> ignore backspace
	beq @exit
	dec oss_input_line_ptr	; delete last char (dec ptr)

	; rub-out character on terminal
	jsr putc		; send the backspace (move cursor back)
	lda #' '		; overwrite with space
	jsr putc
	lda #$08		; send another backspace to move cursor back onto space
	jsr putc
	; jmp mainloop
@ignore_input:
@exit:
	rts
@normal_char:
	; TODO: ignore non-printable chars
	ldy oss_input_line_ptr	; append normal char to input line
	cpy #INPUT_LINE_LEN	;   check if input line is full
	beq @buf_full
	sta oss_input_line, y	;   store char at current input line ptr
	jsr putc		;   local echo
	inc oss_input_line_ptr	;   in-place increase input line ptr
	; fall through
@buf_full:
	rts

compare_token:
	ldy #$00
@loop:
	cpy oss_next_token_end
	beq @found

	lda oss_input_line, y ; looks sus... shouldn't this be offset to current token? Works only for the first token (!?)
	; jsr putc
	cmp (zp_ptr), y
	bne @mismatch
	iny
	jmp @loop

@found:
	; now check if we reached the end of the target string (null termination)
	; iny
	; lda (zp_ptr), y
	; jsr putc

	lda #$00
	cmp (zp_ptr), y
	bne @mismatch
	sec
	rts
	
@mismatch:
	clc
	rts
	

jsr_receive_pos:
	jmp (oss_receive_pos)
	jmp jsr_receive_pos

load_binary:
	; meaning of zp_io_addr vs oss_receive_pos: 
	;  - zp_io_addr: in ZP, used for indirect addressing and modified during read
	;  - oss_receive_pos: no need to be in ZP, used as entry point to program after read

	lda #0
	sta zp_fletch_1
	sta zp_fletch_2
	jsr fgetc	; read target address low byte
	sta oss_receive_pos
	sta zp_io_addr
	jsr fgetc	; and high byte
	sta oss_receive_pos + 1	
	sta zp_io_addr + 1
	; check for file error: target addr $ffff
	cmp #$FF
	bne @no_error
	lda TARGET_ADDR
	cmp #$FF
	bne @no_error
	; fell through both times -> error
	clc
	rts

@no_error:
	; set up for read_file_paged
	store_address @load_binary_page_completion, oss_io_fun
	jsr read_file_paged
	bcc @read_error
	lda zp_fletch_1
	ldx zp_fletch_2
	jsr print_hex16
	jsr put_newline
	sec
@read_error:
	rts

@load_binary_page_completion:
	lda zp_io_addr + 1	; QoL: spin windmill
	jsr print_windmill
	inc zp_io_addr + 1	;  and inc io address by 256 each
	rts

exec_input_line:
	; add null termination at end of input line to make parsing more convenient
	ldx oss_input_line_ptr
	lda #$00
	sta oss_input_line, x
	jsr fgetc_nonblocking
	bcs exec_input_line
	jsr fpurge
	jsr reset_tokenize
	jsr read_token
	bcs @dispatch_builtin
	jmp @cleanup

@dispatch_builtin:
	dispatch_command cmd_help_str, cmd_help
	dispatch_command cmd_r_str, cmd_r
	dispatch_command cmd_m_str, cmd_m
	dispatch_command cmd_j_str, cmd_j
	dispatch_command cmd_alloc_str, cmd_alloc
	dispatch_command cmd_ra_str, cmd_ra
	dispatch_command cmd_fg_str, cmd_fg
	dispatch_command cmd_test_str, cmd_test

	; fall through. successfull commands jump to @cleanup from macro
; @end:

	lda #$00
	sta oss_argc
		
@arg_loop:
	ldy oss_argc
	inc oss_argc
	lda oss_next_token_ptr
	sta oss_argv, y
	jsr print_hex8
	jsr terminate_token
	jsr retire_token
	jsr read_token
	bcs @arg_loop

 	jsr put_newline
	lda oss_argv
	ldx #>oss_input_line
	jsr load_relocatable_binary
	bcc @cleanup
	lda oss_receive_pos
	sta oss_resident_entrypoint
	lda oss_receive_pos + 1
	sta oss_resident_entrypoint + 1
	lda #RESIDENT_STATE_INITIAL
	sta oss_resident_state
	
@cleanup:
	ldy #$0
	sty oss_input_line_ptr
	jsr put_newline
	rts
	
cat_iobuffer:
	stx zp_ptr
	ldy #$00
@loop:
	lda IO_BUFFER, y
	jsr putc
	cmp #$0A
	bne @jump_linefeed
	lda #$0D
	jsr putc
@jump_linefeed:
	iny
	cpy zp_ptr
	bne @loop
	rts

	
print_windmill:
	and #$3
	tay
	lda windmill, y
	jsr putc
	lda #$08
	jsr putc
	rts


get_argn:
	lda oss_argc
	rts

get_arg:
	cmp oss_argc
	bpl @out_of_range

	tax
	lda oss_argv, x
	ldx #>oss_input_line
	sec
	rts

@out_of_range:
	clc
	rts
	
rand_8:
	phy
	phx
	; tya
	; pha
	; txa
	; pha
	LDA	oss_rand_seed		; get seed
	AND	#$b8		; mask non feedback bits
				; for maximal length run with 8 bits we need
				; taps at b7, b5, b4 and b3
	LDX	#$05		; bit count (shift top 5 bits)
	LDY	#$00		; clear feedback count
@f_loop:
	ASL	A		; shift bit into carry
	BCC	@bit_clr	; branch if bit = 0

	INY			; increment feedback count (b0 is XOR all the	
				; shifted bits from A)
@bit_clr:
	DEX			; decrement count
	BNE	@f_loop		; loop if not all done

@no_clr:
	TYA			; copy feedback count
	LSR	A		; bit 0 into Cb
	LDA	oss_rand_seed	; get seed back
	ROL	A		; rotate carry into byte
	STA	oss_rand_seed	; save number as next seed
	plx
	ply
	; pla
	; tax
	; pla
	; tay
	lda oss_rand_seed
	RTS			; done

set_direct_timer:
	sta direct_timer_l
	stx direct_timer_h
	beq @stop_direct_timer
	
	lda #0
	sta zp_dt_count_h
	sty oss_dt_div16
	sty zp_dt_count_l
	
	asl zp_dt_count_l
	rol zp_dt_count_h
	asl zp_dt_count_l
	rol zp_dt_count_h
	asl zp_dt_count_l
	rol zp_dt_count_h
	asl zp_dt_count_l
	rol zp_dt_count_h
	uart_start_timer 10000
	lda zp_dt_count_l
	ldx zp_dt_count_h
	rts
@stop_direct_timer:

	uart_start_timer 10
	rts
	
; hacky: vector pointer for direct timer
direct_timer_vector:
	jmp (direct_timer)
	
direct_timer:
direct_timer_l:
	.byte $00
direct_timer_h: 
	.byte $00 


windmill:
	.byte "-\|/"

welcome_message:
	.byte "dos v3.3", $0A, $0D, $00



back_to_dos_message:
	.byte "Back in control..", $0A, $0D, $00
warmboot_message:
	.byte "entry via warmboot..", $0A, $0D, $00
failed_exit_message:
	.byte "Process exit recovery (coldboot)", $0A, $0D, $00
