sim82/6502_sbc/32_vector_dac.asm

.INCLUDE "std.inc"
.INCLUDE "os.inc"

.ZEROPAGE
x0: .res $1
y0: .res $1
x1: .res $1
y1: .res $1
xi: .res $1
yi: .res $1
xe: .res $1
d: .res $1
dx2: .res $1
dy2: .res $1
absx: .res $1
absy: .res $1
tw: .res $1
neg: .res $1
pi: .res $1
ii: .res $1
fi: .res $1
fc: .res $1
q13: .res $1
xoffs: .res $1
yoffs: .res $1

.BSS
pointsx:
	.res $100
pointsy:
	.res $100

.CODE
	jsr os_get_event
	cmp #OS_EVENT_INIT
	beq dispatch_init

	cmp #OS_EVENT_KEY
	beq dispatch_key
	; beq event_char_boxtest

	cmp #OS_EVENT_TIMER
	beq dispatch_timer
	
	
	rts

dispatch_init:
	jmp event_init

dispatch_key:
	jmp event_key

dispatch_timer:
	jmp event_timer

	
event_init:
	lda #<init_message
	ldx #>init_message
	jsr os_print_string
	jsr os_putnl

	ldx #0
	stx pi
	stx fi
	stx fc
	lda #0
	
	lda #00
	sta ii
	
	lda #0
	ldx #0
	
	lda #10
	sta xoffs
	sta yoffs

	lda #0
	sta x1
	lda #32
	sta x0
	lda #0
	sta y0
	lda #32
	sta y1
	jsr render_square
	
; start direct timer
	lda #<direct_timer
	ldx #>direct_timer
	; lda #<direct_timer
	; ldx #>direct_timer
	ldy #3 ; set timer div to 6 * 16 = 96 ~ 100Hz (at 10kHz direct timer rate)
	jsr os_set_direct_timer


	lda #OS_EVENT_RETURN_KEEP_RESIDENT
	jsr os_event_return
	rts

event_key:
	txa
	cmp #'q'
	beq @exit_non_resident
@exit_resident:
	lda #OS_EVENT_RETURN_KEEP_RESIDENT
	jsr os_event_return
	rts 
@exit_non_resident:
	lda #00
	ldx #00
	jsr os_set_direct_timer
	lda #OS_EVENT_RETURN_EXIT
	jsr os_event_return
	rts 

	
event_timer:
	; lda #'y'
	; jsr os_putc

; 	lda y1
; 	inc
; 	cmp #64
; 	bne @no_reset
; 	lda #0

; @no_reset:
; 	sta y1
; 	jsr bresenhamq0
	; inc x0
	; inc x1
	; inc y0
	; inc y1
	; ; jsr render_square
	; jsr setup_bresenham
	; jmp @skipy
	; lda #90
	inc xoffs
	; cmp xoffs
	; bcs @skipx
	; ldy #0
	; sty xoffs

@skipx:
	inc yoffs
	; cmp xoffs
	; bcs @skipx
	; ldy #0
	; sty xoffs
@skipy:
	lda #OS_EVENT_RETURN_KEEP_RESIDENT
	jsr os_event_return
	rts

direct_timer:
	; NOTE: make sure not to clobber X/Y registers! only A is auto restored by irq handler! (but don't waste time...)
	phx
	phy
	php

	; ldx pi
	; ; stx IO_GPIO20
	; ; stx IO_GPIO21

	; lda pointsx, x
	; sta IO_GPIO20
	; lda pointsy, x
	; sta IO_GPIO21
	; inx
	; stx pi

	jsr step_bresenham2
	
; @ldloop:

	; jsr bresenhamq0

	plp
	ply
	plx
	rts
	
bresenhamq0:
	; calc D = 2 * (y1 - y0) - (x1-x0)
	; = (y1 - y0) * 2 - x1 + x0

	lda y1
	sec
	sbc y0
	asl
	sec
	sbc x1
	clc
	adc x0
	sta d
	; calc 2dx = 2 (x1 - x0)
	lda x1
	sec
	sbc x0
	asl
	sta dx2
	; calc 2dy = 2 (y1 - y0)
	lda y1
	sec
	sbc y0
	asl
	sta dy2

	ldy y0
	ldx x0
@loop:
	stx IO_GPIO20
	sty IO_GPIO21
	lda d
	bmi @no_y
	sec
	sbc dx2
	iny
@no_y:
	clc
	adc dy2
	sta d
	inx
	cpx x1
	bne @loop
	rts
	
setup_bresenham:
	; jmp @skip_print
	ldx #0
	lda x0
	jsr os_print_dec
	lda #' '
	jsr os_putc
	lda y0
	jsr os_print_dec
	lda #'-'
	jsr os_putc
	lda x1
	jsr os_print_dec
	lda #' '
	jsr os_putc
	lda y1
	jsr os_print_dec
	lda #' '
	jsr os_putc
@skip_print:
	; determine quadrant:
	; x0 <= x1 -> q0 or q1
	lda x0
	cmp x1
	bcc @q01
	beq @q01
@q23:
	lda y0
	cmp y1
	
	bcc @q3
	beq @q3
@q2:
	lda #'2'
	jsr os_putc
	lda #0
	sta q13
	; calc dx (inv), temporarily store in dx2
	lda x0
	sec
	sbc x1
	sta dx2
	
	; calc & store dy2 (inv)
	lda y0
	sec
	sbc y1
	asl
	sta dy2
	lda x1
	sta xi
	lda x0
	sta xe

	lda y1
	sta yi
	jmp @start

@q3:
	lda #'d'
	jsr os_putc
	lda #1
	sta q13
	; calc dx (inv), temporarily store in dx2
	lda x0
	sec
	sbc x1
	sta dx2
	
	; calc & store dy2
	lda y1
	sec
	sbc y0
	asl
	sta dy2
	lda x1
	sta xi
	lda x0
	sta xe

	lda y1
	sta yi
	jmp @start
@q01:
	; q0 or q1
	
	lda y0
	cmp y1
	bcc @q0
	beq @q0
@q1:
	lda #'b'
	jsr os_putc
	lda #1
	sta q13
	; calc dx, temporarily store in dx2
	lda x1
	sec
	sbc x0
	sta dx2
	
	; calc & store dy2 (inv)
	lda y0
	sec
	sbc y1
	asl
	sta dy2
	lda x0
	sta xi
	lda x1
	sta xe

	lda y0
	sta yi
	jmp @start

@q0:
	lda #'a'
	jsr os_putc
	
	lda #0
	sta q13
	; calc dx, temporarily store in dx2
	lda x1
	sec
	sbc x0
	sta dx2
	
	; calc & store dy2
	lda y1
	sec
	sbc y0
	asl
	sta dy2
	lda x0
	sta xi
	lda x1
	sta xe

	lda y0
	sta yi

@start:
	; subtract dx and store in d
	sec
	sbc dx2
	sta d
	; calc & store true dx2
	asl dx2

	rts

step_bresenham:
	lda q13
	bne step_bresenhamq13
	; fall through
step_bresenhamq02:
	ldx xi
	ldy yi
	txa
	clc
	adc xoffs
	sta IO_GPIO20

	tya
	clc
	adc yoffs
	sta IO_GPIO21

	lda d
	bmi @no_y
	sec
	sbc dx2
	iny
@no_y:
	clc
	adc dy2
	sta d
	inx
	cpx xe
	beq @reset
	stx xi
	sty yi
	jmp @end

@reset:
	jsr advance_line
	jsr setup_bresenham
@end:
	rts

step_bresenhamq13:
	ldx xi
	ldy yi
	txa
	clc
	adc xoffs
	sta IO_GPIO20

	tya
	clc
	adc yoffs
	sta IO_GPIO21

	lda d
	bmi @no_y
	sec
	sbc dx2
	dey
@no_y:
	clc
	adc dy2
	sta d
	inx
	cpx xe
	beq @reset
	stx xi
	sty yi
	jmp @end

@reset:
	jsr advance_line
	jsr setup_bresenham
@end:
	rts
	
advance_line:
	; load current 'fragment counter' (i.e. how many line segments there are to go)
	lda fc

	; != 0 -> still in the same fragment
	bne @same_fragment

	; fragments[fi] contains next fragment size
	ldx fi
	; lda #'f'
	; jsr os_putc
	lda fragments, x
	; sta ARG0
	; jsr os_dbg_byte
	sta fc
	; $ff means end of fragment array
	cmp #$ff
	bne @no_restart
	; reset everything
	lda #00
	sta fc
	sta fi
	; restart
	jmp advance_line

@no_restart:
	sta fc
	inx
	stx fi

@same_fragment:
	; setup next line in current fragment:
	; decrease fragmetn counter
	dec fc

	; load start points from xy[fragments[fi]]
	ldx fi


	; lda #'l'
	; jsr os_putc
	lda fragments, x
	; sta ARG0
	; jsr os_dbg_byte
	tay
	lda linesx, y
	sta x0
	lda linesy, y
	sta y0
	; load end points from xy[fragments[fi+1]]
	inx
	stx fi
	lda fragments, x
	; sta ARG0
	; jsr os_dbg_byte
	tay
	lda linesx, y
	sta x1
	lda linesy, y
	sta y1

	lda fc
	bne @no_next_fragment
	inc fi

@no_next_fragment:
	rts

advance_line_old:
	; old code
	; inc pi
	lda pi
	and #$3
	tax
	lda linesx, x
	sta x0
	lda linesy, x
	sta y0
	inx
	txa
	and #$3
	sta pi
	tax
	lda linesx, x
	sta x1
	lda linesy, x
	sta y1
	rts

render_square:
	jsr render_xline
	lda y0
	pha
	lda y1
	sta y0
	
	jsr render_xline

	pla
	sta y0

	jsr render_yline
	
	lda x0
	pha
	lda x1
	sta x0
	
	jsr render_yline

	pla
	sta x0

	rts

render_xline:
	ldx ii
	ldy x0

@loop:
	lda y0
	sta pointsy, x
	tya
	sta pointsx, x
	inx
	iny
	cpy x1
	bne @loop

	stx ii
	rts
	
render_yline:
	ldx ii
	ldy y0

@loop:
	lda x0
	sta pointsx, x
	tya
	sta pointsy, x
	inx
	iny
	cpy y1
	bne @loop

	stx ii
	rts
	
misc_testing:

@outerloop:
	ldx #0
	ldy #0

	jmp @square
@xyloop:
	stx IO_GPIO20
	stx IO_GPIO21
	inx
	bne @xyloop
	jmp @outerloop
	
	; cli
@yloop:
	sty IO_GPIO21
@xloop:
	stx IO_GPIO20
	inx
	bne @xloop
	iny
	bne @yloop
	jmp @outerloop
	
@square:
	; ldy #255
	sta IO_GPIO20
	sta IO_GPIO21


@loopx1:
	sta IO_GPIO20
	inc
	bne @loopx1

@loopy1:
	sta IO_GPIO21
	inc
	bne @loopy1
	
@loopx2:
	sta IO_GPIO20
	inc
	bne @loopx2
	ldy #0
	sty IO_GPIO20
@loopy2:
	sta IO_GPIO21
	inc
	bne @loopy2
	jmp @outerloop

abs_a:
	bpl @return
	eor $ff
	inc
@return:
	rts

invertxy:
	lda x0
	ldx x1
	sta x1
	stx x0
	lda y0
	ldx y1
	sta y1
	stx y0
	rts

swapxy:
	lda x0
	ldx y0
	sta y0
	stx x0
	
	lda x1
	ldx y1
	sta y1
	stx x1

	rts

setup_bresenham2:
	lda #0
	sta tw
@restart:
	lda #':'
	jsr os_putc
	lda x0
	sta ARG0
	jsr os_dbg_byte
	lda x1
	sta ARG0
	jsr os_dbg_byte
	lda y0
	sta ARG0
	jsr os_dbg_byte
	lda y1
	sta ARG0
	jsr os_dbg_byte
	lda x1
	sec
	sbc x0
	sta dx2
	lda dx2
	jsr abs_a
	sta absx
	sta ARG0
	jsr os_dbg_byte

	lda y1
	sec
	sbc y0
	sta dy2
	lda dy2
	jsr abs_a
	sta absy
	sta ARG0
	jsr os_dbg_byte

	; invariants:
	; - dx2, dy2 set to x/y distance (not yet doubled!)
	; - absx, absy are absolute x/y distances
	; - A contains absy (for following comparison)
	cmp absx
	bcc @flatslope; x>=y
	beq @flatslope; x>=y

	lda #'s'
	jsr os_putc
	; dy is larger 
	; check if dy is positive
	lda dy2
	bpl @dypos_st
	lda #'x'
	jsr os_putc
	; dy is larger than dx, but negative -> invert line and restart from scratch
	jsr invertxy
	jmp setup_bresenham2
@dypos_st:
	lda #'y'
	jsr os_putc
	; dy is larger than dx and positive -> swap x/y (rotate into q0 / q7 and enable twiddling)
	jsr swapxy
	lda #1
	sta tw
	; restart but keep twiddle state. in the next iteration dx must be larget so it will
	; dirctly go into flatslope case
	jmp @restart

@flatslope:
	lda #'f'
	jsr os_putc
	; dx is larger
	; check if dx is positive
	lda dx2
	bpl @dxpos
	; dx is negative -> invert line an restart from scratch. next iteration dx is still larger, but
	; will go to dxpos case.
	lda #'Y'
	jsr os_putc
	jsr invertxy
	jmp setup_bresenham2
@dxpos:
	; invariants:
	; - dx is larger than dy (flat slope)
	; - dx is positive
	;
	; check if dy is negative, store in neg
	lda #'X'
	jsr os_putc
	ldx #0
	lda dy2
	bpl @dypos_fl
	ldx #1
@dypos_fl:
	stx neg
	
	; invariants at this point:
	;  - tw and neg set correctly
	;  - slope is flat (octant 0 or 7)
	;  - dx is positive
	;  - A contains dy for following code
	; 
	; go ahead calculating initial D and proper 2*dx / 2*dy
	asl
	sta dy2
	sec
	sbc dx2
	sta d
	asl dx2
	jsr os_putnl

	rts

step_bresenham2:
	lda tw
	beq @notwiddle

	ldx y0
	ldy x0
	txa
	clc
	adc yoffs
	sta IO_GPIO20

	tya
	clc
	adc xoffs
	sta IO_GPIO21
	jmp @inc
@notwiddle:
	ldx x0
	ldy y0
	txa
	clc
	adc xoffs
	sta IO_GPIO21

	tya
	clc
	adc yoffs
	sta IO_GPIO20


@inc:
	lda d
	bmi @no_y
	lda neg
	beq @pos
	dey
	jmp @cont
@pos:
	iny
@cont:
	lda d
	sec
	sbc dx2
@no_y:
	clc
	adc dy2
	sta d
	inx
	cpx xe
	beq @reset
	stx x0
	sty y0
	jmp @end

@reset:
	jsr advance_line
	jsr setup_bresenham2
@end:
	rts
	
.RODATA
init_message:
	.byte "Press q to exit...", $00

; linesx:
; 	.byte 16, 32, 16, 0, 32
	
; linesy:
; 	.byte 0, 16, 32, 16, 32

linesx:
	.byte 0, 32, 32, 0, 16
	
linesy:
	.byte 0, 0, 32, 32, 16

fragments:
	.byte 4, 0, 1, 2, 3, 0, 2, 2, 4, 1, $ff
	; .byte 4, 0, 1, 2, 3, 0, $ff
