sim82/6502_sbc/17_dos_pagetable.asm

.code
.import fgetc, fputc, putc, print_message, print_hex8
.export init_pagetable, alloc_page, alloc_page_span, free_page_span, free_user_pages
.include "17_dos.inc"

PF_ALLOCATED =  %10000000 ; OPT: use highest bit to enable bmi in scan loop
PF_SPAN_START = %00000001
PF_SPAN_END =   %00000010
PF_USER =       %00000100
PF_STATIC =     %01000000

DOS_START_PAGE = $e0

.macro set_pagex_flag flag
	lda #flag
	sta PAGETABLE, x
.endmacro

.macro set_page_flag offs, flag
	ldx #offs
	set_pagex_flag flag
.endmacro

.macro alloc_static offs
	set_page_flag offs, PF_ALLOCATED | PF_STATIC
.endmacro

;;;;;;;;;;;;;;;;;;;;;;;;;;;;;;;;;;;;;;;;;;;;;;;;;;;;;;;;;;;;;;;;;;;;;;;;;;;;;
; init_pagetable

init_pagetable:
	save_regs
	ldx #$00
@clear_loop:
	set_pagex_flag $00
	inx
	bne @clear_loop
	
	; mark pages $00 - $05 and $f0 - $ff as static / allocated
	; (technically it is $05 'down to' $f0, via x underflow)
	ldx #$05
@lower_reserved_loop:
	set_pagex_flag PF_ALLOCATED | PF_STATIC
	dex
	cpx #(DOS_START_PAGE - 1)
	bne @lower_reserved_loop
	
	jsr clobber_free_pages
	restore_regs
	rts

;;;;;;;;;;;;;;;;;;;;;;;;;;;;;;;;;;;;;;;;;;;;;;;;;;;;;;;;;;;;;;;;;;;;;;;;;;;;;
; alloc_page:
; single page allocator

alloc_page:
	save_xy
	ldx #$00

@loop:
	lda PAGETABLE, x
	bpl @empty_page ; OPT: check highest bit
	inx
	beq @out_of_memory ; inx overflow -> reached end of pagetable
	jmp @loop

@empty_page:
	lda oss_user_process
	beq @no_user
	lda #(PF_ALLOCATED | PF_SPAN_START | PF_SPAN_END | PF_USER)
	jmp @write_entry

@no_user:
	lda #(PF_ALLOCATED | PF_SPAN_START | PF_SPAN_END)
@write_entry:
	sta PAGETABLE, x
	; set_pagex_flag 
	txa
	sec
	jmp @exit
	

@out_of_memory:
	clc
@exit:
	restore_xy
	rts

;;;;;;;;;;;;;;;;;;;;;;;;;;;;;;;;;;;;;;;;;;;;;;;;;;;;;;;;;;;;;;;;;;;;;;;;;;;;;
; alloc_page_span:
; page allocator for spans of 1..n pages

alloc_page_span:
	; fast path: jmp directly into single page allocator. This also simplifies the code below
	cmp #$01
	bne @multi_page
	jmp alloc_page
@multi_page:
	save_xy
	cmp #$00
	beq @out_of_memory
	
	sta zp_a_temp ; zp_a_temp contains requested span size

	ldx #$00 ; counter for start of span (OPT: store smallest free page index)

@outer_loop:
	ldy zp_a_temp ; restore span size
	stx zp_x_temp ; save start of current span (used in success case)
@inner_loop:
	lda PAGETABLE, x
	bmi @non_empty ; OPT: check highest bit
	
	dey
	beq @empty_span ; x zero -> found empty span

	inx
	beq @out_of_memory
	jmp @inner_loop


@non_empty:
	inx
	beq @out_of_memory ; iny overflow

	jmp @outer_loop

@empty_span:

; mark pages as allocated
	ldy zp_a_temp
	dey ; stop before last page. 
	ldx zp_x_temp 

	lda oss_user_process
	beq @no_user
	lda #(PF_ALLOCATED | PF_USER)
	jmp @cont

@no_user:
	lda #PF_ALLOCATED
@cont:
	sta zp_a_temp
	
@mark_loop:
	; set_pagex_flag PF_ALLOCATED
	sta PAGETABLE, x
	inx
	dey
	bne @mark_loop
	ora #PF_SPAN_END
	sta PAGETABLE, x
	; set_pagex_flag PF_ALLOCATED | PF_SPAN_END ; also set 'span end' bit on last page
	ldx zp_x_temp

	; a bit crappy, but keeps the loop simple: go back to first page and also set PF_SPAN_START
	; set_pagex_flag PF_ALLOCATED | PF_SPAN_START
	lda zp_a_temp
	ora #PF_SPAN_START
	sta PAGETABLE, x
	txa 
	sec
	jmp @exit

@out_of_memory:
	clc

@exit:
	restore_xy
	rts

free_page_span:
	sta zp_a_temp
	tax

	; check if a points towards a valid page span start
	lda PAGETABLE, x

	and #(PF_ALLOCATED | PF_SPAN_START)
	cmp #(PF_ALLOCATED | PF_SPAN_START)
	bne @error
	
	; clear until a page span end is found
	; NOTE: span start / end may be on the same page.
@loop:
	lda PAGETABLE, x
	tay
	lda #$00
	sta PAGETABLE, x
	tya

	inx 

	and #(PF_ALLOCATED | PF_SPAN_END)
	cmp #(PF_ALLOCATED | PF_SPAN_END)
	bne @loop

	sec
	rts
@error:
	clc
	rts


free_user_pages:
	ldx #$00
	ldy #$00
@loop:
	lda #PF_USER
	and PAGETABLE, x
	beq @no_clear

	tya
	sta PAGETABLE, x
@no_clear:
	inx
	bne @loop
	rts

clobber_free_pages:
	ldx #$00
	stx zp_al
@loop:
	lda PAGETABLE, x
	bmi @skip

	sta IO_GPIO0
	stx zp_ah
	ldy #$00
@inner_loop:
	; pure gimmick...
	lda #$de
	sta (zp_al), y
	iny
	lda #$ad
	sta (zp_al), y
	iny
	lda #$be
	sta (zp_al), y
	iny
	lda #$ef
	sta (zp_al), y
	iny
	bne @inner_loop
	
@skip:
	inx
	bne @loop

	rts
