sim82/6502_sbc/17_dos_event.asm

.export get_event, event_return
.import print_hex16, print_hex8, put_newline, fgetc_buf, putc
.import alloc_page_span, getc_blocking, putc, print_dec, put_newline, print_message, file_open_raw
.import get_argn, get_arg
.include "17_dos.inc"
.code


get_event:
	lda oss_resident_event
	ldx oss_resident_eventdata
	rts

event_return:
	sta oss_resident_return
	rts
