sim82/6502_sbc/bs02/src/parser.rs

use lrlex::lrlex_mod;
use lrpar::lrpar_mod;

lrlex_mod!("bs02.l");
lrpar_mod!("bs02.y");

pub use bs02_l::lexerdef;
pub use bs02_y::{parse, token_epp, Block, BlockElement, Expression, Operator, Statement};
