sim82/6502_sbc/(commit log)

2024-05-30 some testing with cc65 assembler
    [my_sbc.cfg]
2024-06-01 testing io read
    [my_sbc.cfg]
2024-06-26 extend prime range to 512 (one loop missing for full 16bit...)
    [12_sieve_16.asm]
2024-06-29 uart busy states & started mimon (mini monitor)
2024-07-02 finish uart prime program
2024-07-09 solved timing problem with full-speed receive on channel2
    doh, it is not a good idea to do blocking sends on the terminal while
    receiving full speed data on the other channel
    [17_dos.asm, lib.rs]
2024-07-10 added per-block handshake to program load (enable e.g. progress indicator)
    [my_sbc_ram.cfg, my_sbc_ramhigh.cfg, my_sbc_ramlow.cfg]
2024-07-22 wrote minimal bootloader to fit in $FF00 page (for later 'max ram' layout)
    [my_sbc_rombl.cfg]
2024-07-22 WIP: found a couple more bytes (use zp when possible)
2024-07-23 spent way too much effort on crappy windmill in bootloader
    (that looks crappy because of the stupid font, aaaahrghhhhh
    [18_bootload.asm, basic.asm, basic_bios.asm]
2024-07-28 some pcb layout
    [pcb01.kicad_pcb, pcb01.kicad_sch, pcb01_long_test1.kicad_pcb]
2024-07-30 more work on pcd layout
    [pcb01.kicad_pcb, pcb01.kicad_sch]
2024-07-31 wire in the R6552 uart
    [pcb01.kicad_pcb, pcb01.kicad_sch]
2024-08-02 add reset circuit and filter caps
    [pcb01.kicad_pcb, pcb01.kicad_sch]
2024-08-03 pcb layout should be finished...
    [pcb01.kicad_pcb, pcb01.kicad_sch]
2024-08-03 fix some schematic bugs
    [pcb01.kicad_pcb, pcb01.kicad_sch]
2024-08-04 pcb refinement
    [pcb01.kicad_pcb, pcb01.kicad_sch]
2024-08-04 small update
    [pcb01.kicad_pcb]
2024-08-04 connect GPIO0
    [pcb01.kicad_pcb, pcb01.kicad_sch]
2024-08-05 add gpio00 leds
    [pcb01.kicad_pcb, pcb01.kicad_sch]
2024-08-07 wire up GPIO0 leds, adapt design rules
    [pcb01.kicad_pcb, pcb01.kicad_sch]
2024-08-08 kind of final pcb design
    [pcb01.kicad_pcb, pcb01.kicad_sch]
2024-08-26 pcb checks
    [pcb01.kicad_sch]
2024-09-05 fixed errors of first pcb (hopefully didn't mess up everything)
    [pcb01.kicad_pcb, pcb01.kicad_sch]
2024-09-06 switch to top/bottom ground fill + VCC tree topology
    [pcb01.kicad_pcb]
2024-09-15 stupid ti uart somehow works (stops on reading STA... wtf?)
2024-09-15 ti uart works. R/WN is not allowed to change after CEN (clock qualified)
2024-09-16 dos console out on ti uart
2024-09-17 testing ti uart echo at 8MHz (from rom) & unqualified R/W botch
2024-09-22 ti uart integration & stress testing
2024-09-22 small power routing fix
    [pcb01.kicad_pcb]
2024-09-23 moving ti uart to fe2x (proto board 2 style)
2024-09-25 add initial support for fletch16 chksum, got sieve working again
    [my_sbc_ram.cfg]
2024-09-29 big chunk of new pcb done
    [pcb01.kicad_sch, pcb01_new.kicad_pcb]
2024-09-29 more routing
    [pcb01.kicad_sch, pcb01_new.kicad_pcb]
2024-09-30 finished mark2 pcb kind of
    [pcb01.kicad_sch, pcb01_new.kicad_pcb]
2024-10-01 add power switch etc
    [pcb01.kicad_sch, pcb01_new.kicad_pcb]
2024-10-02 finalized (?) pcb
    [pcb01.kicad_sch, pcb01_new.kicad_pcb]
2024-10-03 annotate values & add reset pull-up
    [pcb01.kicad_sch, pcb01_new.kicad_pcb]
2024-10-03 connect rom A15
    [pcb01.kicad_sch, pcb01_new.kicad_pcb]
2024-10-03 big pld reorder & break out unused pins
    [pcb01.kicad_sch, pcb01_new.kicad_pcb]
2024-10-03 mostly change resistors & caps to smd
    [pcb01.kicad_sch, pcb01_new.kicad_pcb]
2024-10-03 tested addrdec v3 & ordered mark2 board :-O
    [pcb01_new.kicad_pcb]
2024-10-04 add gitignore & cleanup & add forgotten files (hence the cleanup...)
    [my_sbc_ram_d000.cfg, my_sbc_rambottom.cfg]
2024-10-05 WIP: big cleanup
    [my_sbc_ram_d000.cfg, my_sbc_rambottom.cfg, my_sbc_ramhigh.cfg, my_sbc_ramlow.cfg, my_sbc_rel.cfg]
2024-10-05 initial crappy broken 'bytewise input' breaks on buffer boundaries
    [17_dos.asm, 17_dos_pageio.asm, uart_ti.asm]
2024-10-23 WIP: implement bytewise paged io
    The (IO_ADDR), y instead of IO_BUFFER, y store was a nasty bug, aarrgh stupid...
    [14_memtest.asm, 17_dos.asm, 17_dos_baseio.asm, 17_dos_pageio.asm, uart_ti.asm]
2024-10-23 byte io: uart
2024-10-23 remove debug prints
2024-10-23 WIP: still a bug on full page boundaries
    [17_dos_pageio.asm]
2024-11-24 fix stack clobbering, test relocating dos iteself (works)
    [17_dos_pageio.asm]
2024-11-25 tests with 4layer board
    [pcb01_4l.kicad_pcb]
2024-11-25 move dos to top of ram area
    [my_sbc_dos.cfg, my_sbc_ram.cfg, my_sbc_ram_basic.cfg, my_sbc_ram_d000.cfg, my_sbc_rambottom.cfg, my_sbc_ramhigh.cfg]
2024-11-25 test dos at bottom of ram
    [my_sbc_dos.cfg]
2024-12-21 dump uart stream
2024-12-21 Revert "test dos at bottom of ram"
    This reverts commit 878cf838c65c8298741a3975b358e308b50313cf.
    [my_sbc_dos.cfg]
2024-12-22 make IoB clock-qualified again
    Qualification was probably removed during initial ti uart experiments.
    This causes spurious IO blips (<10ns) on certain address transitions,
    and it is clearly a mistake, since the address bus is unstable during
    the first clock half.
2024-12-22 testing flow control
2025-01-02 fix stack clobbering in sieve
    [12_sieve_term.asm, 18_bootload_ti.asm]
2025-01-02 WIP: import symbol
    [my_sbc_rel.cfg]
2025-01-02 fix: broke allocator by adding debug output. aahhhhrg.....
    [17_dos.asm, 17_dos_pagetable.asm]
2025-01-03 fix nasty bug in relocation (I fucking HATE #)
    [17_dos_rel.asm]
2025-01-03 support bss segment, mostly rewrite reloc, bss sieve seems to work
    [my_sbc_rel.cfg]
2025-01-04 el-cheapo optimize pagetable init
2025-01-04 define initial os interface & port bss sieve
    [my_sbc_rel.cfg]
2025-01-05 'dos 3.x' release cycle: improve os interface & get rid of builtin rodents
    [my_sbc_rel.cfg]
2025-01-06 random updates
    [my_sbc_rambottom.cfg]
2025-01-06 start the mighty BS/02 language project
    use grmtools for the parser since it is stable and offers by far the best
    tools for nice error reporting (LR parser and CPCT+ beats all that
    newfangled stuff...).
    [build.rs, diagnostic.rs, lib.rs, main.rs, parser.rs]
2025-01-08 WIP: switch to 16bit
2025-01-19 WIP: 'event driven' os mainloop
    [my_sbc_rel.cfg]
2025-01-20 fix init message, add cancel (ctrl-c) and interrupt (ctrl-z)
    [17_dos.asm, 26_resident.asm]
2025-01-30 start 'os call' codegen
    [my_sbc_os.cfg]
2025-02-01 WIP: osgen generates ld65 cfg, import inc and relocator functable
    [ld65_config.cfg, my_sbc_os.cfg]
2025-02-01 use generated os.inc and ld65 config. seems to build...
    [my_sbc_os.cfg]
2025-02-03 add function description to osgen output
    [my_sbc_os.cfg]
2025-02-04 testing timer interrupt of ti uart. seems to just work...
2025-02-04 calculate timer div
2025-02-16 timer start maco
2025-02-17 WIP: unified timer / input irq handling
2025-02-18 irq driven key and timer events seem to work
2025-03-13 fix the famous infinite growth bug
    [27_snake.asm]
2025-03-24 WIP: debug file io problems with timer interrupts
    [my_sbc_os.cfg]
2025-03-25 disable interrupts during build page transfer
2025-03-25 add pseudo rng & use it in snake (WIP: there is no seed...)
    [my_sbc_os.cfg]
2025-03-26 make sure apple is not placed on snake (&some more fixes/cleanups)
    [27_snake.asm]
2025-03-27 add border (draw & collision), enforce apple pos inside border
    [27_snake.asm]
2025-04-06 WIP: port 8bit'ified sudoku solver from rust
    [my_sbc_os.cfg]
2025-04-07 WIP: still some addressing error...
    [28_sudoku.asm]
2025-04-10 what a fscking idiot...
    use sbc for the first time in your life in the most complicated bit
    fiddling mess imaginable. Earn stupid price
    other than that it would have worked first try (except one obvious #...)
    [my_sbc_os.cfg]
2025-04-11 add board loading and printing. works on most complex input I got
    it's about 2700x slower than my amd ryzen which works out nicely with the
    difference in clock speed and estimated instruction throughput.
2025-04-11 uhm... interrupt handling seems still a bit flaky
2025-04-12 second most moronic bug: clobber A reg in rom irq handler
    [17_dos.asm, 17_dos_pageio.asm, 18_bootload_ti.asm, 28_sudoku.asm]
2025-04-13 fix spurious input after ctrl-x, ctrl-z
    [17_dos.asm]
2025-04-14 warmboot message, keep interrupts enabled during dos
2025-04-14 WIP: plausibility check. seems broken...
    [28_sudoku.asm]
2025-04-21 Revert "testing 8bit interpolation"
    This reverts commit d688e0a0a104e1d354e26ed73890d265162afd8c.
    [29_pcm.asm]
2025-04-24 stupid bug: only reset timer if timer set in ISR...
    caused spurious timer drop outs...
    [17_dos.asm]
2025-04-24 handle timer irq first (timer reset is too slow for the 6502...)
    causes duplicate irq because interrupt line stays low too long
    [17_dos.asm]
2025-04-25 WIP: put pcm output into 'direct timer'
    [my_sbc_os.cfg]
2025-04-26 direct timer seems to work transparently
2025-04-27 correct bias for output amp table
    [17_dos.asm, 29_pcm.asm]
2025-04-28 wavetable loading (extra bonus: weird streaming mode if file is too big...)
    [29_pcm.asm]
2025-04-29 experiment: sync wavetable page boundaries to output buffer -> 'streaming'
    byte based file input is fast enough to stream 10000Hz audio over the
    UART. Could use paged IO + multiple buffers...
2025-05-01 move pcb design to kicad folder
    [bom.csv, designators.csv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]
2025-05-01 restructure pcb project, add initial backplane / io board projects
    [backplane.kicad_pcb, backplane.kicad_sch, bom.csv, cpu_board_02.kicad_pcb, cpu_board_02.kicad_sch, designators.csv, io_board_01.kicad_pcb, io_board_01.kicad_sch]
2025-05-04 start cpu_board_03, aka project 'mid integration'
    [cpu_board_03-B_Cu.gbr, cpu_board_03-B_Mask.gbr, cpu_board_03-B_Paste.gbr, cpu_board_03-B_Silkscreen.gbr, cpu_board_03-Edge_Cuts.gbr, cpu_board_03-F_Cu.gbr, cpu_board_03-F_Mask.gbr, cpu_board_03-F_Paste.gbr]
2025-05-08 routing cpu 3 board
    [cpu_board_03.kicad_pcb, cpu_board_03.kicad_sch]
2025-05-09 cleanup and routing
    [cpu_board_03.kicad_pcb]
2025-05-10 more routing on cpu board v3
    [cpu_board_03.kicad_pcb, cpu_board_03.kicad_sch]
2025-05-10 exclude kicad backups...
2025-05-11 shrink board
    [cpu_board_03.kicad_pcb, cpu_board_03.kicad_sch]
2025-05-11 DRCs pass...
    [cpu_board_03.kicad_pcb, cpu_board_03.kicad_sch]
2025-05-11 use socket footprint for xtal
    [cpu_board_03.kicad_pcb, cpu_board_03.kicad_sch]
2025-05-11 prepare addrdec rev.4 for Mark3 cpu board
2025-05-13 routing improvements
    [cpu_board_03.kicad_pcb, cpu_board_03.kicad_sch]
2025-05-13 disbale interrupts for non-reloc binaries (to get basic to work)
2025-05-22 testing file io via aux uart
2025-05-22 add pull-up and led to RDY (hope the 6502s are not fried...)
    [cpu_board_03.kicad_pcb, cpu_board_03.kicad_sch]
2025-05-26 WIP: testing for mark3 architecture
    [my_sbc_dos.cfg, my_sbc_ram_basic.cfg]
2025-05-26 added proper strobe write signal generation for output port
    [cpu_board_03.kicad_pcb, cpu_board_03.kicad_sch]
2025-05-28 switch to testing external uart only, remove clock from IoB
    [cpu_board_03.kicad_pcb]
2025-05-29 update label names
    [cpu_board_03.kicad_pcb, cpu_board_03.kicad_sch]
2025-05-29 update pcb
    [cpu_board_03.kicad_pcb, cpu_board_03.kicad_sch]
2025-05-29 cleaned up pullup mess
    [cpu_board_03.kicad_pcb, cpu_board_03_4l.kicad_pcb, cpu_board_03_4l.kicad_sch, pcb01_4l.kicad_pcb]
2025-05-30 add bus tranceiver OE signal
    [cpu_board_03.kicad_pcb, cpu_board_03.kicad_sch]
2025-06-02 route latest changes
    [cpu_board_03.kicad_pcb, cpu_board_03.kicad_sch]
2025-06-03 finished basic routing
    [cpu_board_03.kicad_pcb, cpu_board_03.kicad_sch]
2025-06-04 finished drc errors
    [cpu_board_03.kicad_pcb, cpu_board_03.kicad_sch]
2025-06-15 updated routing & semi-final checks
    [cpu_board_03.kicad_pcb, cpu_board_03.kicad_sch]
2025-06-15 uodate bus ow/wr signals
    [cpu_board_03.kicad_pcb, cpu_board_03.kicad_sch]
2025-06-16 optimized routing
    [cpu_board_03.kicad_pcb]
2025-06-17 optimize routing / grounding
    [cpu_board_03.kicad_pcb, cpu_board_03.kicad_sch]
2025-06-21 add GND testpoints
    [cpu_board_03.kicad_pcb, cpu_board_03.kicad_sch]
2025-06-21 us RN for status pullups
    [cpu_board_03.kicad_pcb, cpu_board_03.kicad_sch]
2025-06-21 fiddle around with led placement
    [cpu_board_03.kicad_pcb]
2025-06-23 cpu board & backplane as ordered
    [backplane.kicad_pcb, backplane.kicad_sch, cpu_board_03.kicad_pcb]
2025-07-10 update addrdec4 for mark3 board
2025-07-11 fix mark3 cpu board error: BE not connected
    [cpu_board_03.kicad_pcb, cpu_board_03.kicad_sch]
2025-07-22 minimal uart board
    [min_uart_board_01.kicad_pcb, min_uart_board_01.kicad_sch]
2025-07-22 pinout artwork
    [min_uart_board_01.kicad_pcb]
2025-08-02 testing dual-dac config for drawing on the oscilloscope...
    [my_sbc_os.cfg]
2025-08-02 Revert "add pull-up and led to RDY (hope the 6502s are not fried...)"
    This reverts commit 2887e05e7277e1a6f3acf461ea817119e14b00a9.
    [cpu_board_03.kicad_pcb, cpu_board_03.kicad_sch]
2025-08-09 add dbg_byte
    [my_sbc_os.cfg]
2025-08-27 initial experiments
    [vga_timing_01.kicad_pcb, vga_timing_01.kicad_sch]
2025-08-28 vga timing board 01 work
    [vga_timing_01.kicad_pcb, vga_timing_01.kicad_sch]
2025-08-28 WIP: 'complex' com board
    [com_board_01.kicad_pcb, com_board_01.kicad_sch]
2025-08-28 test kicad busses
    [vga_timing_01.kicad_pcb, vga_timing_01.kicad_sch]
2025-08-29 restoring min uart board from backup... some horrible mess happened
    [min_uart_board_01.kicad_pcb, min_uart_board_01.kicad_sch]
2025-08-29 min uart v1.1 -> almost all rounting on front layer
    [min_uart_board_01.kicad_pcb]
2025-08-29 WIP vga timing
    [vga_timing_01.kicad_pcb, vga_timing_01.kicad_sch]
2025-08-31 WIP: vga output
    [vga_mem_output_01.kicad_pcb, vga_mem_output_01.kicad_sch]
2025-09-02 more routing on 2 layer version (abandon for 4 layer version)
    [vga_mem_output_01.kicad_pcb, vga_mem_output_01.kicad_sch]
2025-09-02 vga mem output board 4 layer version
    [vga_mem_output_01_4l.kicad_pcb, vga_mem_output_01_4l.kicad_sch]
2025-09-04 added cpu side bus transceiver
    [vga_mem_output_01_4l.kicad_pcb, vga_mem_output_01_4l.kicad_sch]
2025-09-05 4l vga mem output routing improvements
    [vga_mem_output_01_4l.kicad_pcb, vga_mem_output_01_4l.kicad_sch]
2025-09-05 use hierarchical sheet for vga mem output
    [address_multiplexer.kicad_sch, vga_mem_output_01_4l.kicad_pcb, vga_mem_output_01_4l.kicad_sch, vga_output.kicad_sch]
2025-09-05 added clock circuit ('display generator')
    [address_multiplexer.kicad_sch, display_generator.kicad_sch, power.kicad_sch, vga_mem_output_01_4l.kicad_pcb, vga_mem_output_01_4l.kicad_sch, vga_output.kicad_sch]
2025-09-06 finished vga rework
    [display_generator.kicad_sch, power.kicad_sch, vga_mem_output_01_4l.kicad_pcb, vga_output.kicad_sch]
2025-09-06 routing fixes
    [address_multiplexer.kicad_sch, display_generator.kicad_sch, power.kicad_sch, vga_mem_output_01_4l.kicad_pcb, vga_mem_output_01_4l.kicad_sch]
2025-09-13 switch to VCC pour on signal layers, revised signal / ref assignments
    [address_multiplexer.kicad_sch, power.kicad_sch, vga_mem_output_01_4l.kicad_pcb, vga_mem_output_01_4l.kicad_sch]
2025-09-13 changed connector positions
    [vga_mem_output_01_4l.kicad_pcb]
2025-09-21 preparing for IDE controller: change IO select timing add initial pld file introduce log file to keep track of those changes
2025-09-22 continue hd controller waitstate logic (build open-collector stage)
2025-10-03 initial hd controller pcb
    [hdctl_01.kicad_pcb, hdctl_01.kicad_sch]
2025-10-04 hd controller rework. should be ready for mfg (need final check)
    [hdctl_01.kicad_pcb, hdctl_01.kicad_sch]
2025-10-04 added port on the side
    [hdctl_01.kicad_pcb, hdctl_01.kicad_sch]
2025-10-05 routing tweaks
    [hdctl_01.kicad_pcb]
2025-10-05 remove outdated 4l cpu 3 board
    [cpu_board_03_4l.kicad_pcb, cpu_board_03_4l.kicad_sch, pcb01_4l.kicad_pcb]
2025-10-05 cpu board mark 3 4 layer revision
    [cpu_board_03_4l.kicad_pcb, cpu_board_03_4l.kicad_sch, pcb01_4l.kicad_pcb]
2025-10-06 hdctl: update PLD pinout to pcb layout, add monting holes to pcb
    [hdctl_01.kicad_pcb, hdctl_01.kicad_sch]
2025-10-18 debugging hdctl pcb build
2025-10-18 final (?) hdctl pcb layout
    [hdctl_01.kicad_pcb, hdctl_01.kicad_sch]
2025-11-04 512byte block read seems to work (initial impl. was almost correct): - missed to init io ptrs (and then clobbered them with wrong values...) - adc 1 instead of 0 to high byte (ahhrg, 16bit arithmetic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
    [17_dos_baseio.asm, 17_dos_blockio.asm, 17_dos_rel.asm]
2025-11-05 rudimentary read from ide 'raw device' via OS IO interface works
2025-11-06 prepare os calls for simple uart -> ide 'dd like tool'
    [my_sbc_os.cfg]
2025-11-09 add set_lba function
    [my_sbc_os.cfg]
2025-11-09 WIP: restructure os state / zp: use proper symbols
    [my_sbc_dos.cfg]
2025-11-10 dd works, had to fix next_block eof handling.
    starting binaries directly from the raw device (#) also worked without
    problems first try.
    [17_dos_rel.asm, 17_dos_vfs_ide.asm, 17_dos_vfs_uart.asm, 33_diskdump.asm]
2025-11-11 WIP: put start / irq vecotrs into dos binary (VECTOR segment)
    [my_sbc_dos.cfg]
2025-11-12 replace hardcoded IDE io addresses
    [17_dos_vfs_ide.asm]
2025-11-16 managed to cram hd & uart into one 256byte bootloader
    very limited: only supports loading to $e000 - $fdff and from fixed LBA
    address with absolutely minimal error handling.
    -> think about increasing bootloader to 512bytes to make room for some
    luxury features.
    [18_bootload_hd.asm]
2025-11-17 WIP: start 2 stage bootloader
    [my_sbc_ram_1000.cfg]
2025-11-18 simplified stage 1 bootloader protocol
2025-11-30 fix: missed porting vfs uart to non-interleaved io block storage
    [17_dos_vfs_uart.asm]
2025-12-13 WIP: cfs1 -> vfs_ide bridge part 1 (missing: follow the actual links)
    [17_dos_cfs1.asm, 17_dos_vfs.asm]
